retrac0/retelex/mf8/mf8-spec.md

# Six-channel TDM digital voice carrier over differential Manchester

Six 64 kbps channels with a sub-commutated signalling channel in an 8-bit frame.
This is over one twisted pair each way.  It is implemented with discrete 74HC logic.  

A channel slot is a DS0: 64 kbps and octet-aligned, so 
it takes a CVSD voice card, a synchronous data card, or a
G.711 PCM stream.

Every number here was measured by `mf8.py` unless it is marked as analysis.
§15 lists what has not been measured.

> **This is the MF8 used on trunks.** Eight- and ten-bit frames were measured
> (`mf8_16.py`, `mf8_10.py`, `mf8_10_16.py`, `mf8_baud.py`; `exchange/analysis/eight-channel-mf8.md`)
> and are **not taken**.

## 1. What changed from `mfspec.md`, and why

| | `mfspec.md` | this spec |
|---|---|---|
| F bit | `1010`, period 2 | **`11111110`, period 8** |
| Superframe phase pinned by | two S-lane pads, 4 apart | **F itself** |
| Wrong superframe phases admitted | **56 of 64 hook states** | **0** |
| Acquisition | 8 alternating frames + one guard | **32 consecutive good frames** |
| Tracking after lock | *unspecified* | **+2/−1, floor 0, trip 12 — F and guard counted separately** |
| S position | beside F | **half a frame from F (§3.4)** |
| Guard | pads at states 3 and 7, valued as the F word is there | **states 0 and 4 = `0,1` (§3.2)** |
| Squelch / mute | *absent* | **required, §13** |
| Data slot rules | *absent* | **§5** |

The 8-bit geometry, the 6 × 64 kbps payload, the sub-commutated signalling and
the pads-at-binary-boundaries idea are all `mfspec.md`'s and are kept. What is
replaced is the part that decides where the frame is.

---

## 2. Frame and superframe

**Frame — 8 bits, 15.625 µs, 64 kHz:**

```
 bit:   0     1      2      3      4     5      6      7
      [ F ][ C1 ][ C2 ][ C3 ][ S ][ C4 ][ C5 ][ C6 ]
      000   001    010    011   100   101    110    111    <- mux address
```

S sits at bit 4, half a frame from F, and not beside it. That is the one
geometric choice in the frame, and §3.4 is why: the framing check reads F and S,
and at a wrong bit alignment those two reads land on two other lanes 4 apart.
With S beside F, two of the seven wrong alignments read one data card and one
F-word bit, and a single data card can hold either of them open. With S
opposite F, the F word can only ever land on itself.

**Superframe — 8 frames, 125 µs, 8 kHz:**

| state | 0 | 1 | 2 | 3 | 4 | 5 | 6 | 7 |
|---|---|---|---|---|---|---|---|---|
| **F** | 1 | 1 | 1 | 1 | 1 | 1 | 1 | **0** |
| **S** | **0** | A1 | A2 | A3 | **1** | A4 | A5 | A6 |

`An` is channel *n*'s signalling bit; the two fixed S bits are the guard (§3.2).
Signalling is one bit per channel per superframe — **8 kbps per channel**.

The S superframe mirrors the frame: channel *n*'s signalling bit sits at the
superframe state that is channel *n*'s bit position in the frame, so the
signalling multiplexer and demultiplexer use the frame multiplexer's address
map unchanged.

The superframe counter is the only phase state in the system, and it does three
jobs: it addresses the signalling demultiplexer, it carries the framing word,
and it is the octet counter (§6).

---

## 3. The F word

### 3.1 F — the word `11111110`

F carries an 8-bit word across the superframe, so **one check pins both the bit
alignment and the superframe phase.** The word is `11111110`: one zero, at
state 7.

Why this word and not the alternatives this project has already killed. The
figure is the longest run of consecutive frames a payload lane can match the
word, over every superframe phase — acquisition needs 32 in a row, so anything
below 32 is rejected *deterministically*:

| word | CVSD speech | CVSD silence | constant 1 | constant 0 | random |
|---|---|---|---|---|---|
| `10101010` — `mfspec` | 1369 | **8192 (the whole clip)** | 1 | 1 | 12 |
| `11101110` — period 4 | 4 | 3 | 3 | 1 | 14 |
| **`11111110`** | **4** | **3** | **7** | **1** | **20** |
| `11111100` | 5 | 2 | 6 | 2 | 14 |
| `11101100` | 7 | 3 | 3 | 2 | 14 |

`1010` *is* CVSD silence, which is why `mfspec`'s Stage 1 was no filter at all.
A period-4 word cannot pin an 8-state superframe. Of the three period-8 words
that work, `11111110` is chosen because its generator is the cheapest: F is 0
only at state 7, so

```
F = NAND(q2, q1, q0)        one 3-input gate, from the superframe counter
```

and the receiver forms the identical term from its own counter.

### 3.2 The guard — S at states 0 and 4

F alone is not sufficient, because a data card can carry the framing word. The S
lane supplies a second, independent condition: **S = 0 at state 0 and S = 1 at
state 4.**

Each part of that is load-bearing:

- **Same parity** (0 and 4 are both even) **with different required values.** A
  period-2 lane — CVSD silence, and the empty-slot fill — gives the *same* value
  at two same-parity states, so it fails deterministically.
- **Different from the F word at those states.** `11111110` is 1 at both state 0
  and state 4, so a data lane carrying the framing word satisfies F and fails the
  guard. `mfspec`'s pads were `1,0` at states 3 and 7 — *exactly* what the word
  does there — so the guard added no information: **192 of 512 false locks** on
  the F word (384 with S beside F), against **0** here.
- **The mirror.** With the guard at 0 and 4 the six hook bits sit at states 1, 2,
  3, 5, 6, 7 — the positions C1–C6 occupy in the frame — so the '259 and the
  '151 share one address map (§2).

The decode is one gate. States 0 (`000`) and 4 (`100`) are the two with
`q1 = q0 = 0`, and at those two the expected value is `q2` itself:

```
guard enabled  =  NOR(q1, q0)
guard expected =  q2
```

Any two same-parity states with different values pass the two tests above.
`mf8.py guard` measures four layouts, all 64 hook states × 8 skews per cell, and
adds the one thing that separates the clean ones: how often speech at nominal
level satisfies the guard four superframes running, which is what a chance
acquisition on §5's residual case needs.

| guard | decode | F word in every lane | one data card, worst seat | voice, 4 running |
|---|---|---|---|---|
| **0,4 = `0,1` — this spec** | NOR, expect `q2` | **0 / 512** | **0 / 512** | 1 in 499 |
| 3,5 = `1,0` — before §3.4 | `q0·(q1⊕q2)`, expect `q1` | 0 / 512 | 0 / 512 | 1 in 1 200 |
| 3,7 = `0,1` | AND, expect `q2` | 0 / 512 | 0 / 512 | 1 in 459 |
| 3,7 = `1,0` — `mfspec`'s values | AND, expect `/q2` | **192 / 512** | 0 / 512 | 1 in 484 |

Speech satisfies two states four apart more often than two states two apart, so
0,4 takes the residual about 2.4× as often as 3,5 did — and the guard counter
releases it either way (§5). That is the price of the mirror and the one-gate
decode, and it is small: one event in ~500 attempts at one skew, in one allowed
layout, costing a mute of about a millisecond.

**History.** The guard was at 3,5 until §3.4 moved S. With S beside F, 3 and 7
were unusable: a half-superframe shift maps them onto each other, with every
channel off-hook the S lane has a single zero and passes for F at exactly that
shift, and the guard then read *C1* — one data card in seat 1 false-locked on 1
of 512 start-ups, a layout §5 permits. 3,5 has no such symmetry and was chosen
for it. With S half a frame from F that shift reads the F lane instead of C1 and
is dead for any guard (§3.4), which is what freed the choice.

### 3.3 Why the superframe phase can no longer be held wrong

At offset *d* the receiver expects `11111110` and sees it rotated by *d*. For
every *d* ≠ 0 that mismatches at **2 frames in every 8**, so the longest possible
run of good frames is 6 — against the 32 that acquisition requires:

| offset | frames matching of 8 | longest good run |
|---|---|---|
| 0 | 8 | (indefinite) |
| 1 … 7 | 6 | **6, 5, 4, 3, 4, 5, 6** |

**Hook states cannot enter into it**, which is the whole difference from
`mfspec.md`: there the phase was pinned only by two pads gated by hook bits, and
56 of 64 hook combinations admitted a wrong phase. Enumerated here over all 64
hook states: **0 admissible wrong superframe phases.**

### 3.4 Where S sits — half a frame from F

The check reads two bits, F at bit 0 and S at bit 4. At a wrong bit alignment,
skew *d*, the receiver reads bit *d* as F and bit *d*+4 as S, and *which lanes
those are* decides whether the wrong alignment can be held:

| skew | read as F | read as S | |
|---|---|---|---|
| 1, 2, 3 | C1, C2, C3 | C4, C5, C6 | two payload lanes, three seats apart |
| **4** | **S** | **F** (next frame) | **the F word on itself** |
| 5, 6, 7 | C4, C5, C6 | C1, C2, C3 (next frame) | two payload lanes, three seats apart |

At skew 4 the S lane passes for the word only with every channel off-hook
(`01111111` — one zero, at the guard's own state), and the F lane then reads
`1,1` at the guard states, where the guard wants `0,1`. That fails for every
hook state, deterministically. Every other wrong alignment reads two payload lanes, and a
voice or idle lane fails one half of the check or the other (§3.1, §3.2). So a
wrong alignment can be held only when **both** lanes are data cards, three seats
apart — which is §5's rule, and the whole of it.

**With S beside F**, at bit 1 — the previous layout — the table reads
differently. Skew 1 reads S as F and C1 as the guard; skew 7 reads C6 as F and
the *next frame's F* as the guard. Each of those is **one data card plus the
F word**, and the F word is fixed content, so a single data card holds either
open on its own. As found, with the guard then at 3,5:

- **Seat 6, byte `0x7F`.** `01111111` in C6 passes for the word, and the real F
  lane, two states on, reads exactly `1,0` at the guard states. Nothing else is
  involved — not the hook state, not the other seats. With b0 as the MSB that
  byte is **G.711 μ-law silence**, on the very DS0 §6 advertises.
- **Seat 1, any of 64 bytes** (b1 = 1, b3 = 0; `0x40` is one), with every
  channel off-hook. S is `11111011` and passes for the word; the guard then
  lands on C1 two states early and wants 1 at bit 1 and 0 at bit 3.
- **Seat 1 *voice*, every channel off-hook.** The same path with speech under
  the guard, which passes it four superframes running about once in a thousand
  attempts at that skew (§3.2's last column is that rate, per guard) — and once
  acquired, held for good (§4).

Every guard has its own pair of these; under the present 0,4 guard the same two
classes are `0xFB` in seat 6 and the 64 bytes with b1 = 0 and b5 = 1 in seat 1,
which is what `mf8.py sbit` now prints and confirms.

Measured, `mf8.py sbit`: every byte a data card could carry, in every seat,
under all 64 hook states, CVSD idle elsewhere, analytically — a wrong alignment
that passes the check for one superframe passes it forever on periodic lanes —
and then confirmed with the framer, 64 hook states × 8 skews:

| | S at bit 1, beside F | **S at bit 4, this spec** |
|---|---|---|
| one data card: bytes that hold a wrong alignment | seat 1: **64**; seat 6: **1**; seats 2–5: 0 | **0 in every seat** |
| two data cards, the F word in one and every byte in the other: unsafe pairs | every pair containing seat 1 or seat 6, and every adjacent pair — only (2,4) (2,5) (3,5) safe | **(1,4) (2,5) (3,6)** and no others |
| the worst byte in seat 6, framer (`0x7F` under 3,5; `0xFB` now) | **448 / 512** false locks, all held to the end | 0 / 512 |
| the worst byte in seat 1, framer (`0x40` under 3,5; `0x04` now) | **1 / 512** (every channel off-hook), held | 0 / 512 |

None of this was visible to the earlier battery, whose "worst content" was one
fixed pattern at one alignment — the F word, and `00010000` — and both holes
need a different byte. The sweep over every byte is what §5 now runs.

4 is the only spacing that does this. A spacing *s* puts S on F's position at
skew *s* and F on S's position at skew −*s*; those are the same alignment, with
nothing else in it, only when 2*s* ≡ 0 mod 8. It costs nothing: S is a mux
input and a sample strobe, and both move from bit-count 1 to bit-count 4.

### 3.5 A seventh S bit — not in this spec

The guard spends two of the eight S states. One fixed bit cannot replace them:
a single bit cannot reject a period-2 lane, so a data card carrying the F word
holds a wrong alignment beside *idle* at half the idle phases (measured: 4 bytes
in every seat). Two ways of freeing one state were measured at the frame layer
and are recorded here as possible expansions, **not specified**:

| | complement pair | alternating bit |
|---|---|---|
| S lane | `[x][A1][A2][A3][/x][A4][A5][A6]`, x free | `[q3][A1][A2][A3][A4][A5][A6][A7]`, q3 = a fourth superframe-counter stage |
| receiver check | at state 4, S ≠ the '259's Q0 (which holds x from state 0) | at the guard state, S = own q3, read from the line once at acquisition |
| new state | none | a 16-frame phase the receiver must acquire |
| parts | one inverter at TX, one XOR at RX | TX free ('393 stage); RX a loadable `q3` flip-flop, a first-strobe flag and a mux, ≈ 1½ packages |
| holes, every byte × every seat × 128 hook/spare states | 0; pairs (1,4) (2,5) (3,6) as now | 0; pairs as now, even against 16-frame patterns |
| §5's residual, chance acquisition | 1 in 28 attempts | 1 in 10 |
| release by the guard counter | 2.2 ms mean (one check per superframe) | 2.5 ms mean |
| line errors, 3e−02, 3 s | 0 trips; 0.10% down | 0 trips |

The complement pair is the better of the two on every line, and it is what a
seventh bit — a remote-alarm indication, say, since nothing here tells the far
end that this end has lost frame — should be built on. Its cost against the
fixed guard is the residual, 1 in 28 against 1 in ~500, and one check per
superframe instead of two. (A third variant, the complement pair with x
alternating and the receiver checking *both* states against Q0, kills every
8-periodic lane outright but frees nothing and tripped 7 times in 3 s at 3e−02
BER, so it is not recorded further.)

**Decided: x is the remote alarm.** An end holds x at 1 while its own receiver
is not locked (`MUTE`), and a receiver takes x at 1 for 32 ms as the alarm. Idle
is x = 0, which is today's fixed guard. Between exchanges the same bit also
carries SS0's messages (`exchange/proposed/ss0.md`). A message holds x at 1 for 17 ms
at most, so the one 32 ms rule serves both kinds of link. The pair itself is not
yet written into §2–§4 or §11.

---

## 4. Framer

One check, one acquisition counter, two up/down counters. The reference model is
`mf8.framer`.

```
good frame :=  F == word[sfc]
               AND ( sfc != 0  OR  S == 0 )
               AND ( sfc != 4  OR  S == 1 )

acquire    :  the word has exactly one zero, at state 7, so F == 0 IS the phase
              marker.  At a bit alignment with no candidate phase yet:
                  F == 0             -> load sfc = 7, start the count
                  8 frames, no zero  -> this cannot be the F lane, so slip one
                                        line bit and hunt at the next alignment
              With a candidate, the check is predictive; any mismatch slips one
              line bit and restarts the hunt.  Lock at 32 consecutive good frames.

track      :  the same check, +2 bad / −1 good, floor 0, trip at 12 — on two
              counters.  One is fed by every frame.  The other is fed only at
              the guard states, 0 and 4, by the S half of the check alone.
on trip    :  either counter: not locked, slip one line bit, acquire again.
```

**The superframe phase is read, not searched.** That makes acquisition a search
over 8 bit alignments rather than 8 × 8 combinations, and it is what lets slip
recovery be 8–15 frames (§4.2). The 32-frame count is §4's.

**Why +2/−1 and not +1/−1.** A `+1/−1` counter trips only when more than *half*
of frames fail. At a wrong alignment this check fails at almost exactly half —
the word is seven ones and one zero, so a random payload lane matches it 50% of
the time — and the counter random-walks instead of climbing. Measured over the
line at 10 impulses/s, a transient false lock held **28 050 frames** with
`+1/−1`. `+2/−1` trips above a *third*, which that 50% clears easily, and
§4 measured `+2/−1` as the correct pairing for a **predictive**
check, where one line error spoils one frame rather than four. §4.2 shows it
costs nothing in false reframes.

Both of these were found by running the chain end to end (§7). Neither was
visible at bit level: on clean data the old search locked at frame 31 and the old
counter never tripped.

**Why a second counter for the guard.** The guard is 2 checks in 8. On the frame
counter, a lock whose F check always passes and whose guard *never* does gains 4
and loses 6 per superframe: it peaks at 3 against a trip of 12 and holds
forever. With one counter, then, the guard protects acquisition and nothing
else, and any wrong alignment that passes the word deterministically but the
guard only by chance — a data card carrying the F word three seats from a voice
card, §5 — is permanent once acquired. Fed by the guard states alone, the second
counter trips above a third of *guard* checks failing. Voice under the guard
fails about half of them, and §5 measures the release in milliseconds; line
errors at 3e−02 fail 3% of them, and §4.2 measures 0 trips in 6.25 s. It is one
more 74HC193, clocked by the guard enable the decode already produces (§11).

### 4.1 False locks — measured

Every start-up skew, every payload class this project has used to break a framer,
plus the adversarial case constructed against *this* F word:

| payload | locks | **false** | wrong sf phase | acquisition, frames |
|---|---|---|---|---|
| speech | 8/8 | **0** | **0** | 37–54 |
| idle (CVSD silence) | 8/8 | **0** | **0** | 37–54 |
| all constant 0 | 8/8 | **0** | **0** | 37–46 |
| all constant 1 | 8/8 | **0** | **0** | 38–78 |
| random data | 8/8 | **0** | **0** | 37–54 |
| octet `10110010` | 8/8 | **0** | **0** | 37–54 |
| one data card + idle | 8/8 | **0** | **0** | 37–54 |
| one data card + speech | 8/8 | **0** | **0** | 37–54 |
| **the F word as data** | 8/8 | **0** | **0** | 38–86 |
| the F word beside silence | 8/8 | **0** | **0** | 37–62 |
| **the F word three seats from a guard-satisfying pattern** | 8/8 | **3** | **0** | 37–38 |
| `0xFB` in seat 6, rest idle — §3.4's first hole, under this guard | 8/8 | **0** | **0** | 38–54 |
| `0x04` in seat 1, rest idle — §3.4's second hole, under this guard | 8/8 | **0** | **0** | 37–46 |

Exhaustively over all 64 hook-state combinations × all 8 skews — 512 trials per
row — **0 false locks and 0 wrong superframe phases** on idle, both constants,
one data card, the F word in every lane, the F word beside silence, and both of
§3.4's holes.

**The F-word-and-pattern row is the exception, and it is not closed by the
framer.** Two data cards *three seats apart*, one carrying the framing word and
the other a pattern that satisfies the guard, hold a wrong alignment: 3 of 8
skews here, 192 of 512 exhaustively. At a wrong alignment the F check lands on
one lane and the guard on the lane three seats on (§3.4), so with both lanes
unconstrained there is nothing left to gate them. **No confirmation count
reaches it** — the match is exact, not probabilistic — so it is closed by a slot
rule instead. That is §5, and it is the one real cost this frame carries.

Acquisition is **37–86 frames, 0.58–1.3 ms** at a 64 kHz frame rate.

### 4.2 Line errors and slip recovery — measured

6.25 s of random payload, tracking with both `+2/−1` trip-12 counters:

| line BER | locked frames | **LOF events** | of which the guard counter | off-phase frames | time down |
|---|---|---|---|---|---|
| 0 | 399 961 | **0** | **0** | **0** | 0.01% |
| 1e−04 | 399 961 | **0** | **0** | **0** | 0.01% |
| 1e−03 | 399 937 | **0** | **0** | **0** | 0.02% |
| 1e−02 | 399 937 | **0** | **0** | **0** | 0.02% |
| **3e−02** | 399 801 | **0** | **0** | **0** | 0.05% |

Zero loss-of-frame events to 3e−02, which is §4's standard, and **the guard
counter never trips on line errors**: at 3e−02 it sees 3% of its checks fail
against the third it needs. For contrast, `mfspec.md` with no counter took
**10 011 unlocks and 60.7% downtime at 1e−02** on the same class of line (§4).

Recovery after an induced slip, every slip size:

| slip, bits | 1 | 2 | 3 | 4 | 5 | 6 | 7 |
|---|---|---|---|---|---|---|---|
| frames misaligned | 12 | 8 | 8 | 10 | 11 | **13** | **13** |

**Worst case 13 frames = 0.20 ms.** Reading the superframe phase
from the marker rather than searching for it is what does this: there is no
second phase to re-find, so recovery costs little more than re-finding the bit
alignment. (An earlier nested-search version of §4 measured 35–176 frames here.)

---

## 5. Slot rules

One rule, and it is measured rather than argued:

> **Two data cards may not sit three slots apart: not 1 and 4, not 2 and 5, not
> 3 and 6.**

A voice channel is CVSD and cannot hold a wrong alignment. A data card can carry
anything, including the framing word — and at a wrong alignment the F check lands
on one lane while the guard lands on the lane *three seats on* (§3.4), so two
data cards three apart can satisfy both halves with neither constrained. §3.4
shows that is the only way the check can be held, so it is the only rule.

`mf8.py seats` measures it three ways.

**Exhaustively, over content.** Every byte a data card could carry, in every
seat, under all 64 hook states, CVSD idle elsewhere, checked analytically: a
wrong alignment that passes the check for one superframe passes it forever on
periodic lanes, and no tracking rule can then see it.

| layout | wrong alignments held |
|---|---|
| one data card, **any** seat, **any** of the 256 bytes | **0** |
| two data cards, the F word in one and **every** byte in the other — (1,2) (1,3) (1,5) (1,6) (2,3) (2,4) (2,6) (3,4) (3,5) (4,5) (4,6) (5,6) | **0** |
| two data cards, **(1,4) (2,5) (3,6)** | **held**, for 65 of the 256 bytes in either seat, under every hook state |

**With the framer**, all 64 hook states × 8 skews, 512 start-ups per row, the F
word as the data card's content and voice elsewhere:

| layout | false locks | still wrong at the end |
|---|---|---|
| one data card, **any** seat | **0 / 512** in every seat | 0 |
| two, the F word and a guard-satisfying pattern (`0x08`: bit 0 = 0, bit 4 = 1), **adjacent**: (1,2) (3,4) (5,6) | **0 / 512** | 0 |
| six data cards, ordinary **random** content | **0 / 512** | 0 |
| **two, the same content, three apart: (1,4) (2,5) (3,6)** | **64, 128, 192 / 512** | **all of them** |

Note the third row: **ordinary data is safe in every seat.** The hole needs the
framing word specifically, not merely arbitrary content, which is why the rule is
about spacing and not about scrambling.

**The residual, and the guard counter.** The rule is about two data cards. A data
card carrying the F word three seats from a *voice* card is allowed, and the
guard then lands on speech, which satisfies it by chance: at nominal line level
both guard bits fall right in about 20% of superframes, and four superframes
running — what acquisition needs — about once in 499 attempts at that skew.
That is what §4's second counter is for. Forced at 24 such points, 0.5 s runs:

| tracking | acquired | released after | mean | never released |
|---|---|---|---|---|
| frame counter only | 24 / 24 | — | — | **24** |
| **frame counter + guard counter — this spec** | 24 / 24 | **34–170 frames** | **1.29 ms** | **0** |

Each release is followed by a hunt that finds the true alignment; the cost of the
event is a mute of a few milliseconds, not a call with the wrong channels in it.

This is the same kind of rule a 4-bit static framing word needs ("any seat, but
never two adjacent"); here the forbidden spacing is three because S is at bit 4.
A frame that carries a signalling bit in *every* frame can avoid needing it, by
jumpering that bit high so one half of the check is never arbitrary data — a bit
this frame does not have, because signalling is sub-commutated into the
superframe. **That is the price of §2's efficiency, stated plainly: three data
cards of six, not six — 1,2,3 or 4,5,6, or any three with no two three apart.**

---

## 6. Octet alignment — the slot is a DS0

The superframe counter is **already the octet counter.** It has 8 phases, a
channel takes one bit per frame, so superframe state *k* is bit *k* of that
channel's octet:

```
superframe state   0   1   2   3   4   5   6   7
signalling S       0  A1  A2  A3   1  A4  A5  A6    -> the '259 address
channel n octet   b0  b1  b2  b3  b4  b5  b6  b7    -> the byte boundary
```

At a 64 kHz frame rate the superframe rate is 64/8 = **8 kHz, the PCM sample
rate exactly**, so one superframe carries one sample. A PCM card is a shift
register clocked by the frame clock and transferred at state 7 — one 74HC164 and
a latch per channel.

This matters because a framer that establishes bit alignment and slot identity
establishes nothing coarser, so a plain synchronous pipe is not octet-aligned and
the endpoints must find their own byte phase. Here it is aligned, for no extra
logic, and the slot is a true DS0 rather than merely a 64 kbps pipe.

**It depends entirely on §3.3.** If the superframe phase could be held wrong — as
it could in `mfspec.md` — a wrong phase would rotate every PCM sample and produce
garbage audio on a link that is otherwise bit-perfect. The phase is worth pinning
properly for signalling alone; carrying octets on it makes that mandatory.

---

## 7. End to end, over the line

`mf8_line.py`. Six independent LibriSpeech talkers → CVSD 64 kbps → the mf8
frame → a real waveform in both line codes → 1.8 MHz cable → impairment →
receiver → framer → per-channel CVSD decode. 1.0 s clips.

segSNR is scored inside the **longest contiguous locked run**, against the same
codec bits over the **same window** with no link in the path, so the "Δ" column
is what the *carrier* adds. The frame offset is found rather than assumed,
because a slip re-phases the stream and can rotate the channel slots.

### 7.1 A clean line is transparent

| code | segSNR | down | LOF | Δ mean | Δ worst | max BER |
|---|---|---|---|---|---|---|
| differential Manchester | 22.52 dB | 0.06% | **0** | **+0.00** | **+0.00** | **0** |
| AMI | 22.52 dB | 0.06% | **0** | **+0.00** | **+0.00** | **0** |

Per channel, differential Manchester:

| channel | 1 | 2 | 3 | 4 | 5 | 6 |
|---|---|---|---|---|---|---|
| segSNR | 21.05 | 14.90 | 29.33 | 24.64 | 15.28 | 29.89 |
| vs codec | **+0.00** | **+0.00** | **+0.00** | **+0.00** | **+0.00** | **+0.00** |
| bit BER | 0 | 0 | 0 | 0 | 0 | 0 |

**The carrier adds exactly nothing**, in either code. The 15–30 dB spread across
channels is the talkers' own crest factors, not slot position — the Δ row is
+0.00 for all six. Isolation: off-diagonal 0.134 against a source-correlation
floor of **0.129 measured on the same 1.0 s window**, an excess of +0.005. (The
0.009 floor in §9.3 is for 30 s clips; a short window
correlates more by chance, and reading an off-diagonal against a mismatched floor
is the error that section records.) With BER identically zero the recovered bits
*are* the transmitted bits, so crosstalk is exactly zero by construction and the
matrix can only report its own floor.

### 7.2 Noise — and the two codes fail differently

| condition | differential Manchester | AMI |
|---|---|---|
| sd 0.3 | +0.00 dB, 0 LOF | +0.00 dB, 0 LOF |
| sd 0.4 | **+0.00 dB**, 0 LOF | −0.10 dB, 0 LOF |
| sd 0.5 | **+0.00 dB**, 0 LOF | **−3.63 dB**, 0 LOF |
| sd 0.6 | **−0.01 dB**, 0 LOF | **−12.74 dB, 1 LOF** |
| sd 0.7 | −0.50 dB, **4 LOF**, 600 ms clean | chopped, 23 LOF |
| impulse 1/s | +0.00 dB, 0 LOF | +0.00 dB, 0 LOF |
| impulse 10/s | −0.00 dB, 5 LOF | −0.49 dB, 0 LOF |
| impulse 100/s | chopped, 71 LOF | −7.77 dB, 10 LOF |
| atten 0.25 | **+0.00 dB**, 0 LOF | −0.10 dB, 0 LOF |
| atten 0.12 | chopped, 431 LOF | chopped, 51 LOF |

Differential Manchester is transparent to sd 0.6 where AMI is degraded from 0.4,
which is `line-codes.md` §3's raw-BER result now heard as audio.

**The interesting column is not which is better but how each fails.** AMI's
audio falls first — 3.6 dB down at sd 0.5 with the link up — and by sd 0.6 it
is 12.7 dB down and losing frame as well. Differential Manchester holds both to
sd 0.6 and then breaks: at sd 0.7 its audio inside a clean stretch is only
−0.50 dB, but the link drops four times in a second. **AMI degrades in fidelity first;
differential Manchester degrades in continuity only.** That is the same split
`line-codes.md` §4.3 found under impulse noise, and it holds on a Gaussian floor
too. For voice behind a mute (§11), continuity is the one that is audible as
damage, which is a point in AMI's favour that the raw margin figures hide.

**The marginal cells move between noise realizations.** The run before this
one, with S beside F, had AMI at sd 0.6 with 0 LOF and −16 dB; moving S changed
the line bits under the same seeded noise, and this run has 4 LOF. Re-running
the old layout with a second seed also gives 4, and the impulse 10/s cell gives
5 or 8 LOF by seed under either layout. The guard counter (§4) is not involved:
on the same received bits it trips 0 times in every cell here, and the frame
counter alone gives identical counts. What is stable is the order in which the
two codes fail; the LOF count in any one marginal cell is one draw.

**The codec law moved this table (§12.1).** It changes every payload bit, so the
line bits under the same seeded noise change too, and the LOF counts are a new
draw — 4 and 5 LOF where the previous law had 5 and 5, 1 where it had 4. What
did not move by chance is the Δ at a given error rate. Differential Manchester
at 10 impulses/s has the same 4.9e−04 bit error rate and the same 5 LOF under
both laws, and costs −0.00 dB where the previous law cost −1.83. AMI at sd 0.5
went from −5.35 to −3.63 dB at the same order of BER. That is the 1 ms
integrator forgetting an error three times sooner, `cvsd_law.py laws`' bit-error
columns heard over the line. Run on the previous law, this battery reproduces
its old log to the last digit.

### 7.3 What this found in the framer

Both defects in §4 were found here and are invisible at bit level:

| | symptom on clean data | symptom over the line |
|---|---|---|
| nested acquisition search reached only even superframe offsets | lock at frame 31 | lock at frame **41 082** after one impulse-induced slip |
| `+1/−1` counter against a check that fails at 50% | never tripped | transient false lock held **28 050 frames** |

Neither would have been caught by any amount of further bit-level testing. That
is the argument for this section existing.

---

## 8. Rates and the family

F + S + N channels must be a power of two, so **N = 2, 6, 14**.

| frame | N | per-channel | line | baud | capacity | reach | superframe |
|---|---|---|---|---|---|---|---|
| 4 b | 2 | 64k | 256k | 0.512 M | 128k | **1.00×** | 4 fr |
| **8 b** | **6** | **64k** | **512k** | **1.024 M** | **384k** | 0.71× | **8 fr** |
| 8 b | 6 | 32k | 256k | 0.512 M | 192k | **1.00×** | 8 fr |
| 16 b | 14 | 32k | 512k | 1.024 M | 448k | 0.71× | 16 fr |

**This spec is N = 6 at 64 kHz.** It is the only mode that is one-for-one with a
DS0 (§6). Reach is the √f law scaled to `frame-rate.md` §1's reference — ratios
sound, kilometres not measured. `frame-rate.md` analyses the choice; the short
version is that line rate sets reach and frame length decides how it is divided,
so 64 kbps channels are available at any reach, at two of them for 1.00× or six
for 0.71×.

Only N = 6 is specified here. The other frame lengths need their own F word and
guard positions, and the mis-jumper case between them is **not measured**.

---

## 9. Line code — differential Manchester

Unchanged from §9, and not re-measured; the frame layout cannot affect
the line code.

- Transition at **every** cell boundary. This is the clock.
- An additional transition at mid-cell **iff** the data bit is 0.

At 512 kbps: **1.024 MBaud**, 977 ns half-cell, 512 kHz maximum fundamental.
Two-level, DC-free with disparity bounded at ±1 cell, polarity-blind (verified
bit-identical under a tip/ring swap, `line-codes.md` §12), and a transition every
bit so clock recovery never starves.

**Oscillator: 4.096 MHz.** It divides every family rate exactly and reaches the
2.048 MHz half-bit clock the top rate needs. Note that `mfspec.md` §2 specified a
512 kHz master clock, which is *half* what the modulation requires — a half-bit
clock at 1.024 MHz cannot be divided down from 512 kHz.

`line-codes.md` records the one open question: AMI is measured better under
impulse noise and worse on Gaussian noise and attenuation, and which matters is a
plant measurement nobody has made.

### 9.1 Oscillator and clock chain

**4.096 MHz**, a standard E1-family value. It is the lowest crystal that reaches
the 2.048 MHz half-bit clock of the fastest family rate, with the one divide a
Pierce oscillator's duty cycle needs. Nothing on the card needs a faster clock.

```
4.096 MHz ─→ 74HC4040 prescaler ─→ RATE jumper ─→ LINE_HB, half-bit clock
                                                       │
                                                 ÷2 ─→ H, line bit clock
```

| rate jumper | line rate | LINE_HB (half-bit) | H (line bit) |
|---|---|---|---|
| Q1 | 1024 kbps | 2.048 MHz | 1.024 MHz |
| **Q2** | **512 kbps — this spec** | **1.024 MHz** | **512 kHz** |
| Q3 | 256 kbps | 512 kHz | 256 kHz |
| Q4 | 128 kbps | 256 kHz | 128 kHz |
| Q5 | 64 kbps | 128 kHz | 64 kHz |

The frame counter is clocked from H rather than taken as a tap on the prescaler.
The rate jumper moves the half-bit tap, so on one ripple chain the frame counter
would move with it and the mux address would need a matrix of jumpers. Re-clocked
from H, its bits sit on fixed pins at every jumper. **That one 74HC393 is the whole
price of the rate jumper.**

**Accuracy is nearly irrelevant.** The far-end receiver tolerates ±13% of a cell
and the oscillator contributes ~0.01%. Specify the crystal for unit-to-unit
repeatability, not accuracy.

**Ripple.** The skews that matter are within the frame counter, two or three
stages of a '393 — tens of nanoseconds against a settling budget of half a cell,
977 ns here. Scope it at bring-up.

### 9.2 Encoder circuit — one gate, one flip-flop

§9.2, unchanged. Let `H` be the half-cell phase (0 in the
first half of a line cell, 1 in the second) and `LINE_HB` the half-bit clock:

```
        line bit ──┐
                   ├── NAND ──> EN ──┬── J ┐
        /H ────────┘                 └── K ┤ 74HC74/109  ──> line
                                           │  clocked by LINE_HB
        LINE_HB ────────────────────────────────┘

EN = NAND(/H, line bit) = H OR NOT(line bit)
```

| H before edge | line bit | EN | behaviour |
|---|---|---|---|
| 1 | 0 | 1 | entering a new cell — boundary transition, always |
| 1 | 1 | 1 | entering a new cell — boundary transition, always |
| 0 | 0 | 1 | mid-cell — transition, encoding a 0 |
| 0 | 1 | **0** | mid-cell — **hold**, encoding a 1 |

A JK wired J = K = EN toggles when EN is high and holds when it is low, which is
exactly the code. H and the flip-flop are both clocked from LINE_HB; the JK samples
H's value from *before* the edge, so same-edge synchronous clocking is correct,
but it depends on the divider's clock-to-Q exceeding the JK's hold time. 74HC
satisfies that comfortably — **check it against the specific parts, because a
hold violation works on a warm bench and fails at temperature.**

### 9.3 Output stage and line interface

| item | specification |
|---|---|
| Driver | 75176 differential transceiver, driver half |
| Series matching | two ~50 Ω resistors into the 100–135 Ω pair, ~25 mA from a 5 V swing; trim against the actual cable |
| Slew limiting | **150 ns edges**, one series R with a shunt C, switched by the rate jumper. At 1.024 MBaud that is 15.4% of a 977 ns half-cell — still inside the eye, but tighten toward 75 ns if the eye matters more than radiated emissions. Do not skip it: a raw 75176 edge into outside plant is unnecessarily noisy |
| Transformer | 1:1, **centre-tapped on the line side, `L/R ≥ 2.5 cells`**, R being what the magnetizing inductance sees: about 50 Ω with both ends terminated, 100 Ω pessimistic. At the 64 kbps line rate that is **≥ 4 mH**; below 2.5 cells errors begin at the sd 0.4 design limit. Volt-time: about 11 V·µs per volt on the pair at 64 kbps, 15 from rest. **Murata 78615/9C** (1CT:1CT, 10 mH min, 56 V·µs, 6-pin DIP, active) meets it at every rate of the family, and at 64 kbps it is indistinguishable from no transformer, 44.5 µH leakage included. Measured by `subline.py xfmr`. The earlier ≥ 33 mH was 5% droop by arithmetic; the receiver times transitions and does not need it |
| Centre tap | brought out to an unpopulated footprint for a simplex feed. DC injected there is common-mode and the ampere-turns cancel. **Specify it now** — retrofitting means a new transformer |
| Protection | gas tube to ground on both conductors, series PTC or fuse, TVS. **The TVS must clamp above the eventual 48 V feed voltage**, not above signal level |
| Termination | the pair's characteristic impedance, 100–135 Ω, on the line side of the comparator. A receiver must never look like a bridged tap |
| Preamp / equaliser | footprint, unpopulated on short spans; populate when span loss leaves under about 0.5 V at the comparator |

**Deliver about a volt to the comparator.** Its hysteresis is fixed in millivolts
(~50 mV for a 75176-class receiver), so what matters is the *ratio* to received
amplitude — and §7.2's attenuation rows are that ratio running out. A single span
tolerates 20%; **specify ≤ 10%**, which is 0.5 V for 50 mV of hysteresis.

### 9.4 Decoder circuit — no PLL, no clock

§9.4, unchanged. The receiver times the gap between transitions
against two thresholds. There is no clock anywhere on the receive timing path.

```
on each transition from the comparator:
    if less than DEAD since the last ACCEPTED transition:   ignore it
    otherwise accept it:
        if more than 0.75 cell since the previous accepted: emit 1, clear MID
        else if MID is set:                                 emit 0, clear MID
        else:                                               set MID
```

A 1 bit has no mid-cell transition, so its gap is a full cell. A 0 bit produces
two half-cell gaps, and the MID flip-flop pairs them. **The state self-heals:**
any full-cell gap clears MID, so a disturbed state recovers within a couple of
bits and there is no lock to lose.

| function | part |
|---|---|
| Line interface | transformer, then two RC sections at the symbol rate |
| Comparator | hysteresis ≤ 10% of received amplitude (≈1 V at a 50 mV comparator) |
| Transition detector | 74HC86: comparator output XOR a short RC-delayed copy — one pulse per transition |
| Dead-time timer | ½ 74HC221, **non-retriggerable**, 0.2 cell |
| Classifier timer | ½ 74HC123, **retriggerable**, 0.75 cell |
| LONG sample, MID state | 74HC74 |
| Bit strobe | accepted transition gated by `LONG + MID`; recovered bit = LONG |

| parameter | specify | usable range |
|---|---|---|
| Classifier threshold | **0.75 cell** | ±13% at the sd 0.4 design limit |
| Dead time | **0.2 cell** | 0.05–0.30 cell to sd 0.5 |
| Comparator hysteresis | ≤10% of received | 20% on a single span |
| Carrier-detect timeout | 2 cells | never trips on signal |

A 1% resistor and a 2% C0G capacitor give ±3% against the ±13% needed. **Check
the timer IC's own pulse-width tolerance against the remaining ±10%** before
committing. At 1.024 MBaud the absolute window is ±98 ns, where layout stray
capacitance stops being negligible — scope it at bring-up.

**Sample, then retrigger.** At each accepted transition the classifier timer's
state must be captured before that same transition retriggers it. The timer's
trigger-to-output delay gives the flip-flop its hold margin; confirm it against
the specific parts, as §9.2 does for the encoder.

### 9.5 Input filter

A low-pass ahead of the comparator sets how much line noise reaches the slicer,
and **it must move with the rate** — a filter left at the fastest setting puts a
slow line rate at many times its symbol rate and throws its noise advantage away.

**Specify: two first-order RC sections, corner at the symbol rate** — 1.0 MHz
here. Two RC sections reach within one grid step of a second-order Butterworth
optimum and hold it from 0.75× to 1.5× the symbol rate, so component tolerance
does not matter. Buffer them, or make the second section's R at least ten times
the first so it barely loads it.

### 9.6 Carrier detect

A retriggerable timer (the other half of the '123), retriggered by every
comparator transition, timeout **2 cells**. Timed out means no carrier. A valid
line has a transition every cell by construction and never trips it; the
quiet-noise case that makes squelch mandatory (§12) reads as no carrier 92% of
the time.

**Feed no-carrier into the framer as a forced loss of frame**, not only into the
mute OR. Every timeout then drops lock and the mute is held until 32 good frames.
Without that, a detector flickering at 92% would chatter the mute.

### 9.7 Rate plug

Five components move with the line rate. Put them on a **plug-in header, one plug
per rate**, so a rate change swaps all five and none can be left behind:

| line rate | symbol rate | filter corner | classifier, 0.75 cell | dead time, 0.2 cell | carrier timeout |
|---|---|---|---|---|---|
| 1024 kbps | 2.048 MBaud | 2.0 MHz | 732 ns | 195 ns | 1.95 µs |
| **512 kbps — this spec** | **1.024 MBaud** | **1.0 MHz** | **1 465 ns** | **391 ns** | **3.9 µs** |
| 256 kbps | 512 kBaud | 512 kHz | 2 930 ns | 781 ns | 7.8 µs |
| 128 kbps | 256 kBaud | 256 kHz | 5 859 ns | 1 563 ns | 15.6 µs |
| 64 kbps | 128 kBaud | 128 kHz | 11 719 ns | 3 125 ns | 31.3 µs |

**The receiver's rate must match the FAR end's transmitter**, not this end's. The
two directions are independent and may run different rates, so the rate plug is
set per direction.

---

## 10. Transmitter

```
4.096 MHz ─→ 74HC4040 ─→ RATE jumper ─→ half-bit clock ─→ biphase encoder
                                              │
                                        ÷2 ─→ H, line bit clock
                                              │
                            3-bit frame counter (bit position in frame)
                                              │ wrap
                            3-bit superframe counter  q2 q1 q0
                                     │                     │
                          F = NAND(q2,q1,q0)        S mux address
```

| function | part | notes |
|---|---|---|
| Prescaler and rate tap | 74HC4040 | one per card |
| Frame + superframe counters | 74HC393 | 3 stages each, both halves |
| Frame mux | 74HC151 | in0 = F, in4 = S mux, in1–3 = C1–C3, in5–7 = C4–C6, addressed directly |
| Signalling mux | 74HC151 | addressed by the superframe counter; input 0 tied low, input 4 tied high, A1–A6 on inputs 1–3 and 5–7 — the frame mux's map |
| F generator | ⅓ 74HC10 | one 3-input NAND |
| Biphase encoder | ½ 74HC74 + ¼ 74HC00 | §8.1 |
| Driver | 75176 | §8.1 |
| **Total** | **≈ 6 packages** | |

The framing bits are **mux inputs, not an override**. §9.2
puts the framing field last so the mux address needs no arithmetic, and pays for
it with an S/T select gate, a framing-data AND and an output selector. Here the
address is still offset-free *and* the override path disappears: C1–C3 wire to
inputs 1–3 and C4–C6 to inputs 5–7, with S on input 4, which is layout rather
than logic. A gate-level model reproduces the frame bit-for-bit (§4).

**One race to watch.** F is a superframe-counter output read at bit-count 0,
which is when that counter has just ticked. Clock the superframe counter off the
opposite edge, or from the 7→0 transition of the frame counter.

---

## 11. Receiver

| function | part |
|---|---|
| Interval classifier | §8.2 — '86, '221, '123, '74 |
| Superframe counter | ½ 74HC393 |
| Expected F | ⅓ 74HC10 — `NAND(q2,q1,q0)` |
| Guard decode | ¼ 74HC02 — enable `NOR(q1,q0)`, expected `q2` straight off the counter |
| Compare and good-frame gate | 74HC86 / 74HC08 remainder |
| Acquisition count to 32, rephase count to 8 | ½ 74HC393 |
| Loss of frame, +2/−1 floor 0 trip 12, every frame | 74HC193 — up on bad, down on good, carry = trip |
| Loss of frame, +2/−1 floor 0 trip 12, guard states only | 74HC193 — clocked by the guard enable `NOR(q1,q0)`; either carry drops lock (§4) |
| Lock state | ½ 74HC74 |
| Signalling demux | 74HC259, addressed by the superframe counter, 6 of 8 used |
| Channel demux | frame counter, shared; S is sampled at bit-count 4 |
| **Total** | **≈ 10 packages** |

Everything except the interval classifier is shared with, or the same shape as,
§9.4's. The framer is about six of those ten packages — **a framer, not a
package-count problem.**

---

## 12. Channel cards

A slot takes one of three cards. All use the same backplane signals: the frame
clock, a C bit in and out, an A bit in and out, and the mute line — the slot
interface is `mf8-backplane.md` §3. The cards themselves — the CVSD subscriber
line card, the analog FXS/FXO card and the data card — are `channel-cards.md`; this
section is the engine they share and the rules they obey.

### 12.1 CVSD voice card

Semi-analog CVSD, E&M four-wire. **The law is MIL-STD-188-113's — the DNVT's —
run at 64 kbps.** The card's components set slew, not step size, so the same
card runs at any family rate with no jumper.

| parameter | this card | MIL-STD-188-113, at 16 and 32 kbps |
|---|---|---|
| bit rate | set by the mode — **64 kbps here** | 16, 32 kbps |
| run window | 3 bits, run-of-threes | 3 bits, run-of-threes |
| τ_syl | 5 ms | 5 ms ± 1 |
| τ_int | **1 ms** | 1 ms ± 0.25 |
| compression | **16:1** between the steps at 30% and 0% run-of-threes — **51:1, 34.2 dB, full scale** | 16:1, 12:1 to 21:1 |
| slew | **16 000** full-scale units/s | set per rate by the 0 dBm0 pattern |

| component | value | note |
|---|---|---|
| `C_int` | 10 nF film | |
| `R_int` | **100 kΩ** | τ_int = 1 ms |
| `Iabc` max | **160 µA** | `slew · C_int` — **the bit rate cancels** |
| `Iabc` min | **3.1 µA** | 51:1; the smallest step on `C_int` is 4.9 mV |
| `C_syl` | 100 nF film, **2%** | |
| `R_syl` | **49.9 kΩ** | τ_syl = 5 ms |

Encoder on one card, decoder on another (`tolerance.py`, 64 kbps, within 1 dB
of a matched pair, worst of two sources):

| network | tolerance | failure mode |
|---|---|---|
| integrator R·C | ±30% | **a first-order bass shelf**, −0.9 dB at 300 Hz at −30% — linear, and undone exactly by its inverse. segSNR counts it as noise and would say ±5%; the standard's own insertion-loss mask allows ±1 dB from 300 Hz at 32 kbps |
| **syllabic R·C** | **±10%** | distortion — the binding spec |
| `I_min` alone | ±10% | a gain that follows the signal level |
| step size, `I_max` and `I_min` together | ±30% | **pure gain error, no distortion at all** |

1% resistors with a 2% `C_syl` hold the syllabic network to ±6% card to card,
where a 5% capacitor would be ±12%. `I_min` is whatever the `Iabc` drive
makes it: `cvsd-codec.md` §3.1's drive holds 51:1 with its ratio resistors
at 51.1 kΩ and 2.55 MΩ (50.9:1; 50.1 kΩ in parallel, 5 ms on 100 nF), but its
control voltage at `I_min` falls from 157 to 98 mV, so its op-amp's offset counts
1.6 times as much — a low-offset part, or trim.

**Why this law.** 64 kbps, three talkers, segSNR (`cvsd_law.py laws`):

| law | −30 dB | −20 dB | nominal | +6 dB | BER 1e−3 | BER 1e−2 |
|---|---|---|---|---|---|---|
| previous: 30 dB full scale, τ_syl 6 ms, τ_int 3 ms | 16.6 | 21.3 | 21.3 | 16.8 | 15.0 | 5.3 |
| previous, τ_int 1 ms | 16.7 | 21.4 | 22.6 | 16.7 | 18.0 | 8.8 |
| **this card** | **21.2** | **24.3** | **23.1** | **16.9** | **18.4** | **9.1** |

The integrator buys the bit-error columns — the decoder forgets an error three
times sooner — and costs nothing clean; the ratio buys the quiet columns and
costs nothing loud. Over the line that integrator is §7.2's recovered cells. On
a plesiochronous slip, a dropped bit is now a −30 dB transient that settles in
1.2 ms, where it was −25 dB and 5 ms (`mf8-backplane.md` §7).

**The slew is 16 000, not the 12 000 this section gave before.** 12 000 was one
setting for every family rate. At the only rate this frame runs it moves the
card's best level down: 4.1 dB worse at nominal level (19.0 against 23.1),
2.2 dB better at −30 dB. Slew and input level are one knob — scaling one is
scaling the other — so in practice the card's level trims set it, against
`mf8.NOMINAL_RMS` (`channel-cards.md` §3.1).

**The ratio is quoted two ways, and the standard contradicts itself.** Its §5.5
quotes the ratio between the syllabic filter's outputs at 30% and 0%
run-of-threes. A drive, and `cvsd.py`, set it full scale, 0% to 100%, so
16:1 is 1 + 15 / 0.30 = 51:1. The standard's own decoder test — Table F-1,
`FB412` and `DB492` repeating at 16 kbps, 800 Hz — wants those two patterns'
outputs 24 ± 2 dB apart. But at one fixed step the 30% pattern swings
1.9 times as far as the 0% pattern (the standard's §3.9 example implies 2.1),
so a 16:1 step ratio decodes 29.5 dB apart, and a decoder that passes Table F-1
has a step ratio of about 8.5:1. No decoder meets both. **This card follows
§5.5**, the step ratio, which is what components set. Table F-1's reading,
28.3 dB full scale, would cost 6.5 dB at −30 dB (14.7 against 21.2). Which one
a real DNVT builds is a bench measurement (§15), and it matters only for the
bit-exact interworking below.

**Carried to 64 kbps.** The standard specifies 16 and 32 kbps. Its time
constants are real time — its syllabic filter "is independent of the sampling
rate" — and its ratio is a ratio of two currents, so neither knows the bit rate.
One parameter at a time at 16, 32 and 64 kbps (`cvsd_law.py rates`):

- **Ratio**: wider is better at every rate, out to 42 dB, with no optimum
  inside. The model has no floor under `I_min`; the real one is analog — offset
  and leakage against a 3 µA current — which is why the card stops at the
  standard's figure.
- **Window**: a count of bits, and it stays one. 12 bits at 64 kbps is the
  standard's window in time at 16 kbps, and costs 7.6 dB at nominal (15.5
  against 23.1); 6 bits at 32 kbps costs 3.6. 4 bits gains 0.1–0.6 dB on the
  level mean at each rate but costs 1.8 dB at nominal at 64 kbps.
- **τ_int**: shorter is better under bit errors at every rate, and neutral
  clean. 0.5 ms would add another 1.9 dB at BER 1e−2, outside the standard's
  tolerance.
- **τ_syl**: flat at 16 kbps; at 64 kbps 2.5 ms is 0.5 dB better on the level
  mean and 1.0 at nominal. The one parameter that leans with the rate, by half a
  dB, and outside the standard's 4–6 ms. The card keeps 5 ms.

Nothing in the law is tied to its rate. The one rate-bound setting is the
reference level, which the standard fixes per rate with its patterns and this
card fixes with its slew — the standard's two rates hold the slew equal to
0.6 dB, where `mf8.SLEW` raises it with rate.

**A DNVT on this channel.** Both ends on this law, the DNVT at its own rate,
m = 64 / its rate; segSNR against the source (`cvsd_law.py dnvt`):

| path | 32 kbps DNVT | 16 kbps DNVT |
|---|---|---|
| the DNVT alone — the reference | 16.7 | 10.8 |
| DNVT → trunk: each bit repeated m times, into this card | 5.4, **7.8 dB loud** | 1.4, **16.5 dB loud** |
| … into a decoder with a 3m-bit window | 15.3 | 9.7, 4.0 dB loud |
| … transcoded on the card | **16.2** | **10.8** |
| trunk → DNVT: every m-th bit | **0.0**, integrator on the rail | **0.0** |
| … each m bits summed and re-quantised to one | 16.6, 3.1 dB quiet | 9.4, 8.6 dB quiet |
| … transcoded on the card | **15.6** | **10.8** |
| DNVT to DNVT through two transcoding cards | 15.1 | 10.4 |

**Bit-domain conversion does not work.** Decimation keeps one bit of m where the
information is their sum: 69% of groups of four net to zero, and the kept bit
reports ±4 for all of them; silence, `1010`, decimates to all ones. Repetition
is exact for the integrator — the same current for the same time — but a 3-bit
window at 64 kbps fires on the DNVT's runs of two at 32 kbps and of one at 16,
so the step runs high. Re-quantising the sum holds only while the two laws
match, and delivers a level that depends on the rate.

**Two ways do work:**

1. **Transcode on the card**: decode, filter, re-encode at the DNVT's rate, as
   the FXS card does to analog. 0–1.1 dB against the DNVT alone; two DNVTs
   through two such cards, 0.4–1.6 dB. Neither end needs to know about the other.
2. **Repeat bits end to end**: a DNVT's line card puts each bit m times into the
   DS0 and takes any one of each m back — bit-exact at every phase. Between two
   DNVTs that is the DNVT's own quality with no codec on either card. Toward a
   voice card, that card's codec must be clocked at the DNVT's rate for the call
   and match the DNVT's ratio; the slews differ, which is only gain.

**A** is the E&M signalling bit: the M lead sensed through an opto-isolator to
the TX card, the E lead driven from the received A bit through the §13 RC.

### 12.2 Data card

Synchronous and bit-transparent: one data bit per frame on C, clocked by the
frame clock — the TX card's for transmit, the recovered frame clock for receive.
No elastic store and no slip. At a 64 kHz frame rate the pipe is **64 kbps**.

Unlike the frame it replaces, this pipe **is octet-aligned** (§6): the superframe
counter is the octet counter, so a data card can be a true DS0 and carry G.711
without the endpoints finding their own byte phase.

**A data card must not sit three slots from another data card** — not 1 and 4,
not 2 and 5, not 3 and 6 (§5). One in any seat is safe whatever it carries,
which was measured over every byte; adjacent data cards are safe; three fit as
1,2,3 or 4,5,6; ordinary random data is safe in all six seats. A data card need
not present any particular A bit.

### 12.3 Empty slot

An unfitted slot presents A = 0 and C = a `1010` toggle, fed through 4.7 kΩ so a
fitted card overrides it. The toggle matters for what the far end *hears* when a
slot is empty at one end only: a constant fill drives the far CVSD integrator
rail to rail, where `1010` is the codec's own idle pattern and decodes as silence.

---

## 13. Failure behaviour

| event | response |
|---|---|
| Not locked | **Mute all channel outputs**; force received A bits idle (74HC259 clear); data cards present RXD = 1 |
| Loss of signal, no transitions | **Squelch — required** |
| Slip | detected and corrected within 2.75 ms (§4.2) |
| Wrong superframe phase | cannot be held (§3.3) |
| Two data cards three slots apart | **forbidden** (§5) |
| A data card carrying the framing word three slots from a voice card | acquired by chance about once in 500 attempts at that skew; the guard counter releases it in milliseconds (§5) |
| Card type mismatch slot for slot | loud, locked, not squelched — label every slot |

**Squelch is mandatory, not optional.** §13 measured a CVSD card with
the framer bypassed on a dead pair with a little induced noise: **+24.1 dB rms,
+47.7 dB peak** relative to normal speech. Sparse transitions make the monostable
emit long runs of 1s and the syllabic compander reads it as a loud signal.
`mfspec.md` specified no squelch, no mute-on-unlock and no carrier-detect
timeout.

---

## 14. Signalling

One bit per channel per direction, sampled once per superframe at **8 kHz**.
A = 1 means active. E&M is a two-lead interface with one lead driven and one
sensed, so one bit each way carries seizure, answer, disconnect, dial pulses and
wink or delay start.

Received A bit → RC, τ = 2 ms → 74HC14 Schmitt: one resistor, one capacitor and
one gate per channel, serving as both error filter and debounce. §14
measured 0 spurious assertions to 6e−2 BER at a 32 kHz signalling rate; here the
rate is 8 kHz, so a burst of *k* bad samples lasts 125*k* µs instead of 31*k* µs.
The measured worst run was 4 samples, which is 0.5 ms against the ~1.7 ms needed
to assert — **still clear, with about 3.4× margin instead of 13×.** Analysis, not
re-measured.

---

## 15. What is and is not measured

**Measured here** (`mf8.py`): the F word choice; false locks over thirteen
payload classes at every skew, and exhaustively over all 64 hook states for the
nine that can hold an alignment open; the superframe-phase enumeration; the
guard position over four layouts, with each one's residual rate; the S position
and the slot rule over **every byte in every seat under every hook state**, for
both S positions; the guard counter's release time; acquisition time; loss of
frame to 3e−02 BER; slip recovery at every slip size. §3.5's two expansions were
measured the same way, at the frame layer only, from scratch scripts that are
not in the repository.

**Inherited from this document and not re-measured**: the whole physical layer — line
code, driver, transformer, filter, comparator, classifier tolerances, reach,
noise margin, squelch levels, signalling RC.

**Measured on the codec model** (`cvsd_law.py`, `tolerance.py`, §12.1): the law
against the standard's own decoder patterns and against the previous law; the
slew; whether the law is bit-rate specific, one parameter at a time at 16, 32
and 64 kbps; a DNVT on a 64 kbps channel, eight ways; component tolerances at
64 kbps, `I_min` alone included. All of it is `cvsd.py` — a model of the analog
engine, scored by segSNR on three talkers — not a circuit and not a listening
test.

**Measured over the line** (`mf8_line.py`, §7): six independent talkers through
the whole chain in both line codes, clean and under Gaussian noise, impulse noise
and attenuation; per-channel segSNR against a matched control; isolation against
a floor computed on the same window.

**Not measured at all:**

- **Mis-jumper between family members** (N = 2, 6, 14). A period-4 word defeats a
  ×2 mis-jumper by a divisibility argument; the equivalent argument for
  `11111110` has not been made or tested.
- **The other frame lengths.** Only N = 6 has an F word and guard positions.
- **The residual slot-rule risk beyond pairs.** Three data cards at seats
  1, 2, 3 is safe by the rule but was not enumerated as a triple. The every-byte
  sweep in §5 is over one data card's content with one other fixed; it is not
  over two arbitrary bytes at once.
- **The S move, over the line — re-run.** `mf8_line.py`, `impulse_sweep.py` and
  `mf8_render.py` have been re-run on this layout and their logs are from it.
  The clean-line and low-noise cells are unchanged to the last digit; the
  marginal cells moved as §7.2 describes, because moving S changes the line
  bits under the same seeded noise; the impulse thresholds moved within their
  spread, AMI's low-rate one the most (`line-codes.md` §4.5).
- **Squelch, mute timing and carrier detect.** §13 specifies them from
  the squelch measurement; none has been exercised on this frame. §7's "chopped" rows are
  exactly the condition a mute has to handle, and what a listener would hear
  through one has not been measured.
- **Long runs.** §7 is 1.0 s per cell, one seed. Enough to establish that the
  carrier is transparent and to place the failure modes; not enough for outage
  rates, and §7.2 shows a marginal cell flipping from 0 to 4 LOF between
  realizations. §4.2's 6.25 s BER runs are the longest anything here has run.
- **Repeatered spans.** Nothing here has been through more than one span.
- **A real DNVT.** Which of the standard's two readings a DNVT actually builds
  (§12.1) is a bench measurement: its decoder, the standard's two 16 kbps
  patterns, a meter at 800 Hz. So is whether its absolute step matches the
  slew here.
- **The law change, over the line — re-run.** `mf8.py`, `mf8_line.py`,
  `linecodes.py` and `mf8_render.py` have been re-run on §12.1's law and their
  logs are from it; `impulse_sweep.py` carries random payload and cannot see the
  codec. On the previous law `mf8_line.py` reproduces its old log to the last
  digit, so everything that moved in §7 moved with the law. `linecodes.log` had
  not been re-run since S moved; its structural tables moved with S, and only
  its per-rate audio table moved with the law.

**And the open question is not in this document.** `line-codes.md` §6 records it:
differential Manchester and AMI rank opposite ways under impulse noise, §7.2
reproduces that split on this frame, and which matters depends on the impulse
rate on the target loops — a plant measurement. The curve that converts it into
a break rate is measured (`line-codes.md` §4.5): 1 break/s at 1.3 impulses/s for
differential Manchester and about 8 for AMI, with AMI collapsing between 800 and 900.

---

## 16. Reproducing

```
python3 sim/mf8.py            frame layer, ~15 min          (mf8.log is the run)
python3 sim/mf8.py word       why 11111110 and not the alternatives
python3 sim/mf8.py locks      false locks, every payload class and hook state
python3 sim/mf8.py sfphase    superframe phase, exhaustive
python3 sim/mf8.py guard      why the guard is at 0 and 4: four layouts, and each one's residual
python3 sim/mf8.py sbit       why S sits half a frame from F: every byte, every seat, both layouts
python3 sim/mf8.py seats      the slot rule, every byte in every seat, and the guard counter's release
python3 sim/mf8.py errors     line errors, acquisition, slip recovery

python3 sim/mf8_line.py       over the line, ~20 min        (mf8_line.log is the run)
python3 sim/impulse_sweep.py  impulse falloff, ~22 min      (impulse_sweep.log, .csv)
python3 sim/mf8_line.py clean clean line, both codes, per channel, isolation
python3 sim/mf8_line.py noise Gaussian sweep
python3 sim/mf8_line.py plant impulse and attenuation

python3 sim/cvsd_law.py       the codec law, ~20 min        (cvsd_law.log is the run)
python3 sim/cvsd_law.py spec  the standard's patterns, and its two readings
python3 sim/cvsd_law.py laws  against the previous law; the slew
python3 sim/cvsd_law.py rates one parameter at a time at 16, 32 and 64 kbps
python3 sim/cvsd_law.py dnvt  a DNVT on a 64 kbps channel
python3 sim/tolerance.py      codec tolerances, ~20 min     (tolerance.log is the run)
```

Caveats that affect how the numbers should be read:

- `mf8.py` is bit level throughout: no waveform, no noise beyond injected BER.
  `mf8_line.py` is the waveform, and §7.3 is why it exists — two defects in §4
  were invisible until the chain ran end to end.
- The impulse model (`phy.plant_noise`) is a damped ringing sinusoid with a
  randomly signed amplitude, so each event swings **both polarities** many times
  — a 40 kHz ring against a 512 kbps line reverses every 6.4 bit periods.
  Measured over 0.5 s at 200 events/s: min −3.165, max +2.859, mean −1.3e−04,
  and the fraction of samples below −0.1 (0.0193) matches the fraction above
  +0.1 (0.0191).
- The exhaustive hook-state sweeps use 3000-frame clips, which is ample for a
  32-frame acquisition but short for rare events.
- Speech is one talker rolled per channel, as elsewhere in this repository.
- this document is the review this design came out of, and records what the
  original F word did and why each change here is here.
