retrac0/retelex/mf2/unit.md

# The MF2 unit — six boards, and the signals on each

An MF2 unit is two channel cards, a digital board, an analog board and the two
PSU boards, on the 100 × 100 mm spacer stack of `mf8-backplane.md` §8. Two units
back to back over two pairs are **two leased circuits** (`mf2/leased.md`). This
document defines every signal each board presents, and the three connectors they
meet on.

> **Status: proposed.** Nothing here has been on a bench and no board has been
> laid out. What is measured and cited: the framer and the slot rule on N = 2
> (`sim/mf2.log`), the section length and the code comparison on the buried pair
> (`sim/mf2_span.log`). What is carried unchanged from MF8 and was never measured
> there either: the whole physical layer (`mf8-spec.md` §15). Package counts are
> counts of an undrawn schematic.

Parent: [`spec.md`](spec.md). The line code is differential Manchester and the
PHY is `mf8-spec.md` §9 at the **Q3 rate plug** (§5.2).

> `mf2/repeater.md` and `mf2/leased.md` are referenced below and **are not
> written yet**; the repeater's measured span limits are in
> `sim/mf2_repeater.log` meanwhile.

---

## 1. The six boards

```
  CH1 ══ C ══ CH2 ══ C ══ MF2-D ══ P ══ MF2-A ══ Quiet PSU ══ pass ══ Noisy PSU ── 15–18 V in
                             │              │         │                   │
                      crystal, framer,   encoder,  +5, ±12,            intake,
                      muxes, counters,   75176,    −48 out             −48 stage,
                      C and the panel    classifier,                   RING inverter
                                         magnetics
```

| board | what it is | ≈ packages |
|---|---|---|
| **channel card** ×2 | the common card set, unchanged (`common-cards.md`) | 4–11 each |
| **MF2-D** | clocks, frame and superframe counters, muxes, framer, stack header **C** | **≈ 12–15** |
| **MF2-A** | biphase encoder, 75176, magnetics, protection, comparator, Q3 classifier | **≈ 6–8** + 2 transformers |
| **Quiet PSU** | `+5 V`, `±12 V`, the `−48 V` finish, the star point | `mf8-psu.md` §4.2 |
| **Noisy PSU** | 15–18 V intake, the `−48 V` stage, the ring inverter | `mf8-psu.md` §4.1 |

Ten boards on an MF8 shelf, six here. The split point is `mf8-trunk.md`'s and is
not reopened: plant energy and interval timing on A, every stack driver and the
framer on D.

**Three connectors**, and no others carry signal:

| | | |
|---|---|---|
| **stack header C** | channel cards ⇄ MF2-D | the channel socket of `common-cards.md` §1.1, two appearances (§2) |
| **pass header P** | MF2-D ⇄ MF2-A | 2 × 7, keyed (§4) |
| **rear connector** | MF2-A ⇄ the line | four conductors, a pair each way (§5.4) |

The PSU pass is `mf8-psu.md` §4.3 and carries no channel signal.

---

## 2. The channel socket — unchanged, and that is the point

**A channel card cannot tell an MF2 unit from an MF8 shelf.** The socket is
`common-cards.md` §1.1 pin for pin, and every clock on it is the same rate and
the same phase, because MF2 keeps the 64 kHz frame rate and the 8-frame
superframe that MF8 has. Only the *line* differs, and no channel card sees the
line.

| pin | signal | dir | in an MF2 unit | same as MF8? |
|---|---|---|---|---|
| a1 | `TX_CLK` | in | 64 kHz, `/FB[1]` from MF2-D | **yes** |
| a2 | `LOOP_HB` | in | 128 kHz, `/FB[0]` from MF2-D (§3.2) | **yes** |
| a3 | `TX_OCT` | in | 8 kHz, superframe state 7 | **yes** |
| a4 | `FILL` | in | 32 kHz, `/SFC[0]` | **yes** |
| a5 | `C_TX[n]` | **out** | → MF2-D's frame mux, input 1 or 3 | yes; the mux is 4:1, not 8:1 |
| a6 | `A_TX[n]` | **out** | → MF2-D's signalling mux, input 1 or 5 | **yes** |
| a7 | `RX_CLK` | in | recovered 64 kHz | **yes** — recovered, as in a shelf |
| a8 | `RX_OCT` | in | recovered state 7 | **yes** |
| a9 | `C_RX[n]` | in | ← the receive demux | **yes** |
| a10 | `A_RX[n]` | in | ← the receive `'259`, raw; the RC and Schmitt are on the card | **yes** |
| a11 | `MUTE` | in | asserted when the framer is not locked | **yes** |
| a12 | card word | out, o.d. | **pulled to `+5 V` through 680 Ω** and brought to a test header | MF8 leaves it open (§2.1) |
| a13 | `/ANS` | out, o.d. | the same | the same |
| a14 | `RAI` — spare | out, o.d. | the same | the same |
| a15 | key | | | yes |
| a16 | `GND` | | | yes |
| c1–c16 | rails | | `mf8-backplane.md` §8's row *c*, unchanged | **yes** |

### 2.1 The one deliberate difference

An MF8 shelf leaves a12–a14 **unconnected**, so a card that shifts a word drives
into an open circuit and a card that ties a pin low pulls a floating net. An MF2
unit pulls all three to `+5 V` through **680 Ω** — the port pull-up value of
`common-cards.md` §1.2 — and brings them to a three-pin test header on MF2-D.

Nothing about a card changes: it still only ever pulls low or leaves open
(`common-cards.md` §1.2). What changes is that the levels are defined, so a
card's word can be read on a scope at a unit without an exchange behind it. That
is a bring-up convenience, not a contract change, and `common-cards.md` §1.1's
MF8-shelf column stands.

### 2.2 Two appearances, on a ribbon

The card side of an MF2 unit is a **star**, as a block's is: six per-slot signals
a card (`C_TX`, `A_TX`, `C_RX`, `A_RX`, card word, `/ANS`), the clocks and rails
common, nothing addressed and nothing contending. Stack header **C** collects
that star on MF2-D.

**mk1 breaks it out as a two-slot ribbon**, in the idiom of the exchange's
port-card-to-subscriber-card ribbon (`block-stack.md` §5), rather than solving
the stack-native geometry that `mf8-backplane.md` §8 and `mf8-trunk.md` §5 both
defer for six layers. MF2 has two layers and no need to settle a six-layer
mechanical standard on its own.

**Seat keying is not cosmetic.** `spec.md` §5 forbids two data cards, and
`sim/mf2.log` measures why: two data cards hold a wrong alignment in **520**
(byte, hook-state) combinations, and the framer false-locks 4 of 16 start-ups on
the adversarial pair with none of them releasing. Key the two seats so that two
data cards cannot both be fitted, and **do not reuse MF8's "seats 1–3" wording** —
the rule is carrier-specific (`spec.md` §5).

---

## 3. MF2-D — the digital board
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
