retrac0/retelex/newimpl/flood-study/work/load/timing/an_wave2x4fix.txt

LOG work/load/timing/run_wave2x4fix.log
KNOBS idg_ms=300 idg_jit_ms=0 idg0_ms=256 idg0_jit_ms=16 dest_mode=4 pairs=A20Z21,B20Z21,G20Z21 burst_ms=5000 pair_gap_ms=0 bad_e=4 bad_b=3 pnet=500 idle_ms=300000 dur_ms=5000 seed=7 scale=1
sim end t=3345.2 ms
CALLS 3 {'NOGO': 1, 'SILENT': 2}
  by kind {('BAD', 'NOGO'): 1, ('BAD', 'SILENT'): 2}
  why {'N_GUARD': 1, '-': 2}
COUNTS {'floods': 3, 'transit delay cause fwait': 2, 'cell digits': 14, 'transit delay cause clsq': 1, 'transit delay cause none': 13, 're-seized (2+ HOLDs)': 1, 'unhold on a live flood': 1, 'e brk inside the T_ARM hold watch': 1, 'guard_abandon': 1}
OTHER {}
MARGIN arm->first brk at port (all)          n=21   mean=  82.28 p50=  86.01 p90= 118.99 p99= 121.99 max= 121.99 min=   7.00
MARGIN arm->first brk at port, hop 1         n=5    mean= 118.19 p50= 118.99 p90= 121.99 p99= 121.99 max= 121.99 min= 114.00
MARGIN arm->first brk at port, hop 2         n=3    mean= 100.67 p50= 100.99 p90= 108.21 p99= 109.83 max= 110.01 min=  91.01
MARGIN arm->first brk at port, hop 3         n=3    mean=  88.00 p50=  88.01 p90=  95.99 p99=  97.79 max=  97.99 min=  77.99
MARGIN arm->first brk at port, hop 4         n=3    mean=  75.34 p50=  74.99 p90=  83.80 p99=  85.79 max=  86.01 min=  65.01
MARGIN arm->first brk at port, hop 5         n=3    mean=  62.66 p50=  62.01 p90=  71.60 p99=  73.75 max=  73.99 min=  52.00
MARGIN arm->first brk at port, hop 6         n=3    mean=  50.00 p50=  48.99 p90=  59.40 p99=  61.74 max=  62.00 min=  39.00
MARGIN arm->first brk at port, hop 7         n=1    mean=   7.00 p50=   7.00 p90=   7.00 p99=   7.00 max=   7.00 min=   7.00
MARGIN hold->first brk at port (all)         n=21   mean=  83.17 p50=  86.89 p90= 119.87 p99= 122.87 max= 122.87 min=   7.88
MARGIN hold->first brk at port, hop 1        n=5    mean= 119.08 p50= 119.87 p90= 122.87 p99= 122.87 max= 122.87 min= 114.88
MARGIN hold->first brk at port, hop 2        n=3    mean= 101.55 p50= 101.87 p90= 109.09 p99= 110.71 max= 110.89 min=  91.89
MARGIN hold->first brk at port, hop 3        n=3    mean=  88.88 p50=  88.89 p90=  96.88 p99=  98.67 max=  98.87 min=  78.87
MARGIN hold->first brk at port, hop 4        n=3    mean=  76.22 p50=  75.87 p90=  84.69 p99=  86.67 max=  86.89 min=  65.89
MARGIN hold->first brk at port, hop 5        n=3    mean=  63.55 p50=  62.89 p90=  72.48 p99=  74.63 max=  74.87 min=  52.88
MARGIN hold->first brk at port, hop 6        n=3    mean=  50.88 p50=  49.88 p90=  60.28 p99=  62.62 max=  62.88 min=  39.89
MARGIN hold->first brk at port, hop 7        n=1    mean=   7.88 p50=   7.88 p90=   7.88 p99=   7.88 max=   7.88 min=   7.88
age at arrival, hop 1                        n=5    mean=   1.81 p50=   2.05 p90=   2.18 p99=   2.22 max=   2.23 min=   1.29
age at arrival, hop 2                        n=3    mean=  17.61 p50=  16.14 p90=  21.79 p99=  23.06 max=  23.20 min=  13.50
age at arrival, hop 3                        n=3    mean=  34.24 p50=  29.23 p90=  43.53 p99=  46.75 max=  47.11 min=  26.40
age at arrival, hop 4                        n=3    mean=  47.28 p50=  43.14 p90=  56.79 p99=  59.86 max=  60.20 min=  38.50
age at arrival, hop 5                        n=3    mean=  60.58 p50=  56.23 p90=  70.53 p99=  73.75 max=  74.11 min=  51.39
age at arrival, hop 6                        n=3    mean=  73.84 p50=  70.13 p90=  83.79 p99=  86.86 max=  87.21 min=  64.18
age at arrival, hop 7                        n=1    mean= 108.12 p50= 108.12 p90= 108.12 p99= 108.12 max= 108.12 min= 108.12
arrival->first brk at port, hop 1            n=5    mean= 120.79 p50= 123.99 p90= 123.99 p99= 123.99 max= 123.99 min= 116.00
arrival->first brk at port, hop 2            n=3    mean= 106.00 p50= 103.01 p90= 110.21 p99= 111.83 max= 112.01 min= 102.99
arrival->first brk at port, hop 3            n=3    mean=  90.00 p50=  90.01 p90=  97.99 p99=  99.79 max=  99.99 min=  79.99
arrival->first brk at port, hop 4            n=3    mean=  77.34 p50=  76.99 p90=  85.80 p99=  87.79 max=  88.01 min=  67.01
arrival->first brk at port, hop 5            n=3    mean=  64.66 p50=  64.01 p90=  73.60 p99=  75.75 max=  75.99 min=  54.00
arrival->first brk at port, hop 6            n=3    mean=  52.00 p50=  50.99 p90=  61.40 p99=  63.74 max=  64.00 min=  41.00
arrival->first brk at port, hop 7            n=1    mean=  21.00 p50=  21.00 p90=  21.00 p99=  21.00 max=  21.00 min=  21.00
fsweep->fwd (sweep+confirm+write)            n=16   mean=  10.53 p50=  10.72 p90=  10.74 p99=  10.74 max=  10.74 min=  10.00
hold->fsweep                                 n=21   mean=   0.78 p50=   0.00 p90=   0.00 p99=   8.54 max=   8.74 min=   0.00
hop 1->2 (rise to rise)                      n=3    mean=  15.71 p50=  13.91 p90=  19.66 p99=  20.96 max=  21.10 min=  12.10
hop 2->3 (rise to rise)                      n=3    mean=  16.63 p50=  13.09 p90=  21.75 p99=  23.69 max=  23.91 min=  12.89
hop 3->4 (rise to rise)                      n=3    mean=  13.04 p50=  13.09 p90=  13.74 p99=  13.89 max=  13.91 min=  12.11
hop 4->5 (rise to rise)                      n=3    mean=  13.30 p50=  13.10 p90=  13.74 p99=  13.89 max=  13.90 min=  12.89
hop 5->6 (rise to rise)                      n=3    mean=  13.26 p50=  13.10 p90=  13.74 p99=  13.89 max=  13.90 min=  12.79
hop 6->7 (rise to rise)                      n=1    mean=  20.91 p50=  20.91 p90=  20.91 p99=  20.91 max=  20.91 min=  20.91
key->osweep                                  n=3    mean=   0.00 p50=   0.00 p90=   0.00 p99=   0.00 max=   0.00 min=   0.00
key->seize                                   n=3    mean=  11.00 p50=  11.00 p90=  11.80 p99=  11.98 max=  12.00 min=  10.00
origin seize->hop1 rise                      n=5    mean=   1.81 p50=   2.05 p90=   2.18 p99=   2.22 max=   2.23 min=   1.29
relayed break - origin break, hop 1          n=30   mean=  -0.01 p50=  -0.01 p90=  -0.01 p99=  -0.01 max=  -0.00 min=  -0.01
relayed break - origin break, hop 2          n=20   mean=   0.00 p50=   0.00 p90=   0.01 p99=   0.01 max=   0.01 min=  -0.00
relayed break - origin break, hop 3          n=20   mean=  -0.01 p50=  -0.01 p90=  -0.01 p99=  -0.01 max=  -0.01 min=  -0.01
relayed break - origin break, hop 4          n=20   mean=   0.00 p50=   0.00 p90=   0.01 p99=   0.01 max=   0.01 min=  -0.00
relayed break - origin break, hop 5          n=20   mean=  -0.01 p50=  -0.01 p90=  -0.01 p99=  -0.01 max=  -0.01 min=  -0.01
relayed break - origin break, hop 6          n=20   mean=  -0.00 p50=  -0.00 p90=   0.01 p99=   0.01 max=   0.01 min=  -0.01
relayed break - origin break, hop 7          n=10   mean=  -0.01 p50=  -0.01 p90=  -0.01 p99=  -0.01 max=  -0.01 min=  -0.01
relayed break length (all hops)              n=140  mean=  60.00 p50=  59.99 p90=  60.01 p99=  60.01 max=  60.01 min=  59.99
rise->arm                                    n=21   mean=   3.19 p50=   2.00 p90=   5.00 p99=  13.60 max=  14.00 min=   2.00
rise->cread                                  n=21   mean=   1.20 p50=   0.00 p90=   3.00 p99=  11.60 max=  12.00 min=   0.00
rise->fwd legs written                       n=16   mean=  13.31 p50=  11.85 p90=  19.35 p99=  21.55 max=  21.85 min=  11.50
rise->hold                                   n=21   mean=   2.31 p50=   1.12 p90=   4.12 p99=  12.72 max=  13.12 min=   1.12
seize->arm, hop 1                            n=5    mean=   4.41 p50=   4.10 p90=   5.92 p99=   6.94 max=   7.05 min=   3.29
seize->arm, hop 2                            n=3    mean=  22.95 p50=  18.14 p90=  31.79 p99=  34.86 max=  35.20 min=  15.50
seize->arm, hop 3                            n=3    mean=  36.25 p50=  31.23 p90=  45.53 p99=  48.75 max=  49.11 min=  28.40
seize->arm, hop 4                            n=3    mean=  49.28 p50=  45.14 p90=  58.79 p99=  61.86 max=  62.20 min=  40.50
seize->arm, hop 5                            n=3    mean=  62.58 p50=  58.23 p90=  72.53 p99=  75.75 max=  76.11 min=  53.39
seize->arm, hop 6                            n=3    mean=  75.84 p50=  72.13 p90=  85.79 p99=  88.87 max=  89.21 min=  66.18
seize->arm, hop 7                            n=1    mean= 122.12 p50= 122.12 p90= 122.12 p99= 122.12 max= 122.12 min= 122.12
seize->caller e brk (origin probe)           n=3    mean= 122.60 p50= 125.26 p90= 125.28 p99= 125.28 max= 125.28 min= 117.25
transit hop (rise to next rise), all         n=16   mean=  14.79 p50=  13.10 p90=  21.01 p99=  23.49 max=  23.91 min=  12.10
ANOM (2, first 30)
ANOM RESEIZE call 1 dial 14321 at H port 12: 2 holds, unhold=554.121
ANOM INWATCH call 1 dial 14321 at H(hop 7) port 12: hold 546.240, e brk arrived 554.121 (7.9 ms after the hold)
INVARIANT TOTAL pass=98 fail=0
SUMMARY outcome total=3 OK=0 BUSY=0 NOGO=1 NODT=0 ABANDON=0 NOANS=0 WRONG=0 JOINED=0 DTAGAIN=0 SILENT=2 XTALK=0 NOSPEECH=0 COLLIDE=0 CUT=0
SUMMARY outcome kind=L total=0
SUMMARY outcome kind=N total=0
SUMMARY outcome kind=BAD total=3 NOGO=1 SILENT=2
SUMMARY safety wrong=0 joined=0 xtalk=0 nospeech=0 dtagain=0 silent=2 phantom=0 wrongring=0 idlehear=0 ring_anon=0 drainring=0 alert_nobell=0 stuck=0
END t=8021
ONELINE run_wave2x4fix.log | sim_end=3345ms calls=3 {'NOGO': 1, 'SILENT': 2} | floods=3 guard_ab=1 no_seize=0 | miscount=0/14 falseclaim=0 regmis=0 latearm=0 reseize=1 C06=0 unwatched=0 nofwd=0 inwatch=1 | seize->arm h1:4.4/6.9/7.1(n5) h2:22.9/34.9/35.2(n3) h3:36.2/48.8/49.1(n3) h4:49.3/61.9/62.2(n3) h5:62.6/75.7/76.1(n3) h6:75.8/88.9/89.2(n3) h7:122.1/122.1/122.1(n1) | margin(all) 82.3/122.0/122.0(n21) | WRONG=0
