retrac0/retelex/(list of files, drawings)

Other design files:
pcb/portcard_RevC/freerouting.dsn
pcb/portcard_RevC/portcard_RevC.dsn
pcb/portcard_RevC/temp-freerouting.dsn
