retrac0/retelex/pcb/portcard_RevC/portcard_RevC.kicad_pcb

## KiCad design pcb/portcard_RevC/portcard_RevC.kicad_pcb (2026-09-27)

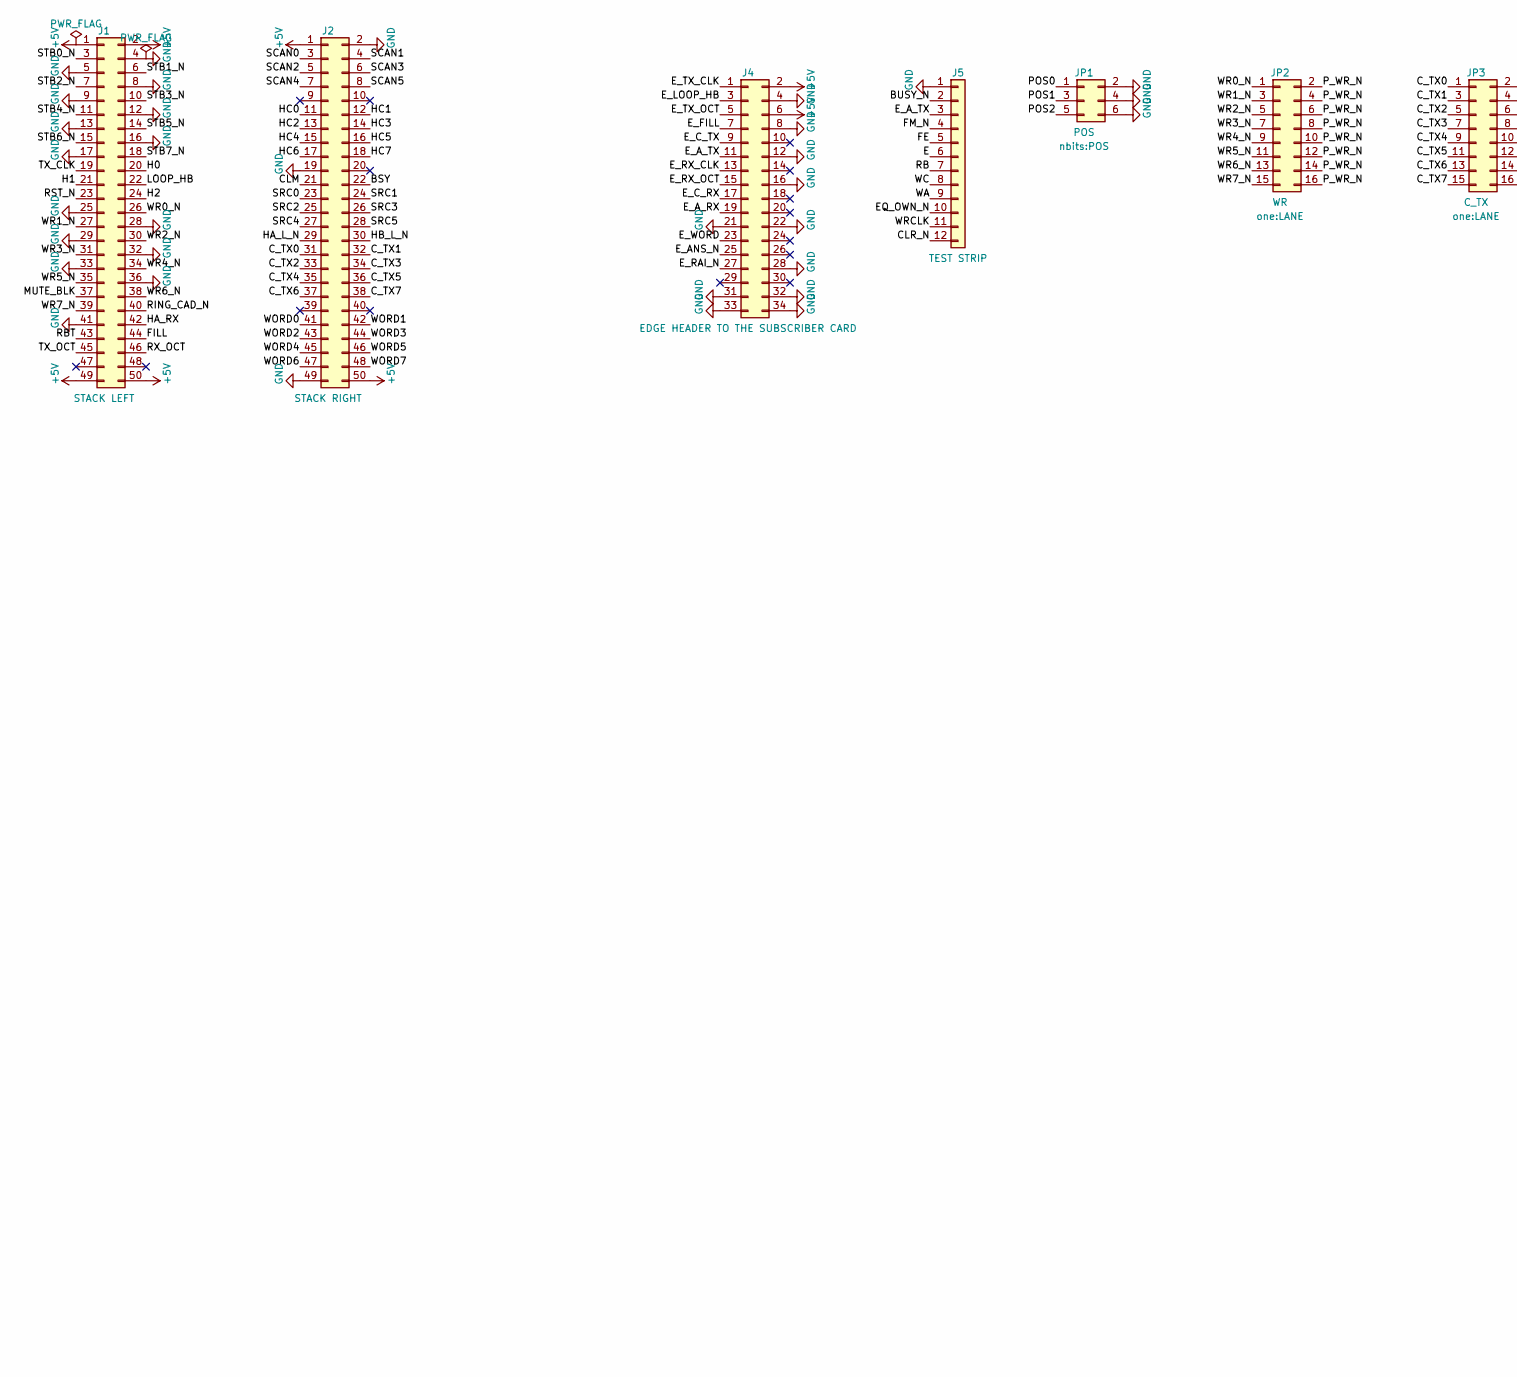
[picture p1: schematic portcard_RevC.kicad_sch, Port card -- one port circuit, eight to a block stack, part in row 1, column 1]

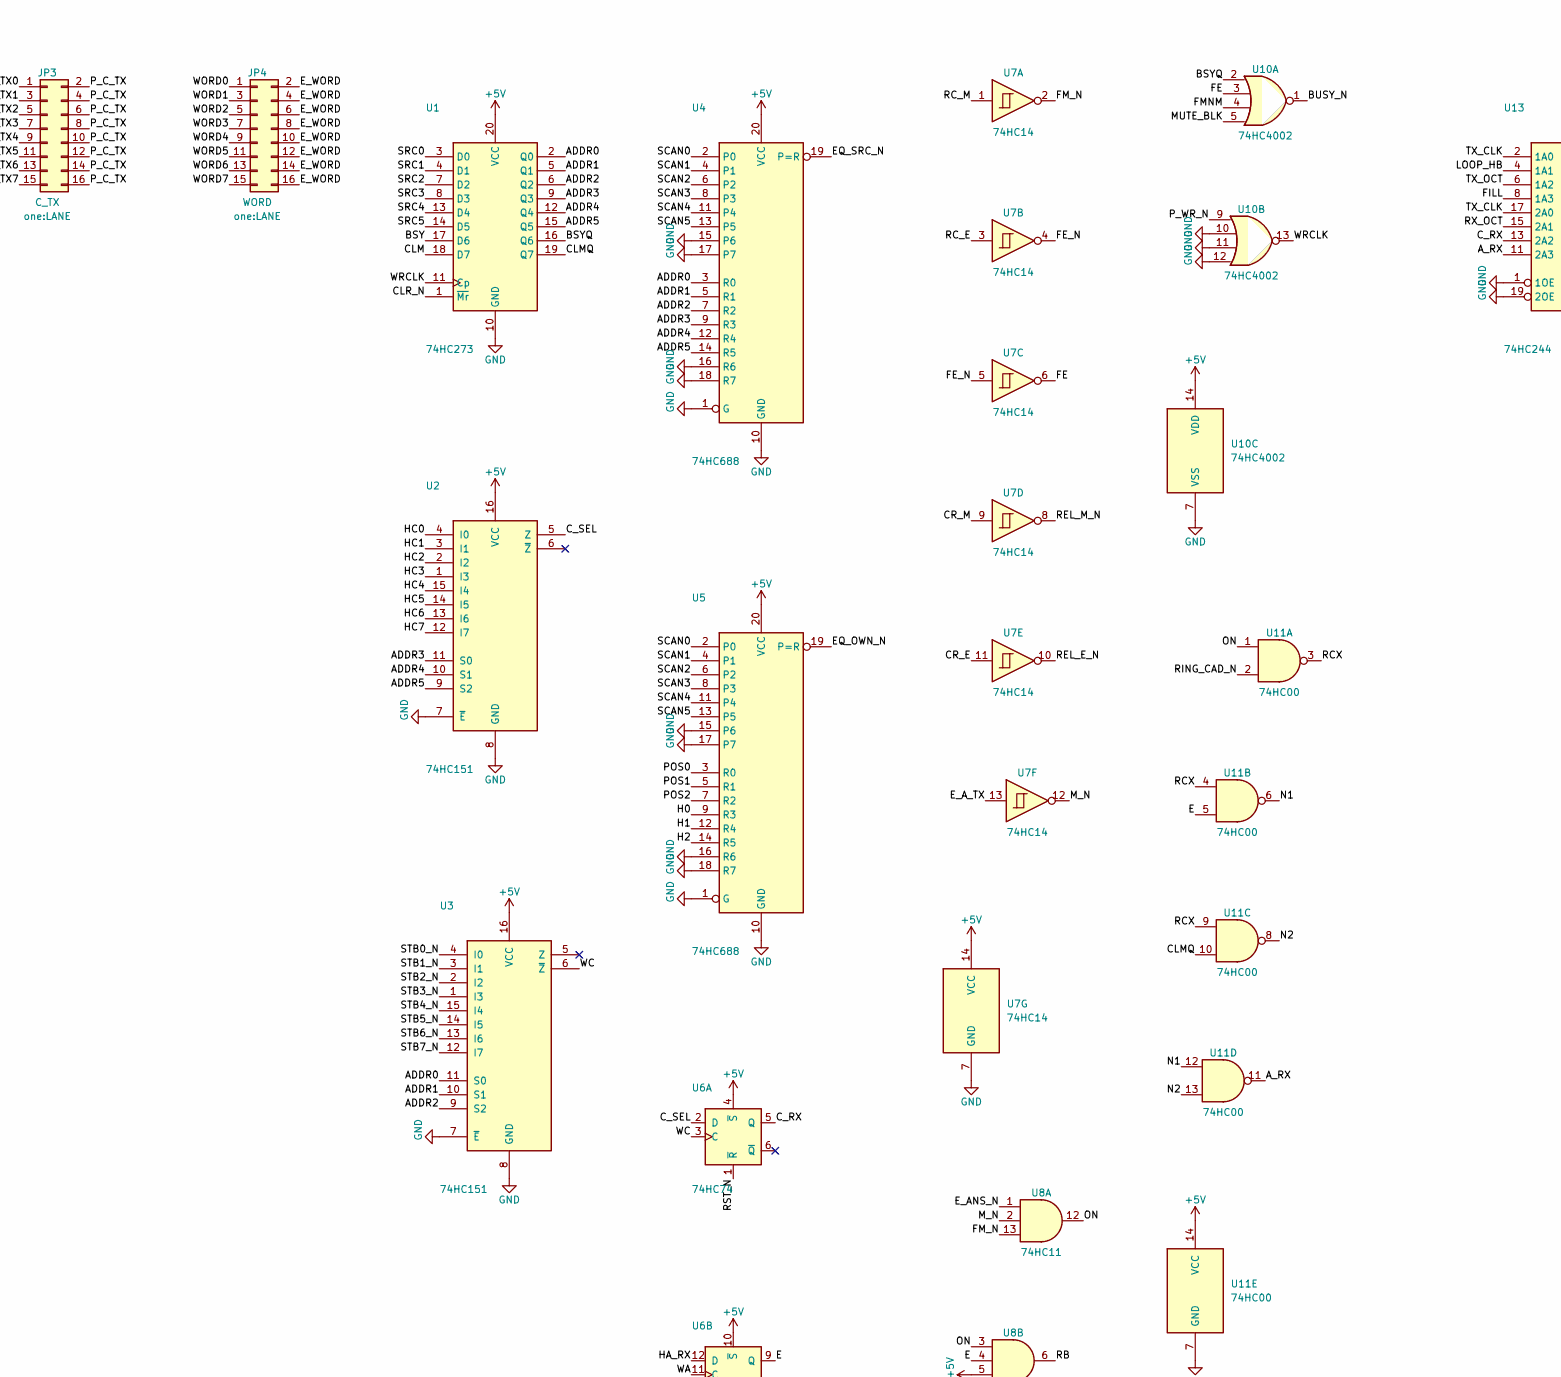
[picture p2: schematic portcard_RevC.kicad_sch, Port card -- one port circuit, eight to a block stack, part in row 1, column 2]

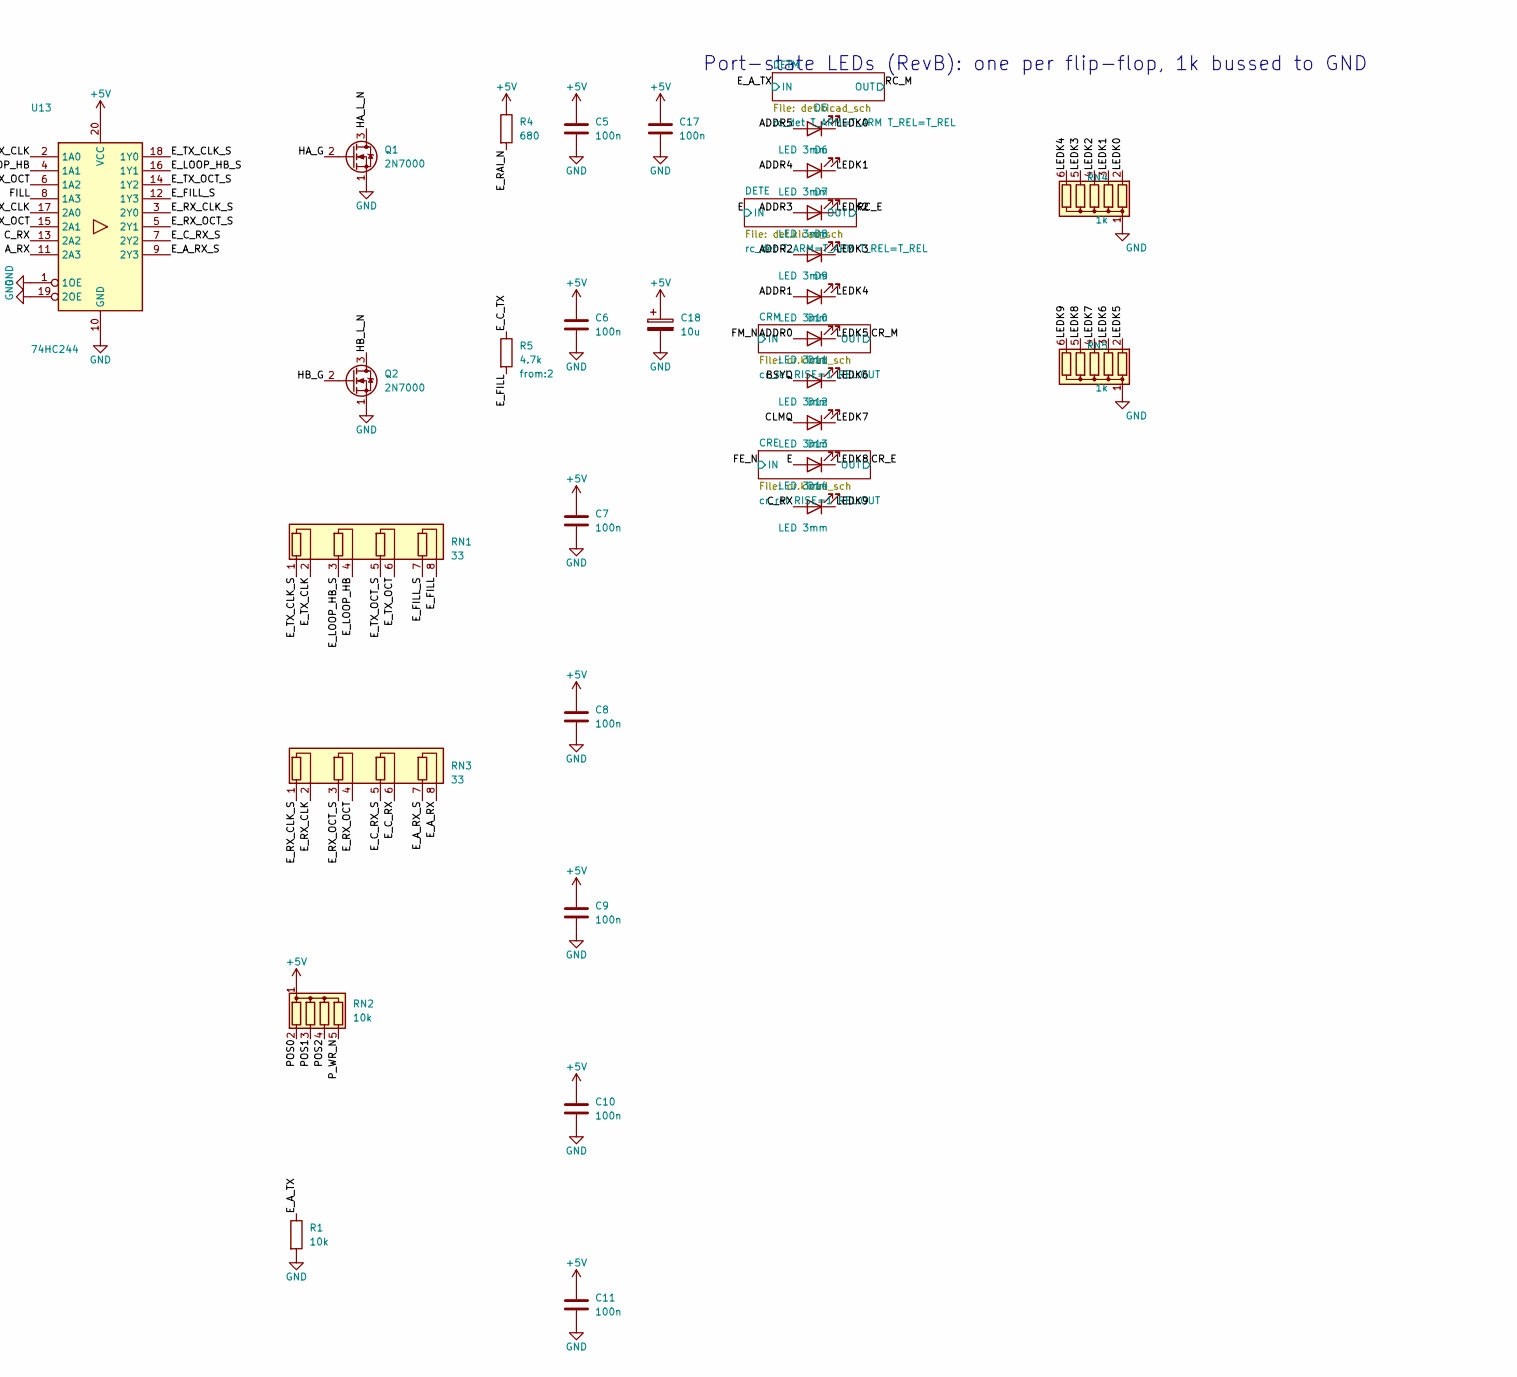
[picture p3: schematic portcard_RevC.kicad_sch, Port card -- one port circuit, eight to a block stack, part in row 1, column 3]

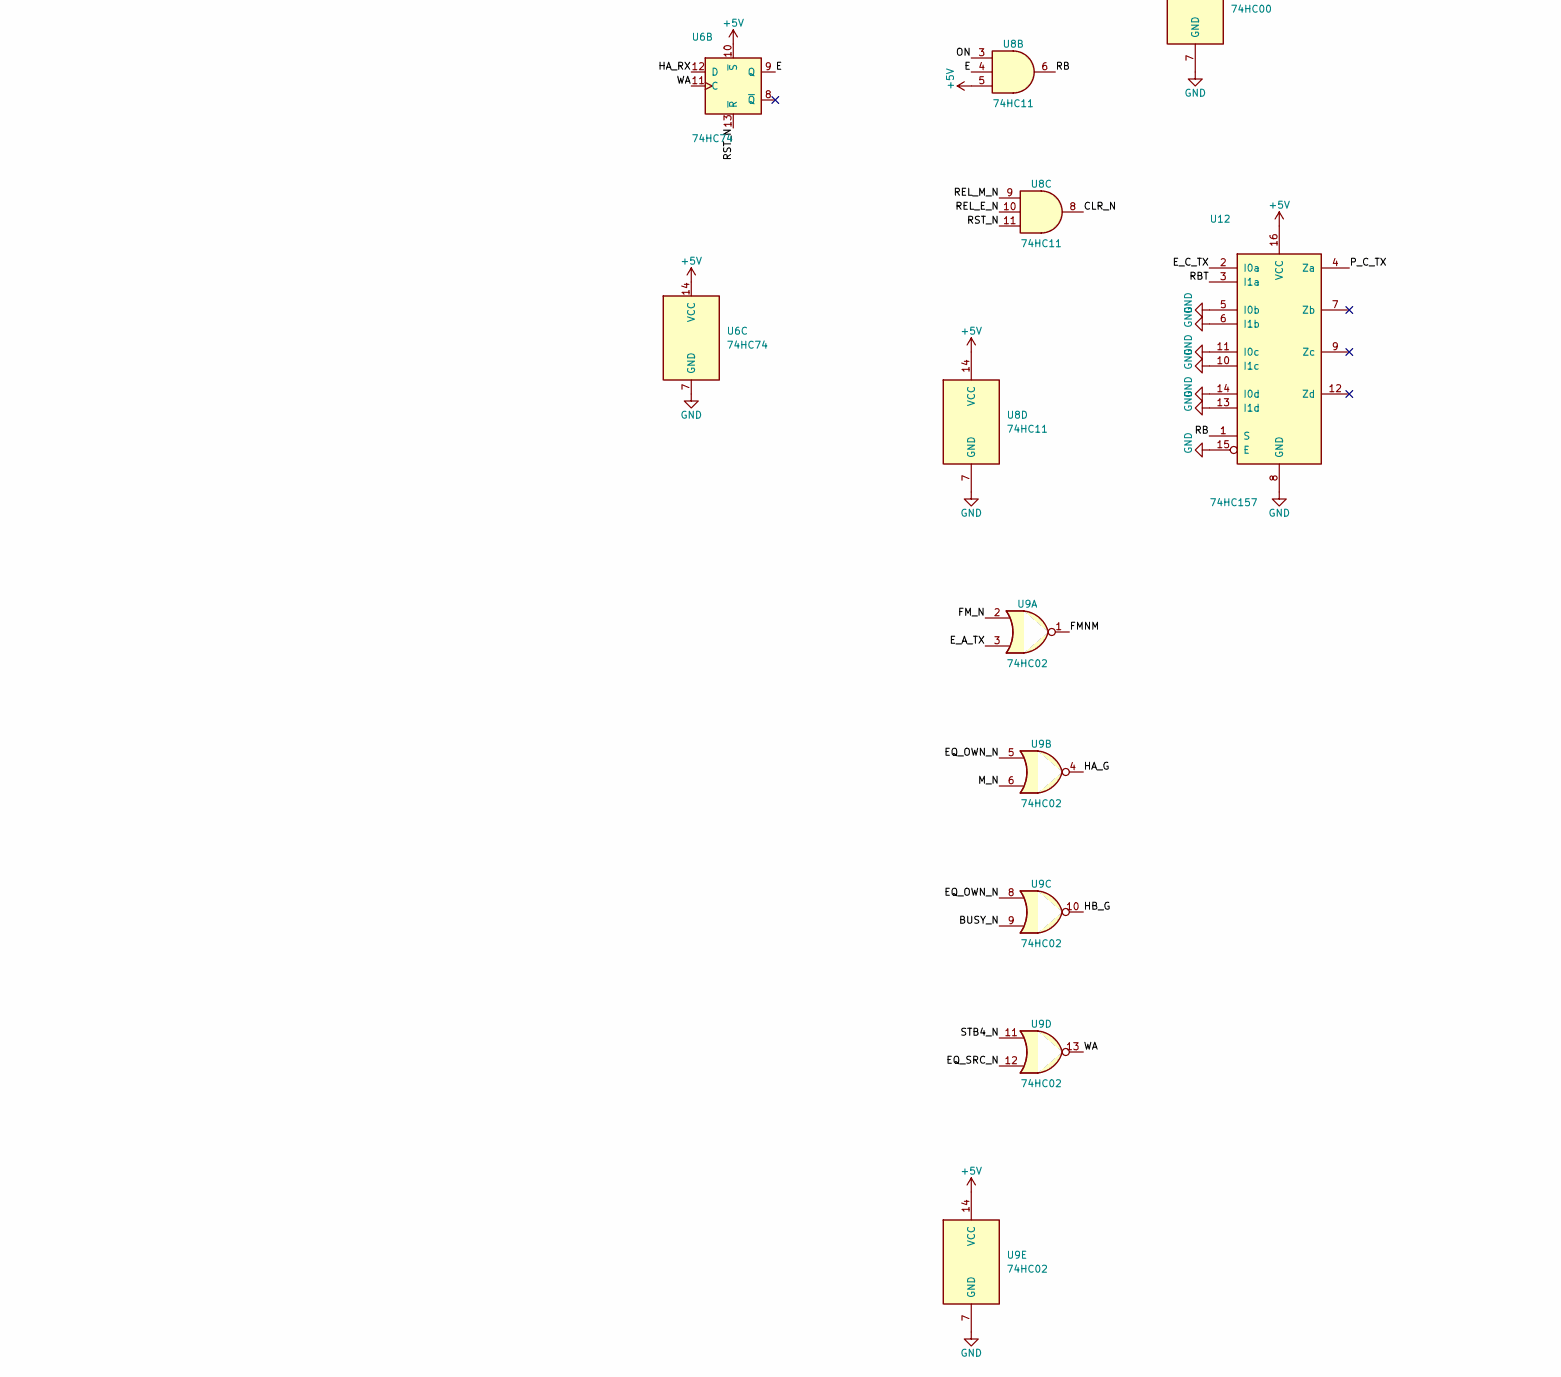
[picture p4: schematic portcard_RevC.kicad_sch, Port card -- one port circuit, eight to a block stack, part in row 2, column 2]

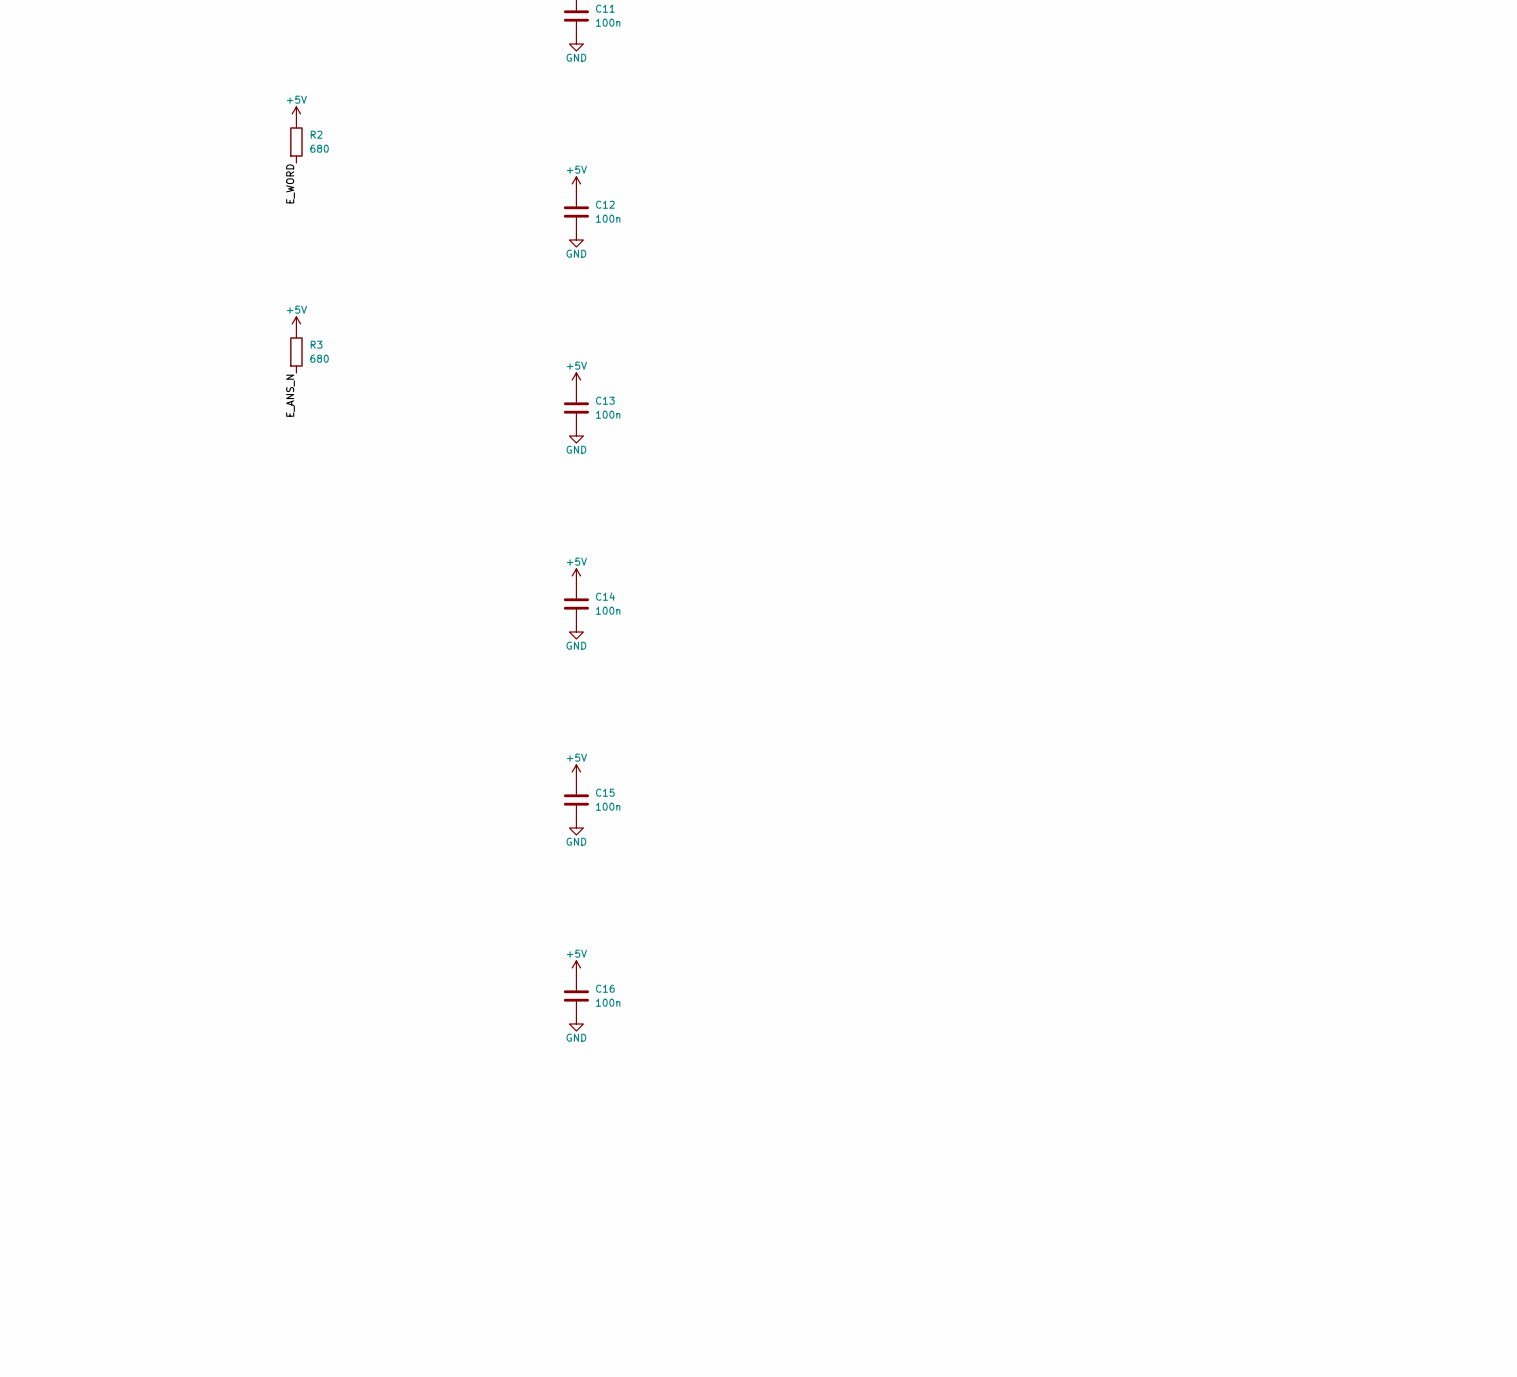
[picture p5: schematic portcard_RevC.kicad_sch, Port card -- one port circuit, eight to a block stack, part in row 2, column 3]

Parts:
C5, C6, C7, C8, C9, C10, C11, C12, C13, C14, C15, C16, C17: 100n; C_Disc_D3.0mm_W1.6mm_P2.50mm
C18: 10u; CP_Radial_D4.0mm_P1.50mm
D5, D6, D7, D8, D9, D10, D11, D12, D13, D14: LED 3mm; LED_D3.0mm_Row
J1: STACK LEFT; Stack_2x25_P2.54mm_LongTail
J2: STACK RIGHT; Stack_2x25_P2.54mm_LongTail
J4: EDGE HEADER TO THE SUBSCRIBER CARD; IDC-Header_2x17_P2.54mm_Horizontal
J5: TEST STRIP; PinHeader_1x12_P2.54mm_Horizontal
JP1: POS; PinHeader_2x03_P2.54mm_Vertical
JP2: WR; PinHeader_2x08_P2.54mm_Vertical
JP3: C_TX; PinHeader_2x08_P2.54mm_Vertical
JP4: WORD; PinHeader_2x08_P2.54mm_Vertical
Q1, Q2: 2N7000; TO-92_Inline
R1: 10k; R_Axial_DIN0207_L6.3mm_D2.5mm_P2.54mm_Vertical
R2, R3, R4: 680; R_Axial_DIN0207_L6.3mm_D2.5mm_P2.54mm_Vertical
R5: 4.7k; R_Axial_DIN0207_L6.3mm_D2.5mm_P2.54mm_Vertical
RN1, RN3: 33; R_Array_SIP8
RN2: 10k; R_Array_SIP5
RN4, RN5: 1k; R_Array_SIP6
U1: 74HC273; DIP-20_W7.62mm
U2, U3: 74HC151; DIP-16_W7.62mm
U4, U5: 74HC688; DIP-20_W7.62mm
U6: 74HC74; DIP-14_W7.62mm
U7: 74HC14; DIP-14_W7.62mm
U8: 74HC11; DIP-14_W7.62mm
U9: 74HC02; DIP-14_W7.62mm
U10: 74HC4002; DIP-14_W7.62mm
U11: 74HC00; DIP-14_W7.62mm
U12: 74HC157; DIP-16_W7.62mm
U13: 74HC244; DIP-20_W7.62mm

Connections:
+5V: C5.1, C6.1, C7.1, C8.1, C9.1, C10.1, C11.1, C12.1, C13.1, C14.1, C15.1, C16.1, C17.1, C18.1, J1.1, J1.2, J1.49, J1.50, J2.1, J2.50, J4.2, J4.6, R2.1, R3.1, R4.1, RN2.1 (common), U1.20 (VCC), U2.16 (VCC), U3.16 (VCC), U4.20 (VCC), U5.20 (VCC), U6.4 (~S), U6.10 (~S), U6.14 (VCC), U7.14 (VCC), U8.5, U8.14 (VCC), U9.14 (VCC), U10.14 (VDD), U11.14 (VCC), U12.16 (VCC), U13.20 (VCC)
/ADDR0: D10.2 (A), U1.2 (Q0), U3.11 (S0), U4.3 (R0)
/ADDR1: D9.2 (A), U1.5 (Q1), U3.10 (S1), U4.5 (R1)
/ADDR2: D8.2 (A), U1.6 (Q2), U3.9 (S2), U4.7 (R2)
/ADDR3: D7.2 (A), U1.9 (Q3), U2.11 (S0), U4.9 (R3)
/ADDR4: D6.2 (A), U1.12 (Q4), U2.10 (S1), U4.12 (R4)
/ADDR5: D5.2 (A), U1.15 (Q5), U2.9 (S2), U4.14 (R5)
/A_RX: U11.11, U13.11 (2A3)
/BSY: J2.22, U1.17 (D6)
/BSYQ: D11.2 (A), U1.16 (Q6), U10.2
/BUSY_N: J5.2, U9.9, U10.1
/CLM: J2.21, U1.18 (D7)
/CLMQ: D12.2 (A), U1.19 (Q7), U11.10
/CLR_N: J5.12, U1.1 (~Mr), U8.8
/CR_E: U7.11; also elsewhere on the board
/CR_M: U7.9; also elsewhere on the board
/C_RX: D14.2 (A), U6.5 (Q), U13.13 (2A2)
/C_SEL: U2.5 (Z), U6.2 (D)
/C_TX0: J2.31, JP3.1
/C_TX1: J2.32, JP3.3
/C_TX2: J2.33, JP3.5
/C_TX3: J2.34, JP3.7
/C_TX4: J2.35, JP3.9
/C_TX5: J2.36, JP3.11
/C_TX6: J2.37, JP3.13
/C_TX7: J2.38, JP3.15
/E: D13.2 (A), J5.6, U6.9 (Q), U8.4, U11.5; also elsewhere on the board
/EQ_OWN_N: J5.10, U5.19 (P=R), U9.5, U9.8
/EQ_SRC_N: U4.19 (P=R), U9.12
/E_ANS_N: J4.25, R3.2, U8.1
/E_A_RX: J4.19, RN3.8 (R4.2)
/E_A_RX_S: RN3.7 (R4.1), U13.9 (2Y3)
/E_A_TX: J4.11, J5.3, R1.1, U7.13, U9.3; also elsewhere on the board
/E_C_RX: J4.17, RN3.6 (R3.2)
/E_C_RX_S: RN3.5 (R3.1), U13.7 (2Y2)
/E_C_TX: J4.9, R5.1, U12.2 (I0a)
/E_FILL: J4.7, R5.2, RN1.8 (R4.2)
/E_FILL_S: RN1.7 (R4.1), U13.12 (1Y3)
/E_LOOP_HB: J4.3, RN1.4 (R2.2)
/E_LOOP_HB_S: RN1.3 (R2.1), U13.16 (1Y1)
/E_RAI_N: J4.27, R4.2
/E_RX_CLK: J4.13, RN3.2 (R1.2)
/E_RX_CLK_S: RN3.1 (R1.1), U13.3 (2Y0)
/E_RX_OCT: J4.15, RN3.4 (R2.2)
/E_RX_OCT_S: RN3.3 (R2.1), U13.5 (2Y1)
/E_TX_CLK: J4.1, RN1.2 (R1.2)
/E_TX_CLK_S: RN1.1 (R1.1), U13.18 (1Y0)
/E_TX_OCT: J4.5, RN1.6 (R3.2)
/E_TX_OCT_S: RN1.5 (R3.1), U13.14 (1Y2)
/E_WORD: J4.23, JP4.2, JP4.4, JP4.6, JP4.8, JP4.10, JP4.12, JP4.14, JP4.16, R2.2
/FE: J5.5, U7.6, U10.3
/FE_N: U7.4, U7.5; also elsewhere on the board
/FILL: J1.44, U13.8 (1A3)
/FMNM: U9.1, U10.4
/FM_N: J5.4, U7.2, U8.13, U9.2; also elsewhere on the board
/H0: J1.20, U5.9 (R3)
/H1: J1.21, U5.12 (R4)
/H2: J1.24, U5.14 (R5)
/HA_G: Q1.2 (G), U9.4
/HA_L_N: J2.29, Q1.3 (D)
/HA_RX: J1.42, U6.12 (D)
/HB_G: Q2.2 (G), U9.10
/HB_L_N: J2.30, Q2.3 (D)
/HC0: J2.11, U2.4 (I0)
/HC1: J2.12, U2.3 (I1)
/HC2: J2.13, U2.2 (I2)
/HC3: J2.14, U2.1 (I3)
/HC4: J2.15, U2.15 (I4)
/HC5: J2.16, U2.14 (I5)
/HC6: J2.17, U2.13 (I6)
/HC7: J2.18, U2.12 (I7)
/LEDK0: D5.1 (K), RN4.2 (R1)
/LEDK1: D6.1 (K), RN4.3 (R2)
/LEDK2: D7.1 (K), RN4.4 (R3)
/LEDK3: D8.1 (K), RN4.5 (R4)
/LEDK4: D9.1 (K), RN4.6 (R5)
/LEDK5: D10.1 (K), RN5.2 (R1)
/LEDK6: D11.1 (K), RN5.3 (R2)
/LEDK7: D12.1 (K), RN5.4 (R3)
/LEDK8: D13.1 (K), RN5.5 (R4)
/LEDK9: D14.1 (K), RN5.6 (R5)
/LOOP_HB: J1.22, U13.4 (1A1)
/MUTE_BLK: J1.37, U10.5
/M_N: U7.12, U8.2, U9.6
/N1: U11.6, U11.12
/N2: U11.8, U11.13
/ON: U8.3, U8.12, U11.1
/POS0: JP1.1, RN2.2 (R1), U5.3 (R0)
/POS1: JP1.3, RN2.3 (R2), U5.5 (R1)
/POS2: JP1.5, RN2.4 (R3), U5.7 (R2)
/P_C_TX: JP3.2, JP3.4, JP3.6, JP3.8, JP3.10, JP3.12, JP3.14, JP3.16, U12.4 (Za)
/P_WR_N: JP2.2, JP2.4, JP2.6, JP2.8, JP2.10, JP2.12, JP2.14, JP2.16, RN2.5 (R4), U10.9
/RB: J5.7, U8.6, U12.1 (S)
/RBT: J1.43, U12.3 (I1a)
/RCX: U11.3, U11.4, U11.9
/RC_E: U7.3; also elsewhere on the board
/RC_M: U7.1; also elsewhere on the board
/REL_E_N: U7.10, U8.10
/REL_M_N: U7.8, U8.9
/RING_CAD_N: J1.40, U11.2
/RST_N: J1.23, U6.1 (~R), U6.13 (~R), U8.11
/RX_OCT: J1.46, U13.15 (2A1)
/SCAN0: J2.3, U4.2 (P0), U5.2 (P0)
/SCAN1: J2.4, U4.4 (P1), U5.4 (P1)
/SCAN2: J2.5, U4.6 (P2), U5.6 (P2)
/SCAN3: J2.6, U4.8 (P3), U5.8 (P3)
/SCAN4: J2.7, U4.11 (P4), U5.11 (P4)
/SCAN5: J2.8, U4.13 (P5), U5.13 (P5)
/SRC0: J2.23, U1.3 (D0)
/SRC1: J2.24, U1.4 (D1)
/SRC2: J2.25, U1.7 (D2)
/SRC3: J2.26, U1.8 (D3)
/SRC4: J2.27, U1.13 (D4)
/SRC5: J2.28, U1.14 (D5)
/STB0_N: J1.3, U3.4 (I0)
/STB1_N: J1.6, U3.3 (I1)
/STB2_N: J1.7, U3.2 (I2)
/STB3_N: J1.10, U3.1 (I3)
/STB4_N: J1.11, U3.15 (I4), U9.11
/STB5_N: J1.14, U3.14 (I5)
/STB6_N: J1.15, U3.13 (I6)
/STB7_N: J1.18, U3.12 (I7)
/TX_CLK: J1.19, U13.2 (1A0), U13.17 (2A0)
/TX_OCT: J1.45, U13.6 (1A2)
/WA: J5.9, U6.11 (C), U9.13
/WC: J5.8, U3.6 (~Z), U6.3 (C)
/WORD0: J2.41, JP4.1
/WORD1: J2.42, JP4.3
/WORD2: J2.43, JP4.5
/WORD3: J2.44, JP4.7
/WORD4: J2.45, JP4.9
/WORD5: J2.46, JP4.11
/WORD6: J2.47, JP4.13
/WORD7: J2.48, JP4.15
/WR0_N: J1.26, JP2.1
/WR1_N: J1.27, JP2.3
/WR2_N: J1.30, JP2.5
/WR3_N: J1.31, JP2.7
/WR4_N: J1.34, JP2.9
/WR5_N: J1.35, JP2.11
/WR6_N: J1.38, JP2.13
/WR7_N: J1.39, JP2.15
/WRCLK: J5.11, U1.11 (Cp), U10.13
GND: C5.2, C6.2, C7.2, C8.2, C9.2, C10.2, C11.2, C12.2, C13.2, C14.2, C15.2, C16.2, C17.2, C18.2, J1.4, J1.5, J1.8, J1.9, J1.12, J1.13, J1.16, J1.17, J1.25, J1.28, J1.29, J1.32, J1.33, J1.36, J1.41, J2.2, J2.19, J2.49, J4.4, J4.8, J4.12, J4.16, J4.21, J4.22, J4.28, J4.31, J4.32, J4.33, J4.34, J5.1, JP1.2, JP1.4, JP1.6, Q1.1 (S), Q2.1 (S), R1.2, RN4.1 (common), RN5.1 (common), U1.10 (GND), U2.7 (~E), U2.8 (GND), U3.7 (~E), U3.8 (GND), U4.1 (G), U4.10 (GND), U4.15 (P6), U4.16 (R6), U4.17 (P7), U4.18 (R7), U5.1 (G), U5.10 (GND), U5.15 (P6), U5.16 (R6), U5.17 (P7), U5.18 (R7), U6.7 (GND), U7.7 (GND), U8.7 (GND), U9.7 (GND), U10.7 (VSS), U10.10, U10.11, U10.12, U11.7 (GND), U12.5 (I0b), U12.6 (I1b), U12.8 (GND), U12.10 (I1c), U12.11 (I0c), U12.13 (I1d), U12.14 (I0d), U12.15 (E), U13.1 (1OE), U13.10 (GND), U13.19 (2OE); also elsewhere on the board

Notes on the sheet:
Port-state LEDs (RevB): one per flip-flop, 1k bussed to GND

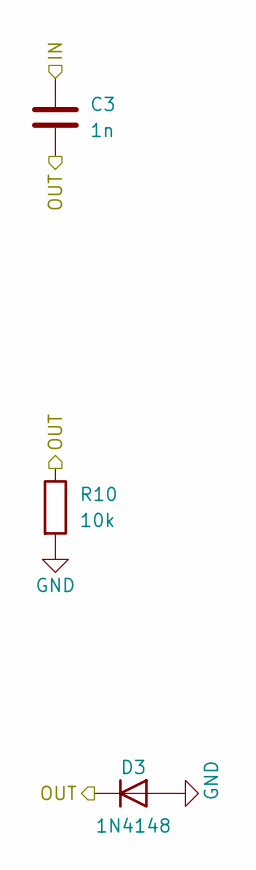
[picture p6: schematic cr.kicad_sch, cr_rel: a detector's fall, differentiated into the '273's /…]

Parts:
C3: 1n; C_Disc_D5.0mm_W2.5mm_P2.50mm
D3: 1N4148; D_DO-35_SOD27_P2.54mm_Vertical_AnodeUp
R10: 10k; R_Axial_DIN0207_L6.3mm_D2.5mm_P2.54mm_Vertical

Connections:
/CR_M: C3.2, D3.1 (K), R10.1; also elsewhere on the board
/FM_N: C3.1; also elsewhere on the board
GND: D3.2 (A), R10.2; also elsewhere on the board

Parts of its further copies:
C4: 1n; C_Disc_D5.0mm_W2.5mm_P2.50mm
D4: 1N4148; D_DO-35_SOD27_P2.54mm_Vertical_AnodeUp
R11: 10k; R_Axial_DIN0207_L6.3mm_D2.5mm_P2.54mm_Vertical

Connections of its further copies:
/CR_E: C4.2, D4.1 (K), R11.1; also elsewhere on the board
/FE_N: C4.1; also elsewhere on the board
GND: D4.2 (A), R11.2; also elsewhere on the board

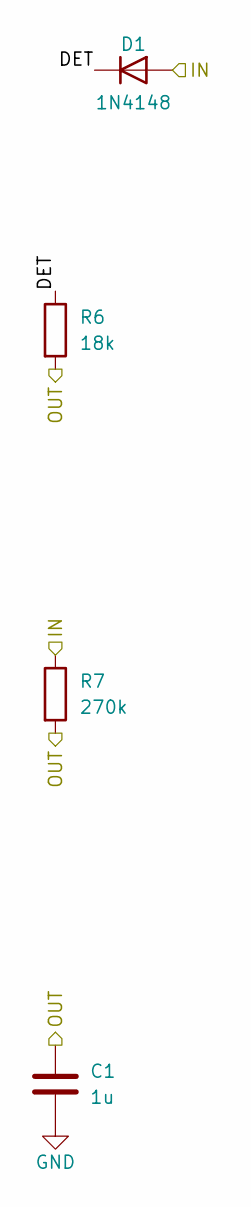
[picture p7: schematic det.kicad_sch, rc_det: the supervision detector -- fast up through D and R…]

Parts:
C1: 1u; C_Rect_L7.2mm_W3.5mm_P5.00mm_FKS2_FKP2_MKS2_MKP2
D1: 1N4148; D_DO-35_SOD27_P2.54mm_Vertical_AnodeUp
R6: 18k; R_Axial_DIN0207_L6.3mm_D2.5mm_P2.54mm_Vertical
R7: 270k; R_Axial_DIN0207_L6.3mm_D2.5mm_P2.54mm_Vertical

Connections:
/DETM/DET: D1.1 (K), R6.1
/E_A_TX: D1.2 (A), R7.1; also elsewhere on the board
/RC_M: C1.1, R6.2, R7.2; also elsewhere on the board
GND: C1.2; also elsewhere on the board

Parts of its further copies:
C2: 1u; C_Rect_L7.2mm_W3.5mm_P5.00mm_FKS2_FKP2_MKS2_MKP2
D2: 1N4148; D_DO-35_SOD27_P2.54mm_Vertical_AnodeUp
R8: 18k; R_Axial_DIN0207_L6.3mm_D2.5mm_P2.54mm_Vertical
R9: 270k; R_Axial_DIN0207_L6.3mm_D2.5mm_P2.54mm_Vertical

Connections of its further copies:
/DETE/DET: D2.1 (K), R8.1
/E: D2.2 (A), R9.1; also elsewhere on the board
/RC_E: C2.1, R8.2, R9.2; also elsewhere on the board
GND: C2.2; also elsewhere on the board

Board: 2 copper layers, 75 parts (0 on the bottom side), 146 nets, no tracks yet.

Other parts of the board:
H1, H2, H3, H4: M3; MountingHole_3.2mm_M3
