retrac0/retelex/pcb/blkhdr_bus_RevA/blkhdr_bus_RevA.kicad_pcb

## KiCad design pcb/blkhdr_bus_RevA/blkhdr_bus_RevA.kicad_pcb (2026-09-27)

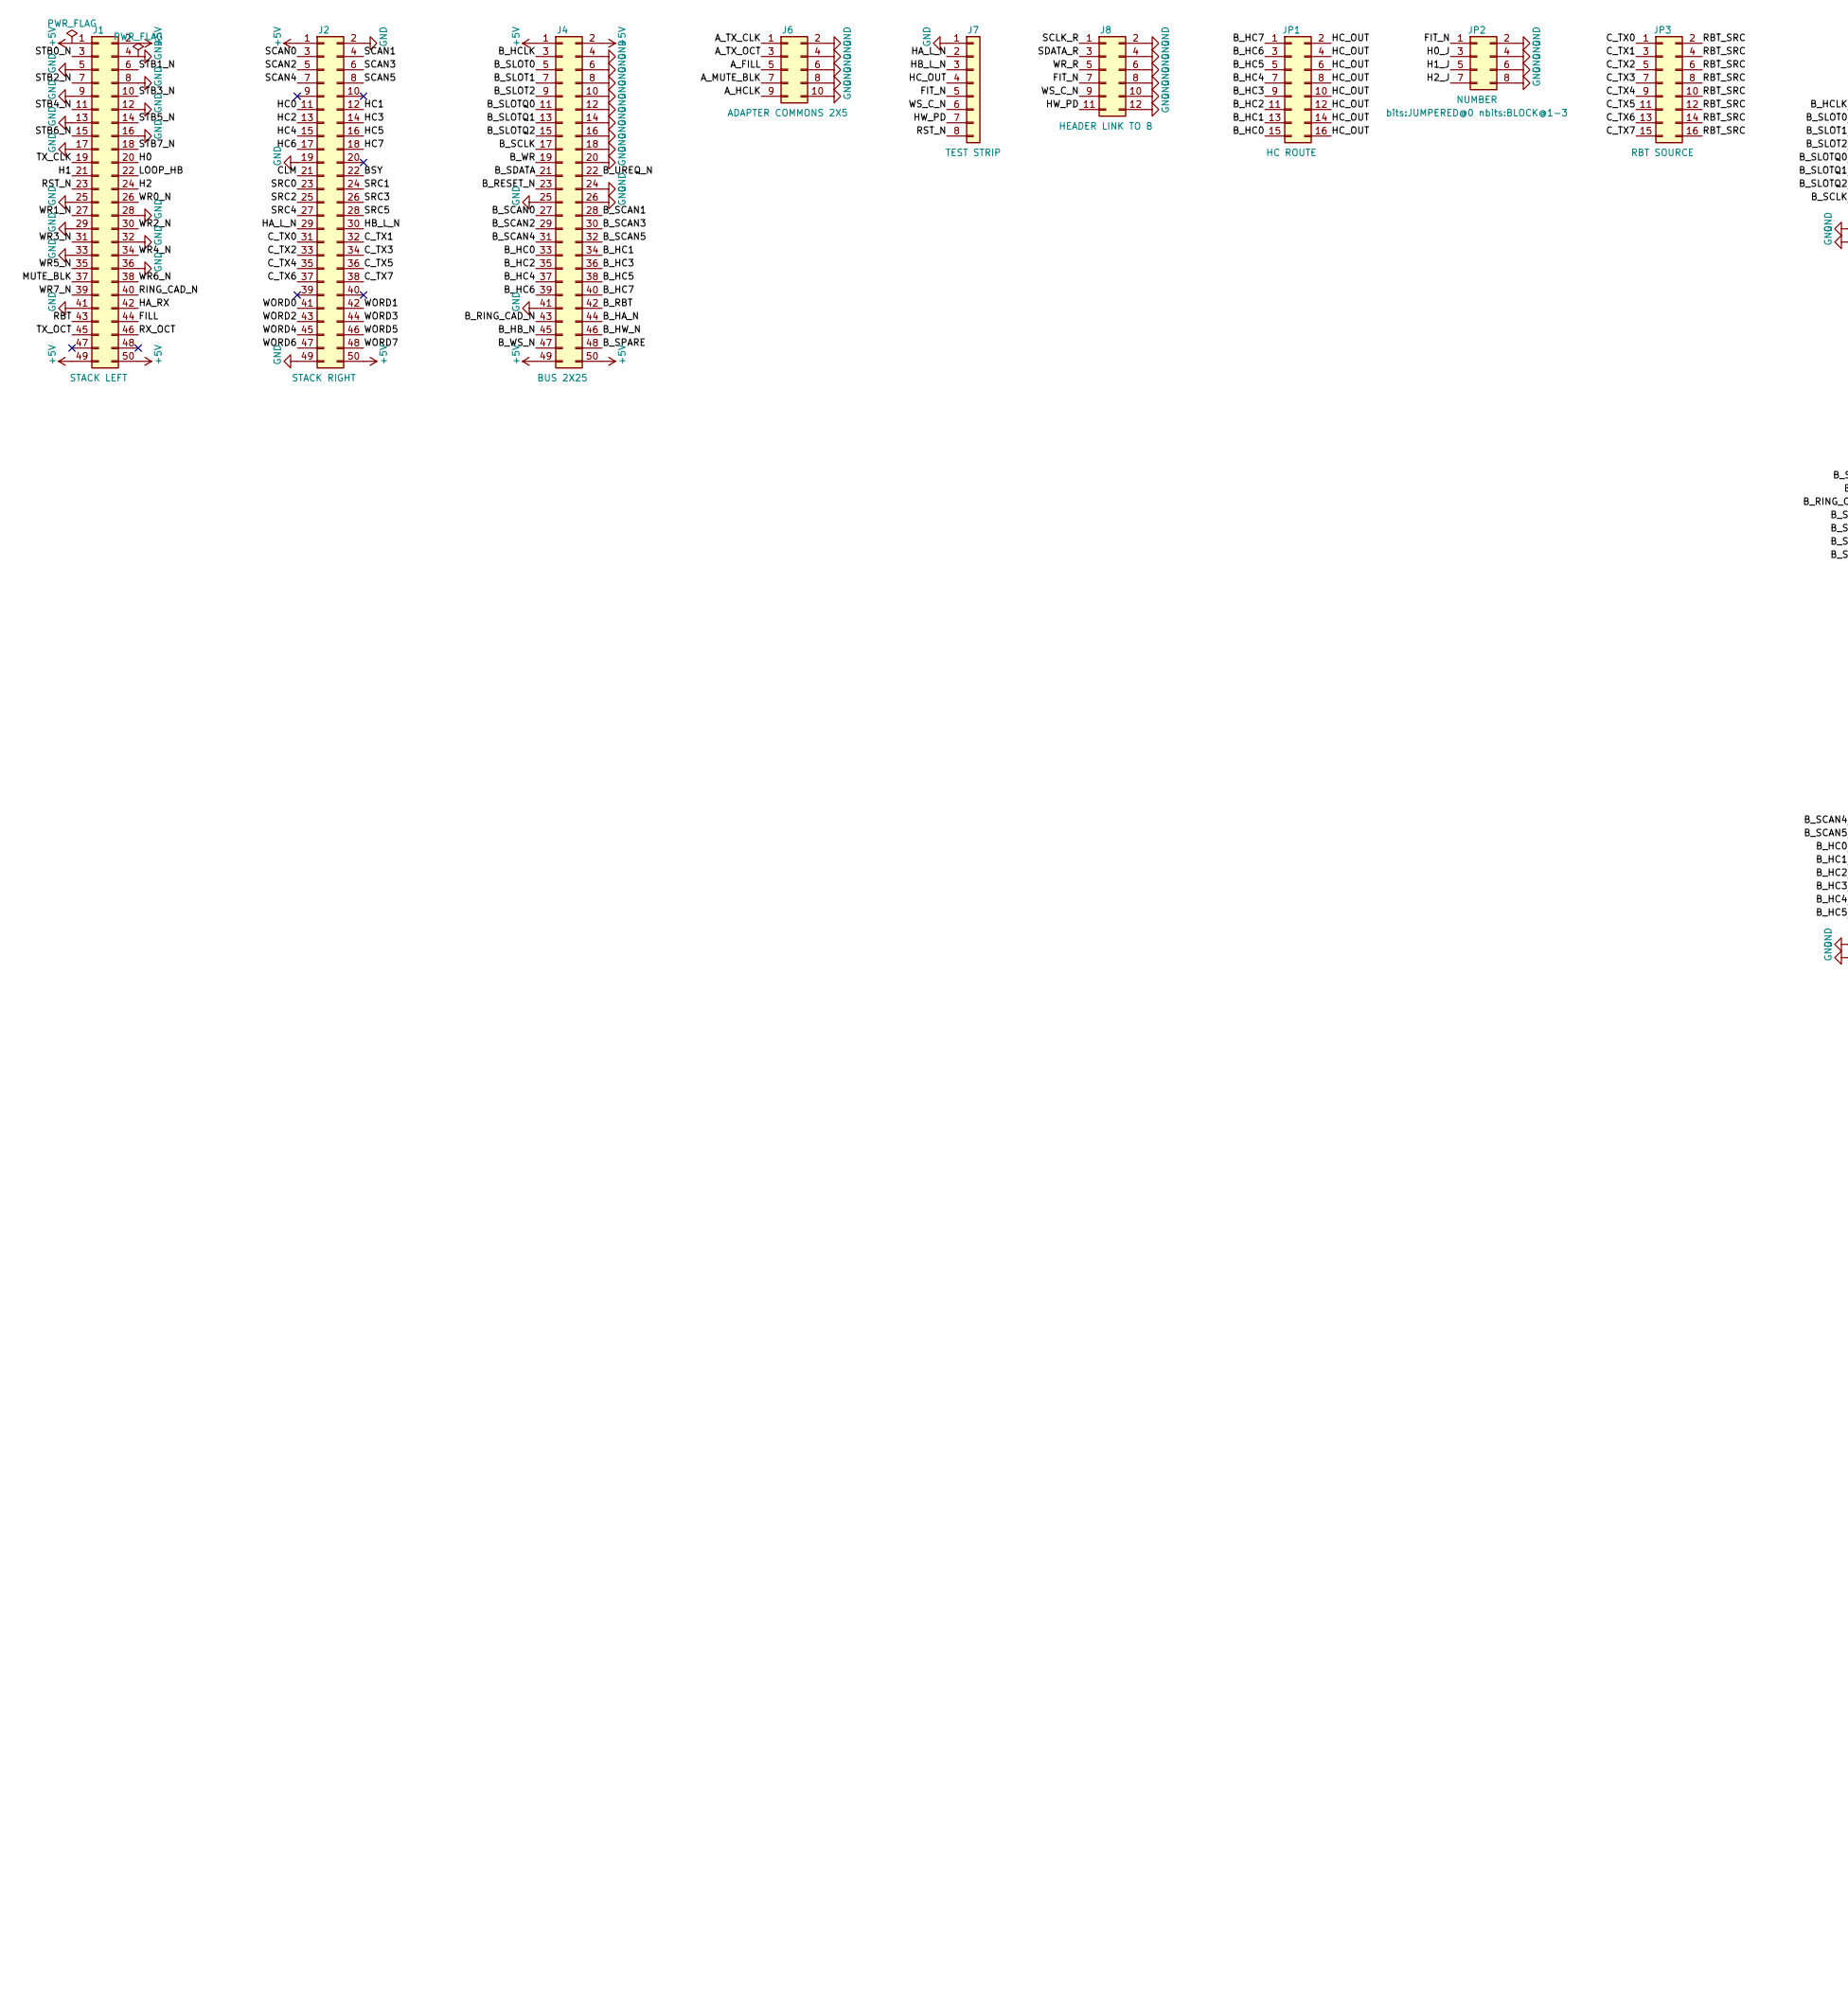
[picture p8: schematic blkhdr_bus_RevA.kicad_sch, Block header A, the bus board -- the bottom card of a block…, part in row 1, column 1]

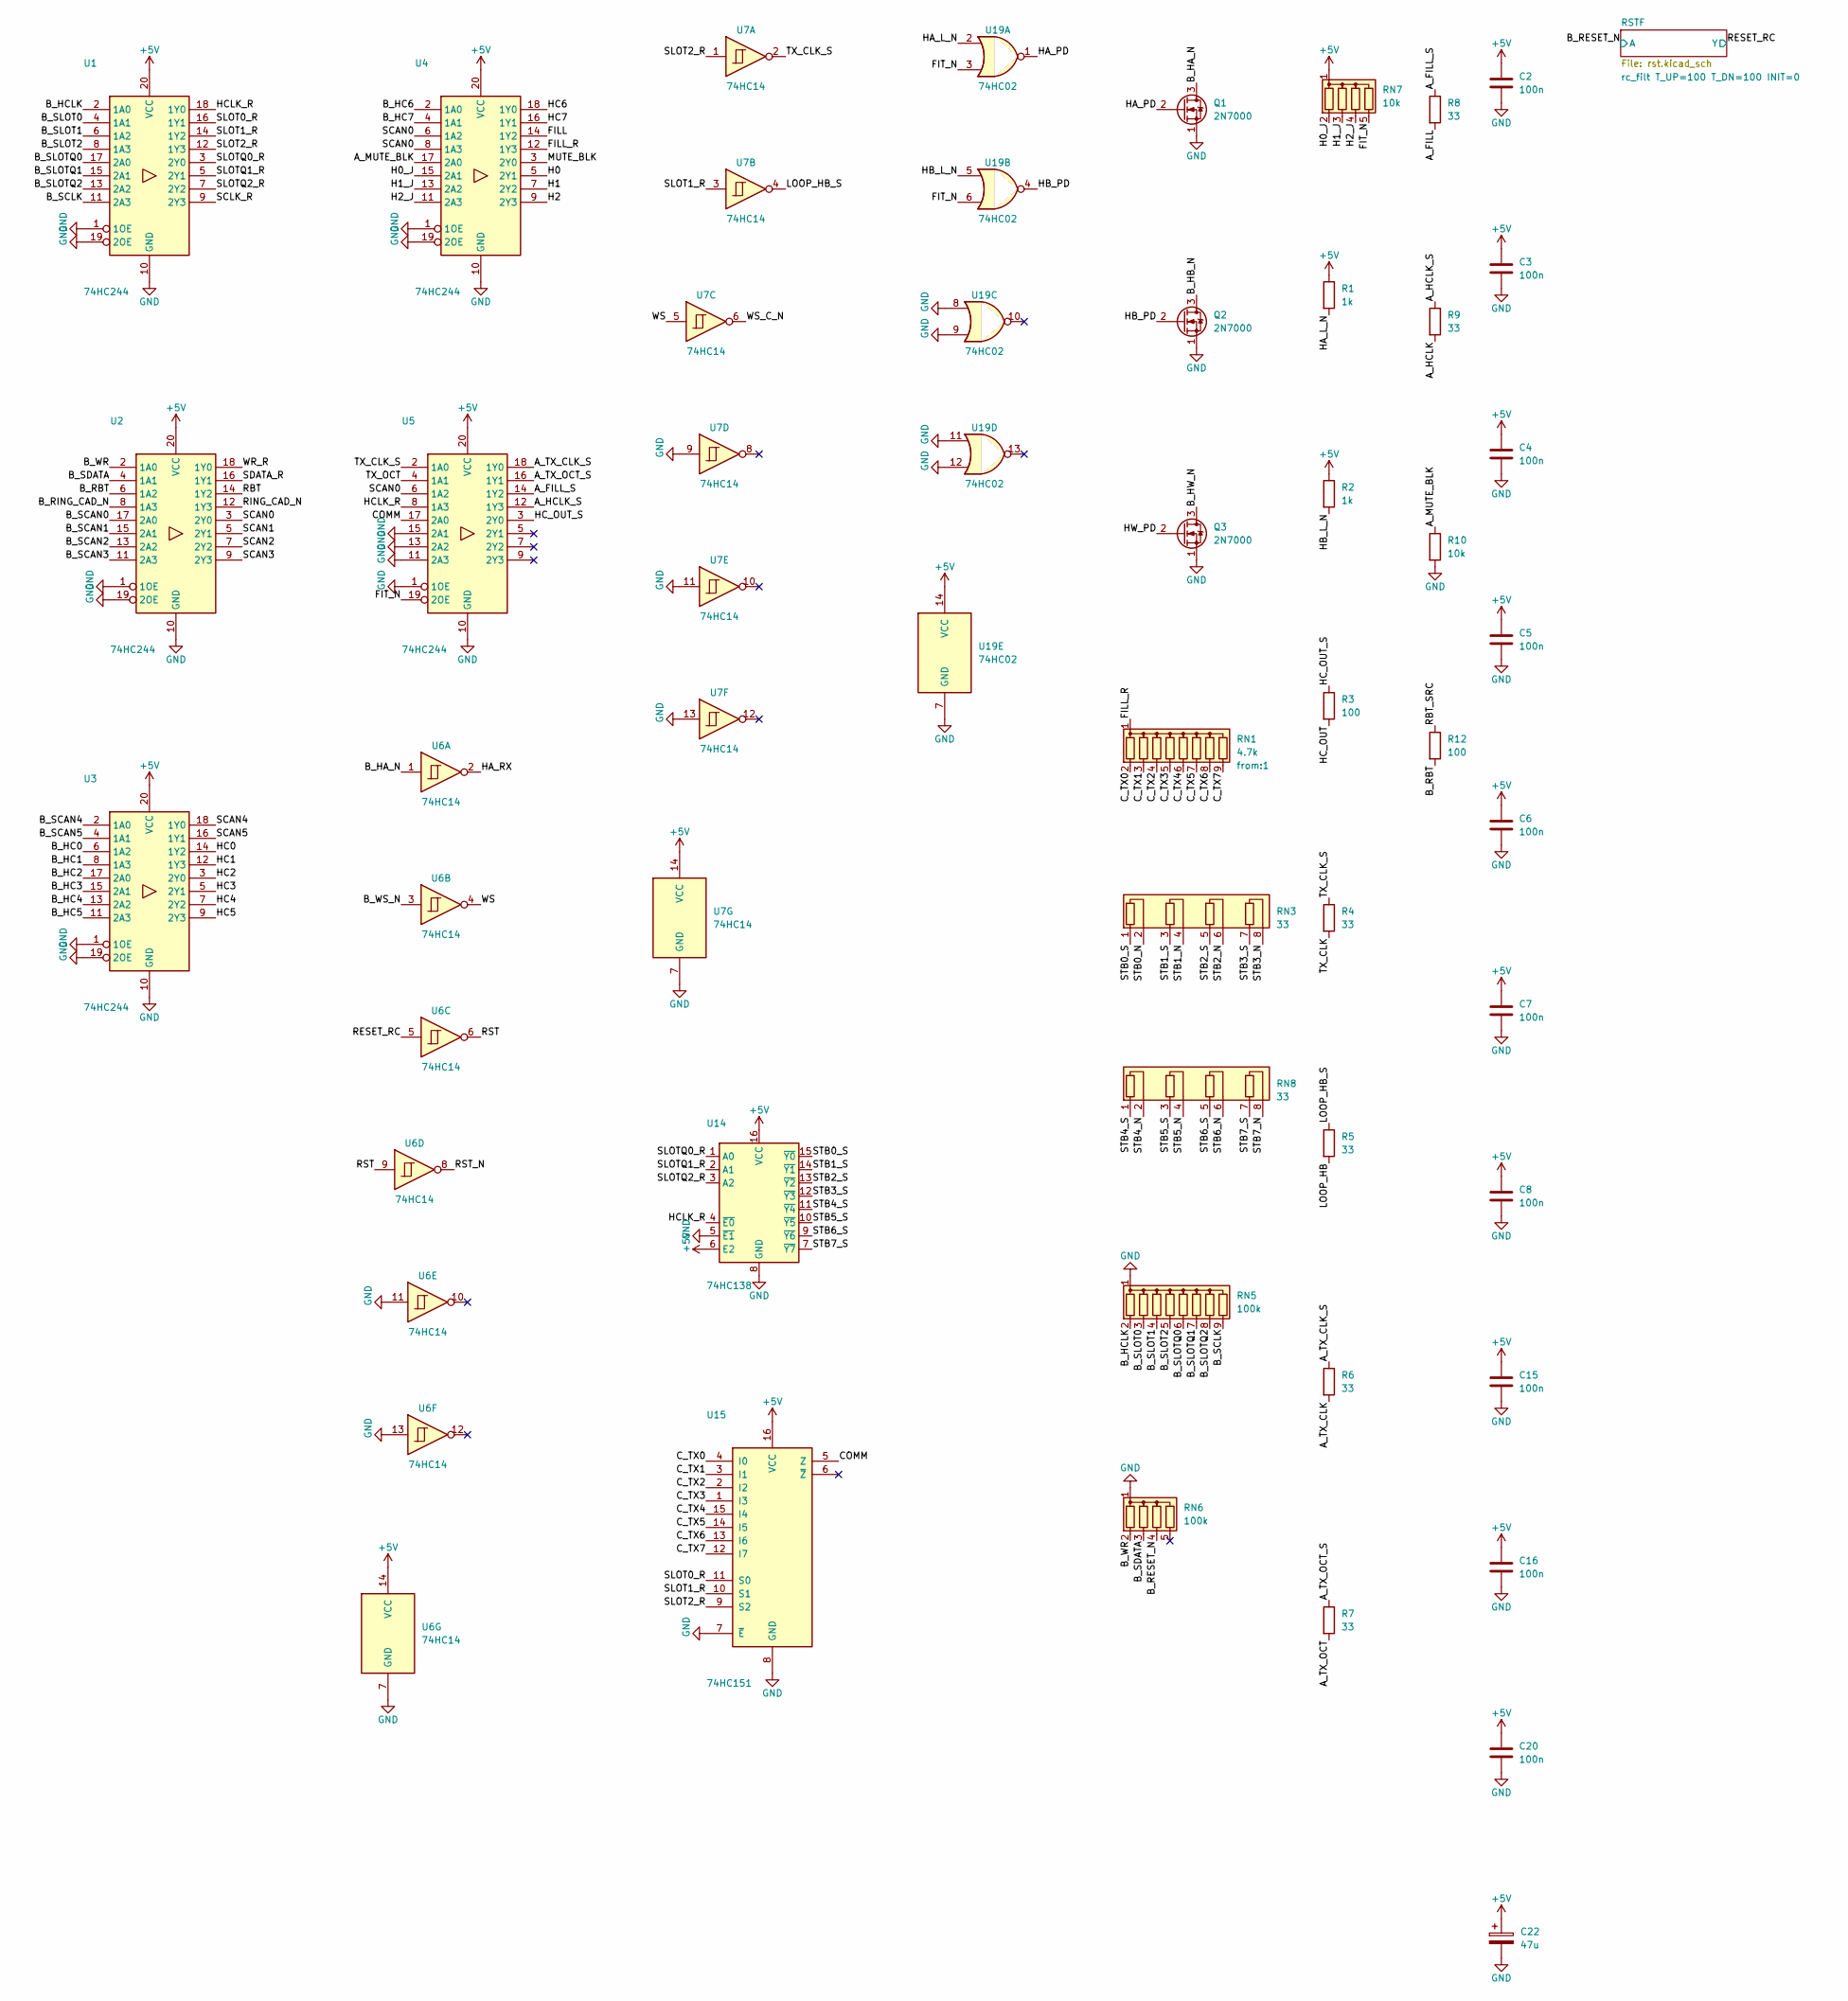
[picture p9: schematic blkhdr_bus_RevA.kicad_sch, Block header A, the bus board -- the bottom card of a block…, part in row 1, column 2]

Parts:
C2, C3, C4, C5, C6, C7, C8, C15, C16, C20: 100n; C_Disc_D3.0mm_W1.6mm_P2.50mm
C22: 47u; CP_Radial_D4.0mm_P1.50mm
J1: STACK LEFT; PinSocket_2x25_P2.54mm_Vertical
J2: STACK RIGHT; PinSocket_2x25_P2.54mm_Vertical
J4: BUS 2X25; IDC-Header_2x25_P2.54mm_Horizontal
J6: ADAPTER COMMONS 2X5; IDC-Header_2x05_P2.54mm_Horizontal
J7: TEST STRIP; PinHeader_1x08_P2.54mm_Horizontal
J8: HEADER LINK TO B; PinSocket_2x06_P2.54mm_Vertical
JP1: HC ROUTE; PinHeader_2x08_P2.54mm_Vertical
JP2: NUMBER; PinHeader_2x04_P2.54mm_Vertical
JP3: RBT SOURCE; PinHeader_2x08_P2.54mm_Vertical
Q1, Q2, Q3: 2N7000; TO-92_Inline
R1, R2: 1k; R_Axial_DIN0207_L6.3mm_D2.5mm_P2.54mm_Vertical
R3, R12: 100; R_Axial_DIN0207_L6.3mm_D2.5mm_P2.54mm_Vertical
R4, R5, R6, R7, R8, R9: 33; R_Axial_DIN0207_L6.3mm_D2.5mm_P2.54mm_Vertical
R10: 10k; R_Axial_DIN0207_L6.3mm_D2.5mm_P2.54mm_Vertical
RN1: 4.7k; R_Array_SIP9
RN3, RN8: 33; R_Array_SIP8
RN5: 100k; R_Array_SIP9
RN6: 100k; R_Array_SIP5
RN7: 10k; R_Array_SIP5
U1, U2, U3, U4, U5: 74HC244; DIP-20_W7.62mm
U6, U7: 74HC14; DIP-14_W7.62mm
U14: 74HC138; DIP-16_W7.62mm
U15: 74HC151; DIP-16_W7.62mm
U19: 74HC02; DIP-14_W7.62mm

Connections:
+5V: C2.1, C3.1, C4.1, C5.1, C6.1, C7.1, C8.1, C15.1, C16.1, C20.1, C22.1, J1.1, J1.2, J1.49, J1.50, J2.1, J2.50, J4.1, J4.2, J4.49, J4.50, R1.1, R2.1, RN7.1 (common), U1.20 (VCC), U2.20 (VCC), U3.20 (VCC), U4.20 (VCC), U5.20 (VCC), U6.14 (VCC), U7.14 (VCC), U14.6 (E2), U14.16 (VCC), U15.16 (VCC), U19.14 (VCC)
/A_FILL: J6.5, R8.2
/A_FILL_S: R8.1, U5.14 (1Y2)
/A_HCLK: J6.9, R9.2
/A_HCLK_S: R9.1, U5.12 (1Y3)
/A_MUTE_BLK: J6.7, R10.1, U4.17 (2A0)
/A_TX_CLK: J6.1, R6.2
/A_TX_CLK_S: R6.1, U5.18 (1Y0)
/A_TX_OCT: J6.3, R7.2
/A_TX_OCT_S: R7.1, U5.16 (1Y1)
/BSY: J2.22
/B_HA_N: J4.44, Q1.3 (D), U6.1
/B_HB_N: J4.45, Q2.3 (D)
/B_HC0: J4.33, JP1.15, U3.6 (1A2)
/B_HC1: J4.34, JP1.13, U3.8 (1A3)
/B_HC2: J4.35, JP1.11, U3.17 (2A0)
/B_HC3: J4.36, JP1.9, U3.15 (2A1)
/B_HC4: J4.37, JP1.7, U3.13 (2A2)
/B_HC5: J4.38, JP1.5, U3.11 (2A3)
/B_HC6: J4.39, JP1.3, U4.2 (1A0)
/B_HC7: J4.40, JP1.1, U4.4 (1A1)
/B_HCLK: J4.3, RN5.2 (R1), U1.2 (1A0)
/B_HW_N: J4.46, Q3.3 (D)
/B_RBT: J4.42, R12.2, U2.6 (1A2)
/B_RESET_N: J4.23, RN6.4 (R3); also elsewhere on the board
/B_RING_CAD_N: J4.43, U2.8 (1A3)
/B_SCAN0: J4.27, U2.17 (2A0)
/B_SCAN1: J4.28, U2.15 (2A1)
/B_SCAN2: J4.29, U2.13 (2A2)
/B_SCAN3: J4.30, U2.11 (2A3)
/B_SCAN4: J4.31, U3.2 (1A0)
/B_SCAN5: J4.32, U3.4 (1A1)
/B_SCLK: J4.17, RN5.9 (R8), U1.11 (2A3)
/B_SDATA: J4.21, RN6.3 (R2), U2.4 (1A1)
/B_SLOT0: J4.5, RN5.3 (R2), U1.4 (1A1)
/B_SLOT1: J4.7, RN5.4 (R3), U1.6 (1A2)
/B_SLOT2: J4.9, RN5.5 (R4), U1.8 (1A3)
/B_SLOTQ0: J4.11, RN5.6 (R5), U1.17 (2A0)
/B_SLOTQ1: J4.13, RN5.7 (R6), U1.15 (2A1)
/B_SLOTQ2: J4.15, RN5.8 (R7), U1.13 (2A2)
/B_SPARE: J4.48
/B_UREQ_N: J4.22
/B_WR: J4.19, RN6.2 (R1), U2.2 (1A0)
/B_WS_N: J4.47, U6.3
/CLM: J2.21
/COMM: U5.17 (2A0), U15.5 (Z)
/C_TX0: J2.31, JP3.1, RN1.2 (R1), U15.4 (I0)
/C_TX1: J2.32, JP3.3, RN1.3 (R2), U15.3 (I1)
/C_TX2: J2.33, JP3.5, RN1.4 (R3), U15.2 (I2)
/C_TX3: J2.34, JP3.7, RN1.5 (R4), U15.1 (I3)
/C_TX4: J2.35, JP3.9, RN1.6 (R5), U15.15 (I4)
/C_TX5: J2.36, JP3.11, RN1.7 (R6), U15.14 (I5)
/C_TX6: J2.37, JP3.13, RN1.8 (R7), U15.13 (I6)
/C_TX7: J2.38, JP3.15, RN1.9 (R8), U15.12 (I7)
/FILL: J1.44, U4.14 (1Y2)
/FILL_R: RN1.1 (common), U4.12 (1Y3)
/FIT_N: J7.5, J8.7, JP2.1, RN7.5 (R4), U5.19 (2OE), U19.3, U19.6
/H0: J1.20, U4.5 (2Y1)
/H0_J: JP2.3, RN7.2 (R1), U4.15 (2A1)
/H1: J1.21, U4.7 (2Y2)
/H1_J: JP2.5, RN7.3 (R2), U4.13 (2A2)
/H2: J1.24, U4.9 (2Y3)
/H2_J: JP2.7, RN7.4 (R3), U4.11 (2A3)
/HA_L_N: J2.29, J7.2, R1.2, U19.2
/HA_PD: Q1.2 (G), U19.1
/HA_RX: J1.42, U6.2
/HB_L_N: J2.30, J7.3, R2.2, U19.5
/HB_PD: Q2.2 (G), U19.4
/HC0: J2.11, U3.14 (1Y2)
/HC1: J2.12, U3.12 (1Y3)
/HC2: J2.13, U3.3 (2Y0)
/HC3: J2.14, U3.5 (2Y1)
/HC4: J2.15, U3.7 (2Y2)
/HC5: J2.16, U3.9 (2Y3)
/HC6: J2.17, U4.18 (1Y0)
/HC7: J2.18, U4.16 (1Y1)
/HCLK_R: U1.18 (1Y0), U5.8 (1A3), U14.4 (~E0)
/HC_OUT: J7.4, JP1.2, JP1.4, JP1.6, JP1.8, JP1.10, JP1.12, JP1.14, JP1.16, R3.2
/HC_OUT_S: R3.1, U5.3 (2Y0)
/HW_PD: J7.7, J8.11, Q3.2 (G)
/LOOP_HB: J1.22, R5.2
/LOOP_HB_S: R5.1, U7.4
/MUTE_BLK: J1.37, U4.3 (2Y0)
/RBT: J1.43, U2.14 (1Y2)
/RBT_SRC: JP3.2, JP3.4, JP3.6, JP3.8, JP3.10, JP3.12, JP3.14, JP3.16, R12.1
/RESET_RC: U6.5; also elsewhere on the board
/RING_CAD_N: J1.40, U2.12 (1Y3)
/RST: U6.6, U6.9
/RST_N: J1.23, J7.8, U6.8
/RX_OCT: J1.46
/SCAN0: J2.3, U2.3 (2Y0), U4.6 (1A2), U4.8 (1A3), U5.6 (1A2)
/SCAN1: J2.4, U2.5 (2Y1)
/SCAN2: J2.5, U2.7 (2Y2)
/SCAN3: J2.6, U2.9 (2Y3)
/SCAN4: J2.7, U3.18 (1Y0)
/SCAN5: J2.8, U3.16 (1Y1)
/SCLK_R: J8.1, U1.9 (2Y3)
/SDATA_R: J8.3, U2.16 (1Y1)
/SLOT0_R: U1.16 (1Y1), U15.11 (S0)
/SLOT1_R: U1.14 (1Y2), U7.3, U15.10 (S1)
/SLOT2_R: U1.12 (1Y3), U7.1, U15.9 (S2)
/SLOTQ0_R: U1.3 (2Y0), U14.1 (A0)
/SLOTQ1_R: U1.5 (2Y1), U14.2 (A1)
/SLOTQ2_R: U1.7 (2Y2), U14.3 (A2)
/SRC0: J2.23
/SRC1: J2.24
/SRC2: J2.25
/SRC3: J2.26
/SRC4: J2.27
/SRC5: J2.28
/STB0_N: J1.3, RN3.2 (R1.2)
/STB0_S: RN3.1 (R1.1), U14.15 (~Y0)
/STB1_N: J1.6, RN3.4 (R2.2)
/STB1_S: RN3.3 (R2.1), U14.14 (~Y1)
/STB2_N: J1.7, RN3.6 (R3.2)
/STB2_S: RN3.5 (R3.1), U14.13 (~Y2)
/STB3_N: J1.10, RN3.8 (R4.2)
/STB3_S: RN3.7 (R4.1), U14.12 (~Y3)
/STB4_N: J1.11, RN8.2 (R1.2)
/STB4_S: RN8.1 (R1.1), U14.11 (~Y4)
/STB5_N: J1.14, RN8.4 (R2.2)
/STB5_S: RN8.3 (R2.1), U14.10 (~Y5)
/STB6_N: J1.15, RN8.6 (R3.2)
/STB6_S: RN8.5 (R3.1), U14.9 (~Y6)
/STB7_N: J1.18, RN8.8 (R4.2)
/STB7_S: RN8.7 (R4.1), U14.7 (~Y7)
/TX_CLK: J1.19, R4.2
/TX_CLK_S: R4.1, U5.2 (1A0), U7.2
/TX_OCT: J1.45, U5.4 (1A1)
/WORD0: J2.41
/WORD1: J2.42
/WORD2: J2.43
/WORD3: J2.44
/WORD4: J2.45
/WORD5: J2.46
/WORD6: J2.47
/WORD7: J2.48
/WR0_N: J1.26
/WR1_N: J1.27
/WR2_N: J1.30
/WR3_N: J1.31
/WR4_N: J1.34
/WR5_N: J1.35
/WR6_N: J1.38
/WR7_N: J1.39
/WR_R: J8.5, U2.18 (1Y0)
/WS: U6.4, U7.5
/WS_C_N: J7.6, J8.9, U7.6
GND: C2.2, C3.2, C4.2, C5.2, C6.2, C7.2, C8.2, C15.2, C16.2, C20.2, C22.2, J1.4, J1.5, J1.8, J1.9, J1.12, J1.13, J1.16, J1.17, J1.25, J1.28, J1.29, J1.32, J1.33, J1.36, J1.41, J2.2, J2.19, J2.49, J4.4, J4.6, J4.8, J4.10, J4.12, J4.14, J4.16, J4.18, J4.20, J4.24, J4.25, J4.26, J4.41, J6.2, J6.4, J6.6, J6.8, J6.10, J7.1, J8.2, J8.4, J8.6, J8.8, J8.10, J8.12, JP2.2, JP2.4, JP2.6, JP2.8, Q1.1 (S), Q2.1 (S), Q3.1 (S), R10.2, RN5.1 (common), RN6.1 (common), U1.1 (1OE), U1.10 (GND), U1.19 (2OE), U2.1 (1OE), U2.10 (GND), U2.19 (2OE), U3.1 (1OE), U3.10 (GND), U3.19 (2OE), U4.1 (1OE), U4.10 (GND), U4.19 (2OE), U5.1 (1OE), U5.10 (GND), U5.11 (2A3), U5.13 (2A2), U5.15 (2A1), U6.7 (GND), U6.11, U6.13, U7.7 (GND), U7.9, U7.11, U7.13, U14.5 (~E1), U14.8 (GND), U15.7 (~E), U15.8 (GND), U19.7 (GND), U19.8, U19.9, U19.11, U19.12; also elsewhere on the board

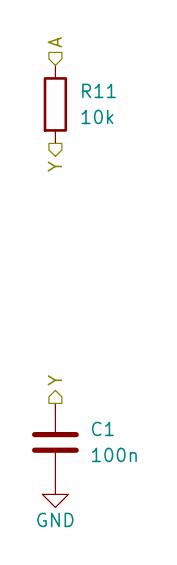
[picture p10: schematic rst.kicad_sch, rc_filt: the /RESET filter, 10k into 100n, about 1 ms (bus.…]

Parts:
C1: 100n; C_Disc_D5.0mm_W2.5mm_P2.50mm
R11: 10k; R_Axial_DIN0207_L6.3mm_D2.5mm_P2.54mm_Vertical

Connections:
/B_RESET_N: R11.1; also elsewhere on the board
/RESET_RC: C1.1, R11.2; also elsewhere on the board
GND: C1.2; also elsewhere on the board

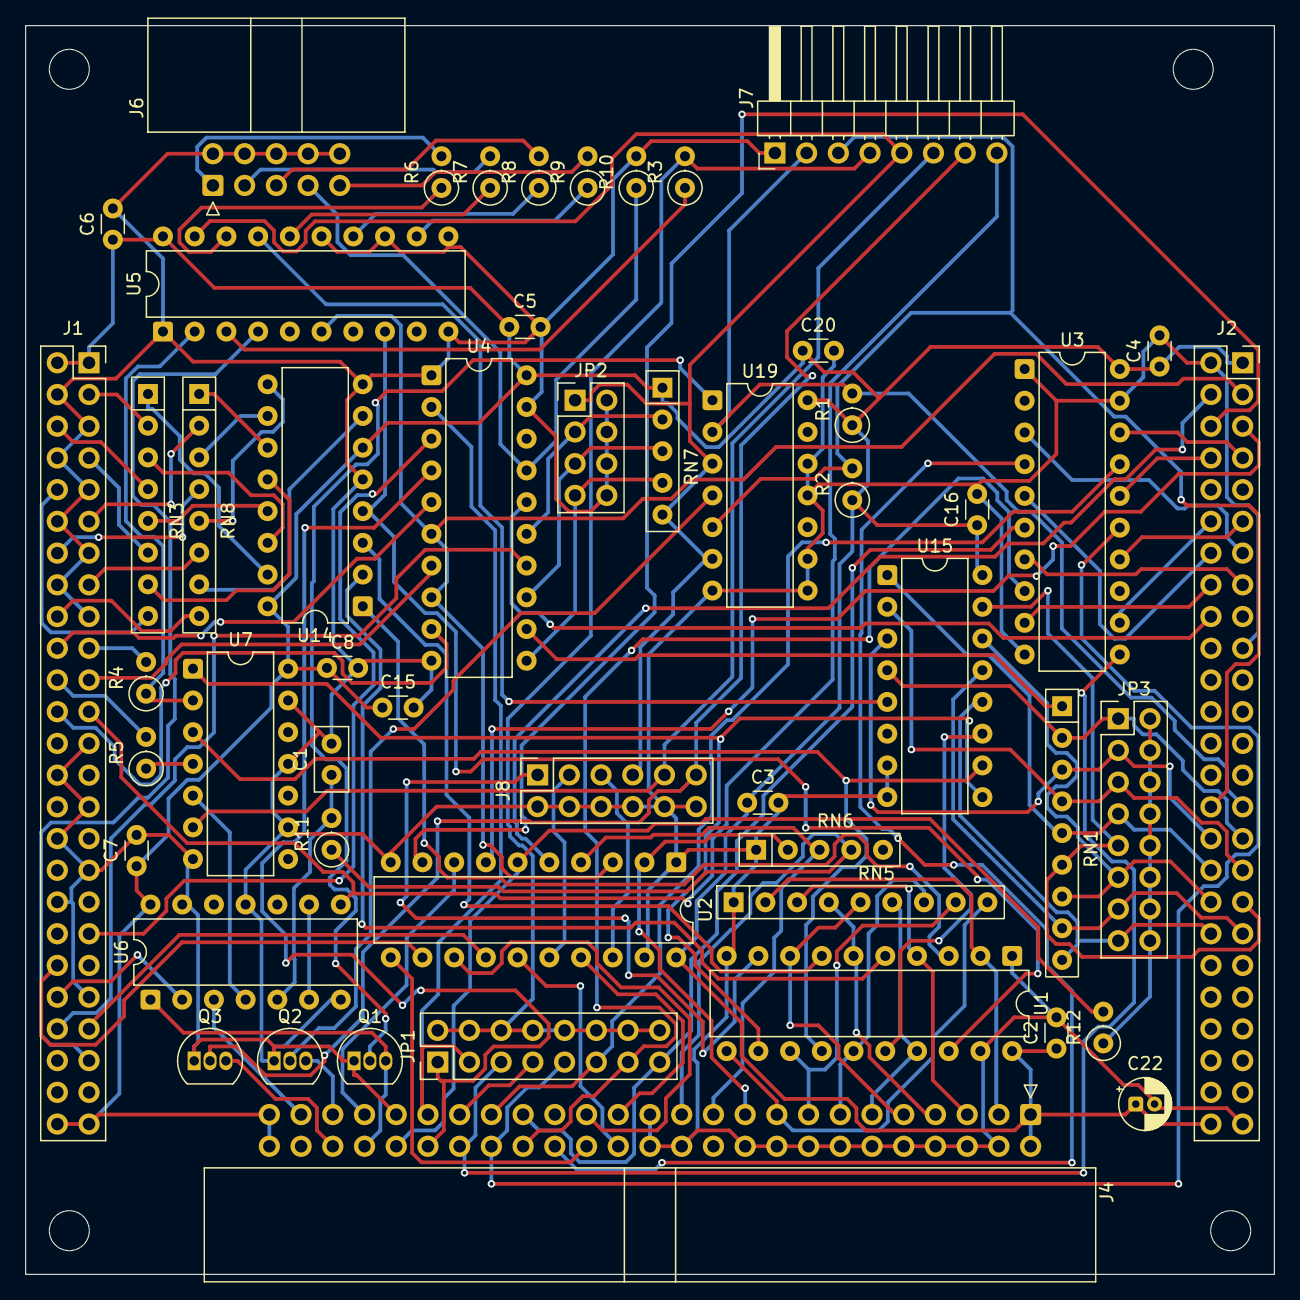
[picture p11: board blkhdr_bus_RevA.kicad_pcb from above]

Board: 2 copper layers, 100.0 x 100.0 mm, 56 parts (0 on the bottom side), 122 nets.

Other parts of the board:
H1, H2, H3, H4: M3; MountingHole_3.2mm_M3
