retrac0/retelex/pcb/blkhdr_logic_RevA/blkhdr_logic_RevA.kicad_pcb

## KiCad design pcb/blkhdr_logic_RevA/blkhdr_logic_RevA.kicad_pcb (2026-09-27)

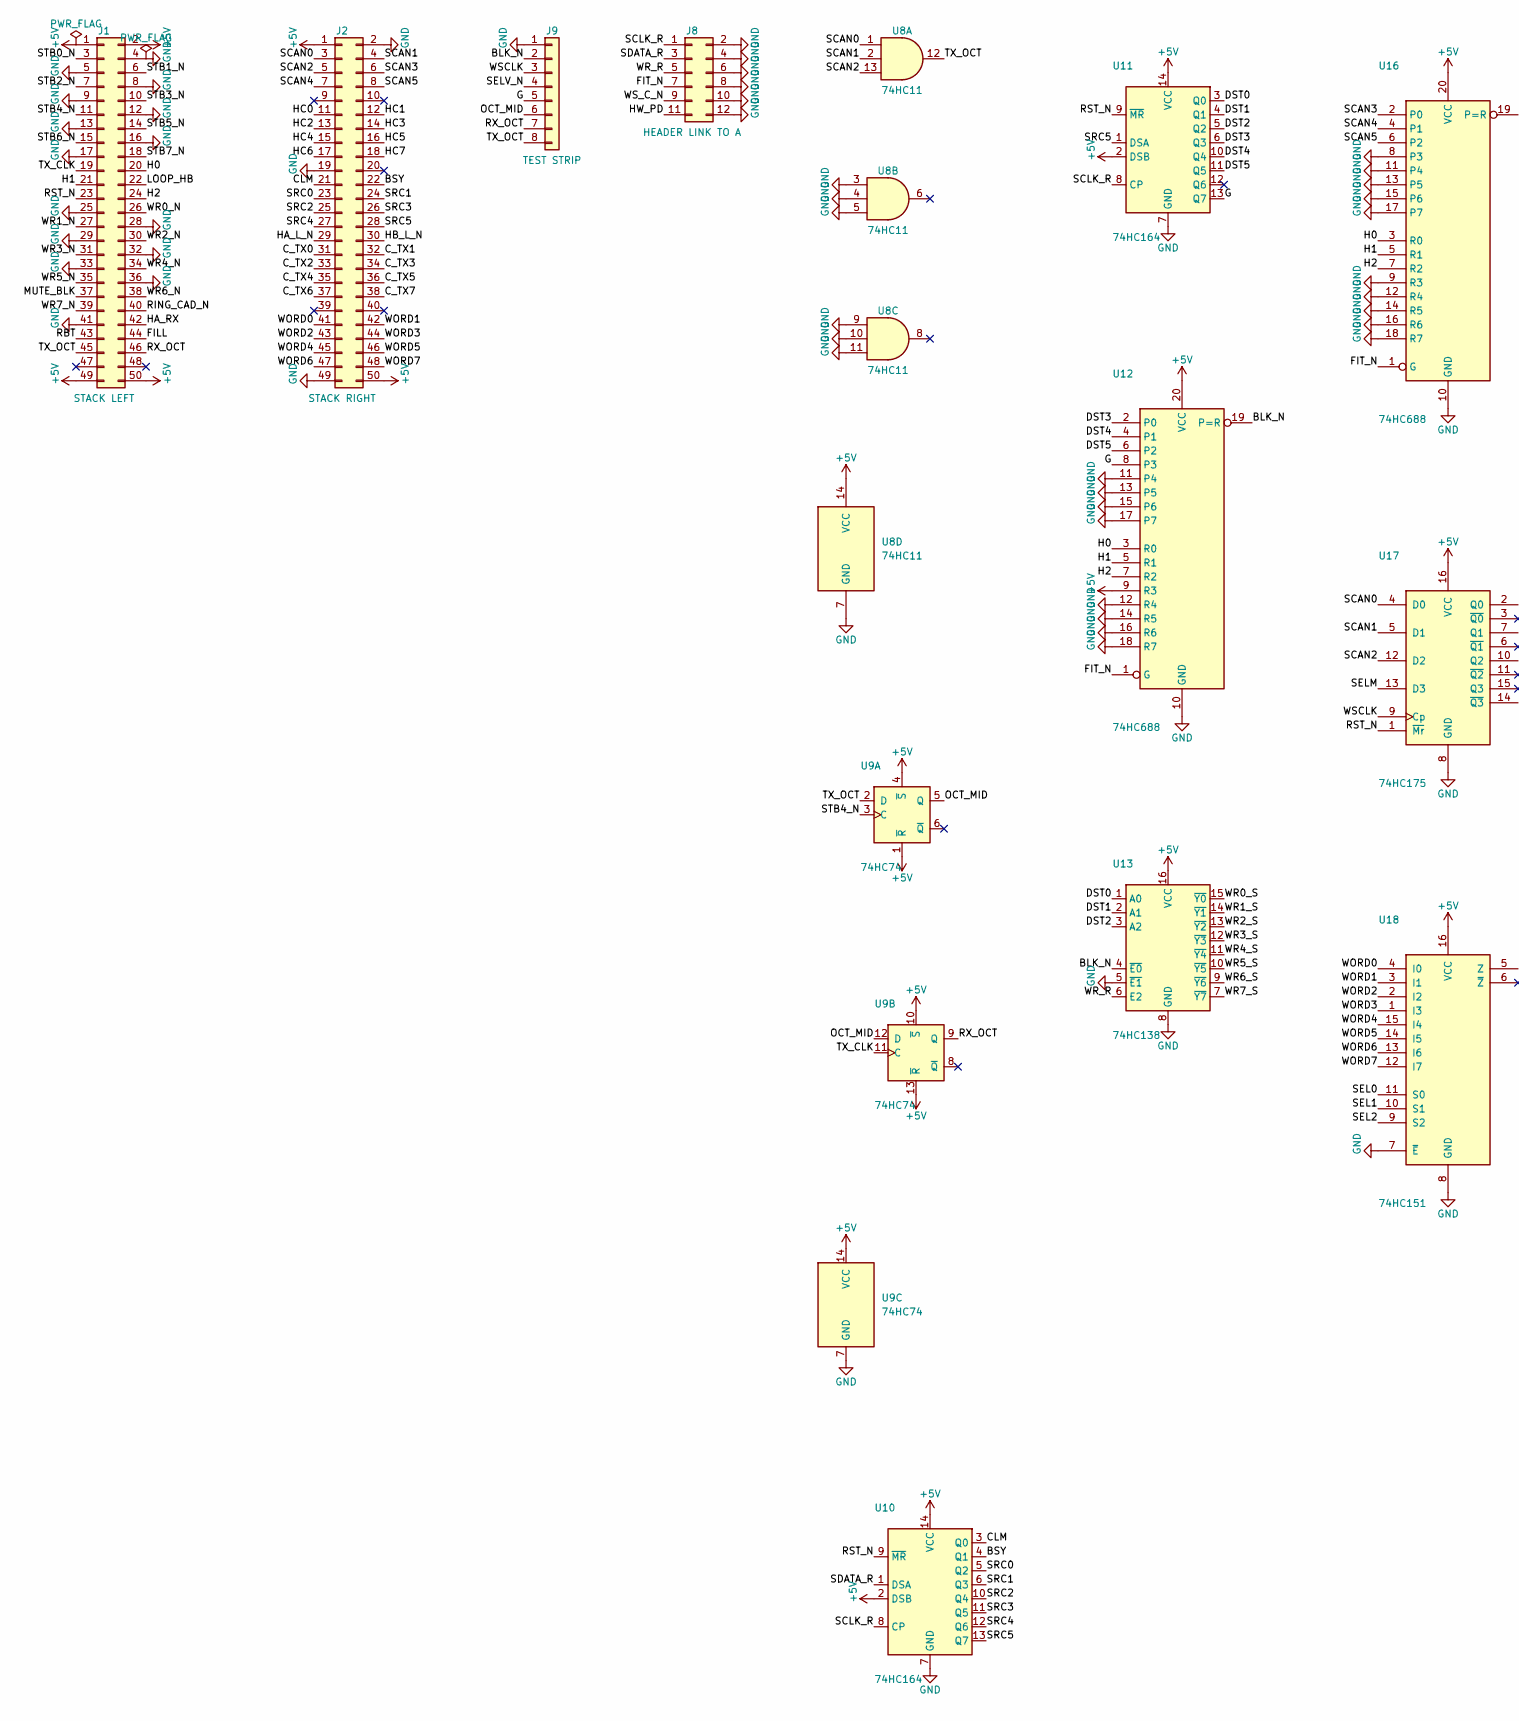
[picture p12: schematic blkhdr_logic_RevA.kicad_sch, Block header B, the logic board -- on A, under the port car…, part in row 1, column 1]

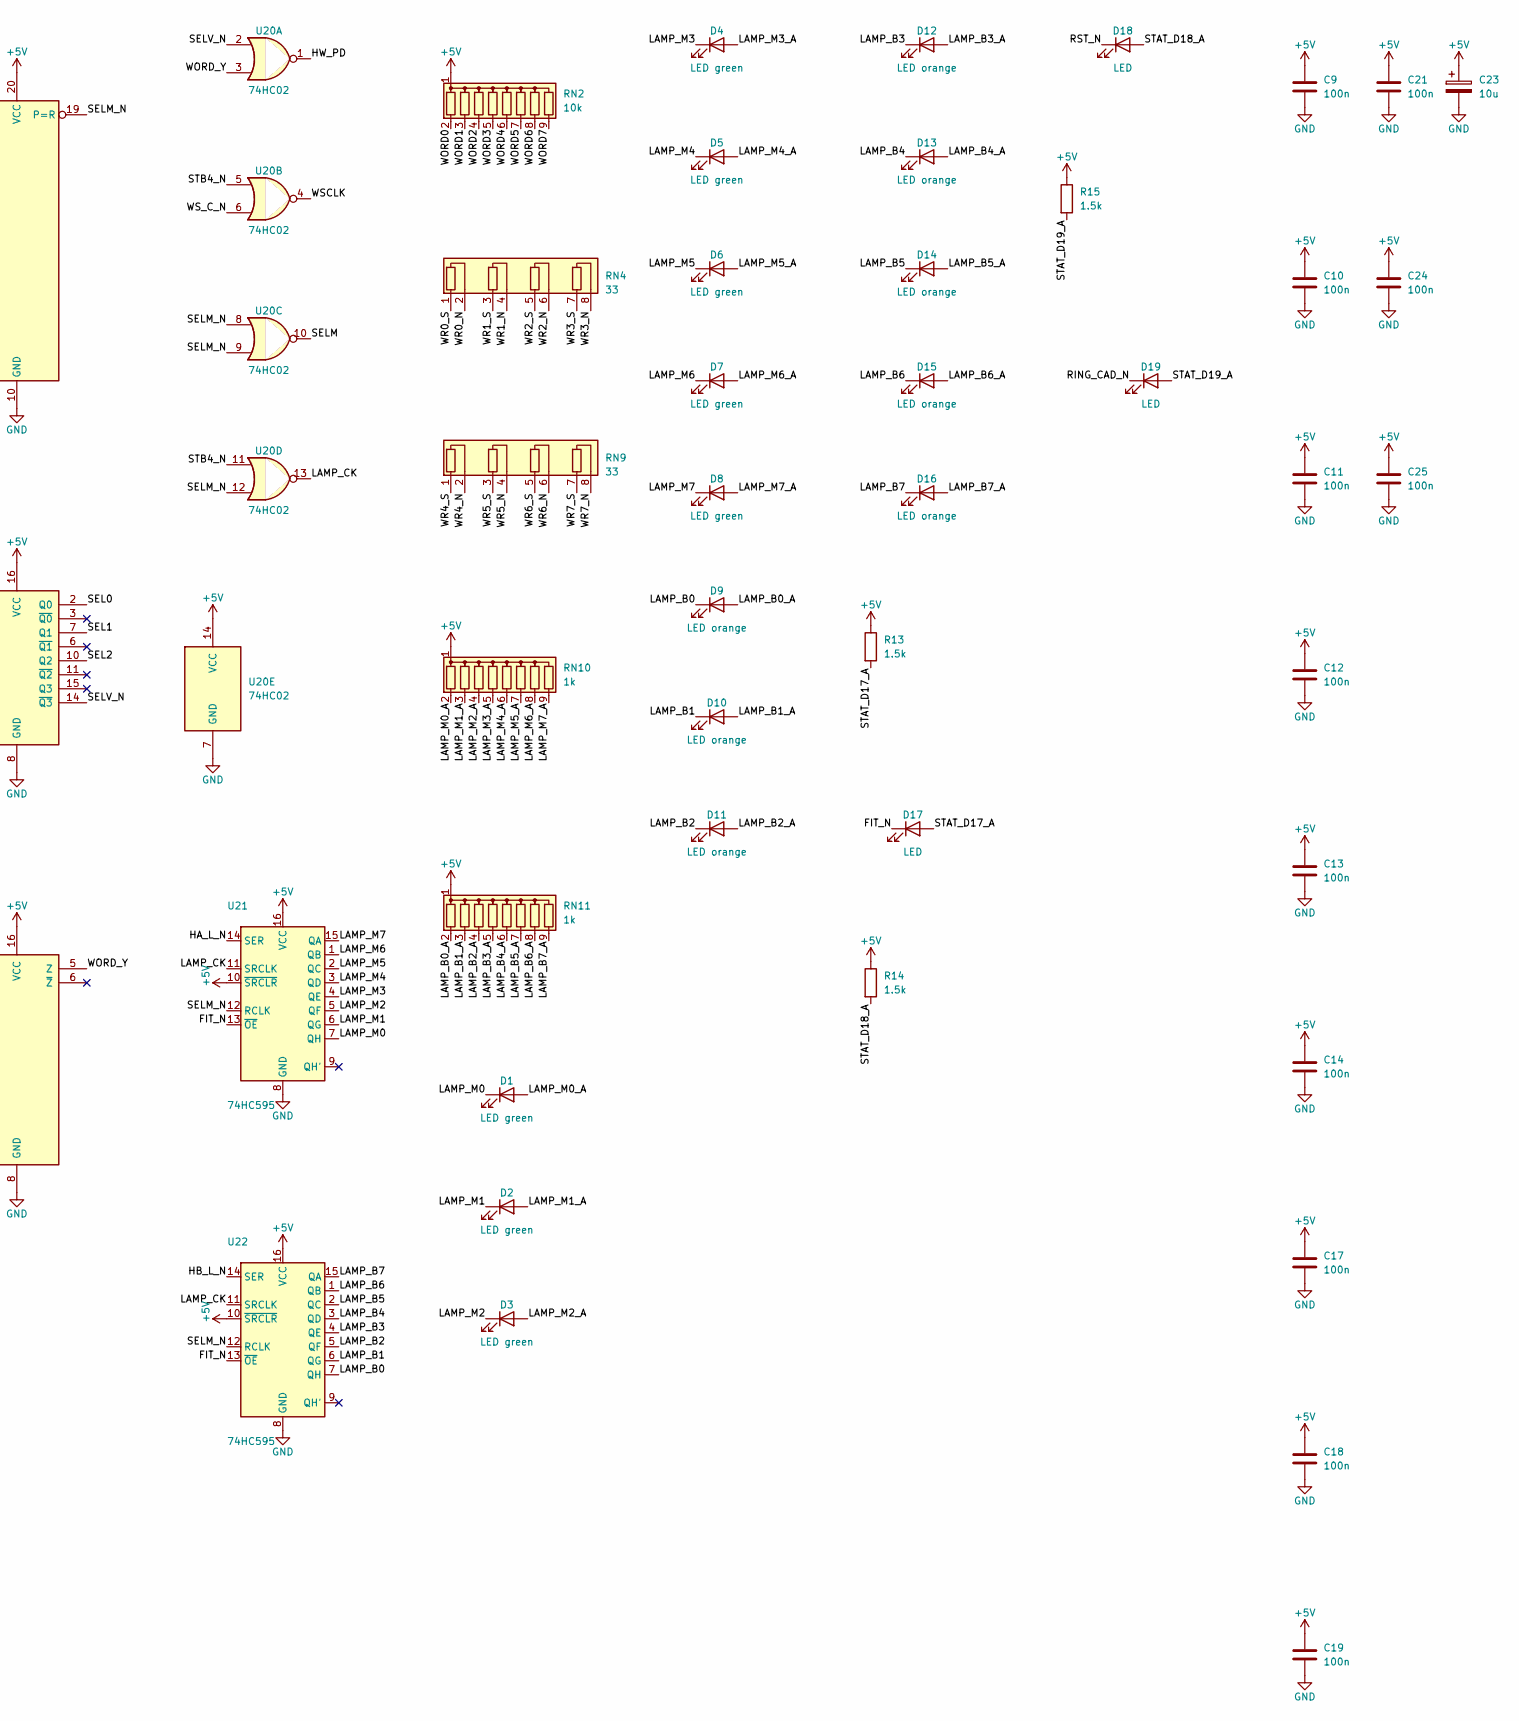
[picture p13: schematic blkhdr_logic_RevA.kicad_sch, Block header B, the logic board -- on A, under the port car…, part in row 1, column 2]

Parts:
C9, C10, C11, C12, C13, C14, C17, C18, C19, C21, C24, C25: 100n; C_Disc_D3.0mm_W1.6mm_P2.50mm
C23: 10u; CP_Radial_D4.0mm_P1.50mm
D1, D2, D3, D4, D5, D6, D7, D8: LED green; LED_D3.0mm_Horizontal_Row
D9, D10, D11, D12, D13, D14, D15, D16: LED orange; LED_D3.0mm_Horizontal_Row
D17, D18, D19: LED; LED_D3.0mm
J1: STACK LEFT; Stack_2x25_P2.54mm_LongTail
J2: STACK RIGHT; Stack_2x25_P2.54mm_LongTail
J8: HEADER LINK TO A; PinHeader_2x06_P2.54mm_Vertical
J9: TEST STRIP; PinHeader_1x08_P2.54mm_Horizontal
R13, R14, R15: 1.5k; R_Axial_DIN0207_L6.3mm_D2.5mm_P2.54mm_Vertical
RN2: 10k; R_Array_SIP9
RN4, RN9: 33; R_Array_SIP8
RN10, RN11: 1k; R_Array_SIP9
U8: 74HC11; DIP-14_W7.62mm
U9: 74HC74; DIP-14_W7.62mm
U10, U11: 74HC164; DIP-14_W7.62mm
U12, U16: 74HC688; DIP-20_W7.62mm
U13: 74HC138; DIP-16_W7.62mm
U17: 74HC175; DIP-16_W7.62mm
U18: 74HC151; DIP-16_W7.62mm
U20: 74HC02; DIP-14_W7.62mm
U21, U22: 74HC595; DIP-16_W7.62mm

Connections:
+5V: C9.1, C10.1, C11.1, C12.1, C13.1, C14.1, C17.1, C18.1, C19.1, C21.1, C23.1, C24.1, C25.1, J1.1, J1.2, J1.49, J1.50, J2.1, J2.50, R13.1, R14.1, R15.1, RN2.1 (common), RN10.1 (common), RN11.1 (common), U8.14 (VCC), U9.1 (~R), U9.4 (~S), U9.10 (~S), U9.13 (~R), U9.14 (VCC), U10.2 (DSB), U10.14 (VCC), U11.2 (DSB), U11.14 (VCC), U12.9 (R3), U12.20 (VCC), U13.16 (VCC), U16.20 (VCC), U17.16 (VCC), U18.16 (VCC), U20.14 (VCC), U21.10 (~SRCLR), U21.16 (VCC), U22.10 (~SRCLR), U22.16 (VCC)
/BLK_N: J9.2, U12.19 (P=R), U13.4 (~E0)
/BSY: J2.22, U10.4 (Q1)
/CLM: J2.21, U10.3 (Q0)
/C_TX0: J2.31
/C_TX1: J2.32
/C_TX2: J2.33
/C_TX3: J2.34
/C_TX4: J2.35
/C_TX5: J2.36
/C_TX6: J2.37
/C_TX7: J2.38
/DST0: U11.3 (Q0), U13.1 (A0)
/DST1: U11.4 (Q1), U13.2 (A1)
/DST2: U11.5 (Q2), U13.3 (A2)
/DST3: U11.6 (Q3), U12.2 (P0)
/DST4: U11.10 (Q4), U12.4 (P1)
/DST5: U11.11 (Q5), U12.6 (P2)
/FILL: J1.44
/FIT_N: D17.1 (K), J8.7, U12.1 (G), U16.1 (G), U21.13 (~OE), U22.13 (~OE)
/G: J9.5, U11.13 (Q7), U12.8 (P3)
/H0: J1.20, U12.3 (R0), U16.3 (R0)
/H1: J1.21, U12.5 (R1), U16.5 (R1)
/H2: J1.24, U12.7 (R2), U16.7 (R2)
/HA_L_N: J2.29, U21.14 (SER)
/HA_RX: J1.42
/HB_L_N: J2.30, U22.14 (SER)
/HC0: J2.11
/HC1: J2.12
/HC2: J2.13
/HC3: J2.14
/HC4: J2.15
/HC5: J2.16
/HC6: J2.17
/HC7: J2.18
/HW_PD: J8.11, U20.1
/LAMP_B0: D9.1 (K), U22.7 (QH)
/LAMP_B0_A: D9.2 (A), RN11.2 (R1)
/LAMP_B1: D10.1 (K), U22.6 (QG)
/LAMP_B1_A: D10.2 (A), RN11.3 (R2)
/LAMP_B2: D11.1 (K), U22.5 (QF)
/LAMP_B2_A: D11.2 (A), RN11.4 (R3)
/LAMP_B3: D12.1 (K), U22.4 (QE)
/LAMP_B3_A: D12.2 (A), RN11.5 (R4)
/LAMP_B4: D13.1 (K), U22.3 (QD)
/LAMP_B4_A: D13.2 (A), RN11.6 (R5)
/LAMP_B5: D14.1 (K), U22.2 (QC)
/LAMP_B5_A: D14.2 (A), RN11.7 (R6)
/LAMP_B6: D15.1 (K), U22.1 (QB)
/LAMP_B6_A: D15.2 (A), RN11.8 (R7)
/LAMP_B7: D16.1 (K), U22.15 (QA)
/LAMP_B7_A: D16.2 (A), RN11.9 (R8)
/LAMP_CK: U20.13, U21.11 (SRCLK), U22.11 (SRCLK)
/LAMP_M0: D1.1 (K), U21.7 (QH)
/LAMP_M0_A: D1.2 (A), RN10.2 (R1)
/LAMP_M1: D2.1 (K), U21.6 (QG)
/LAMP_M1_A: D2.2 (A), RN10.3 (R2)
/LAMP_M2: D3.1 (K), U21.5 (QF)
/LAMP_M2_A: D3.2 (A), RN10.4 (R3)
/LAMP_M3: D4.1 (K), U21.4 (QE)
/LAMP_M3_A: D4.2 (A), RN10.5 (R4)
/LAMP_M4: D5.1 (K), U21.3 (QD)
/LAMP_M4_A: D5.2 (A), RN10.6 (R5)
/LAMP_M5: D6.1 (K), U21.2 (QC)
/LAMP_M5_A: D6.2 (A), RN10.7 (R6)
/LAMP_M6: D7.1 (K), U21.1 (QB)
/LAMP_M6_A: D7.2 (A), RN10.8 (R7)
/LAMP_M7: D8.1 (K), U21.15 (QA)
/LAMP_M7_A: D8.2 (A), RN10.9 (R8)
/LOOP_HB: J1.22
/MUTE_BLK: J1.37
/OCT_MID: J9.6, U9.5 (Q), U9.12 (D)
/RBT: J1.43
/RING_CAD_N: D19.1 (K), J1.40
/RST_N: D18.1 (K), J1.23, U10.9 (~MR), U11.9 (~MR), U17.1 (~Mr)
/RX_OCT: J1.46, J9.7, U9.9 (Q)
/SCAN0: J2.3, U8.1, U17.4 (D0)
/SCAN1: J2.4, U8.2, U17.5 (D1)
/SCAN2: J2.5, U8.13, U17.12 (D2)
/SCAN3: J2.6, U16.2 (P0)
/SCAN4: J2.7, U16.4 (P1)
/SCAN5: J2.8, U16.6 (P2)
/SCLK_R: J8.1, U10.8 (CP), U11.8 (CP)
/SDATA_R: J8.3, U10.1 (DSA)
/SEL0: U17.2 (Q0), U18.11 (S0)
/SEL1: U17.7 (Q1), U18.10 (S1)
/SEL2: U17.10 (Q2), U18.9 (S2)
/SELM: U17.13 (D3), U20.10
/SELM_N: U16.19 (P=R), U20.8, U20.9, U20.12, U21.12 (RCLK), U22.12 (RCLK)
/SELV_N: J9.4, U17.14 (~Q3), U20.2
/SRC0: J2.23, U10.5 (Q2)
/SRC1: J2.24, U10.6 (Q3)
/SRC2: J2.25, U10.10 (Q4)
/SRC3: J2.26, U10.11 (Q5)
/SRC4: J2.27, U10.12 (Q6)
/SRC5: J2.28, U10.13 (Q7), U11.1 (DSA)
/STAT_D17_A: D17.2 (A), R13.2
/STAT_D18_A: D18.2 (A), R14.2
/STAT_D19_A: D19.2 (A), R15.2
/STB0_N: J1.3
/STB1_N: J1.6
/STB2_N: J1.7
/STB3_N: J1.10
/STB4_N: J1.11, U9.3 (C), U20.5, U20.11
/STB5_N: J1.14
/STB6_N: J1.15
/STB7_N: J1.18
/TX_CLK: J1.19, U9.11 (C)
/TX_OCT: J1.45, J9.8, U8.12, U9.2 (D)
/WORD0: J2.41, RN2.2 (R1), U18.4 (I0)
/WORD1: J2.42, RN2.3 (R2), U18.3 (I1)
/WORD2: J2.43, RN2.4 (R3), U18.2 (I2)
/WORD3: J2.44, RN2.5 (R4), U18.1 (I3)
/WORD4: J2.45, RN2.6 (R5), U18.15 (I4)
/WORD5: J2.46, RN2.7 (R6), U18.14 (I5)
/WORD6: J2.47, RN2.8 (R7), U18.13 (I6)
/WORD7: J2.48, RN2.9 (R8), U18.12 (I7)
/WORD_Y: U18.5 (Z), U20.3
/WR0_N: J1.26, RN4.2 (R1.2)
/WR0_S: RN4.1 (R1.1), U13.15 (~Y0)
/WR1_N: J1.27, RN4.4 (R2.2)
/WR1_S: RN4.3 (R2.1), U13.14 (~Y1)
/WR2_N: J1.30, RN4.6 (R3.2)
/WR2_S: RN4.5 (R3.1), U13.13 (~Y2)
/WR3_N: J1.31, RN4.8 (R4.2)
/WR3_S: RN4.7 (R4.1), U13.12 (~Y3)
/WR4_N: J1.34, RN9.2 (R1.2)
/WR4_S: RN9.1 (R1.1), U13.11 (~Y4)
/WR5_N: J1.35, RN9.4 (R2.2)
/WR5_S: RN9.3 (R2.1), U13.10 (~Y5)
/WR6_N: J1.38, RN9.6 (R3.2)
/WR6_S: RN9.5 (R3.1), U13.9 (~Y6)
/WR7_N: J1.39, RN9.8 (R4.2)
/WR7_S: RN9.7 (R4.1), U13.7 (~Y7)
/WR_R: J8.5, U13.6 (E2)
/WSCLK: J9.3, U17.9 (Cp), U20.4
/WS_C_N: J8.9, U20.6
GND: C9.2, C10.2, C11.2, C12.2, C13.2, C14.2, C17.2, C18.2, C19.2, C21.2, C23.2, C24.2, C25.2, J1.4, J1.5, J1.8, J1.9, J1.12, J1.13, J1.16, J1.17, J1.25, J1.28, J1.29, J1.32, J1.33, J1.36, J1.41, J2.2, J2.19, J2.49, J8.2, J8.4, J8.6, J8.8, J8.10, J8.12, J9.1, U8.3, U8.4, U8.5, U8.7 (GND), U8.9, U8.10, U8.11, U9.7 (GND), U10.7 (GND), U11.7 (GND), U12.10 (GND), U12.11 (P4), U12.12 (R4), U12.13 (P5), U12.14 (R5), U12.15 (P6), U12.16 (R6), U12.17 (P7), U12.18 (R7), U13.5 (~E1), U13.8 (GND), U16.8 (P3), U16.9 (R3), U16.10 (GND), U16.11 (P4), U16.12 (R4), U16.13 (P5), U16.14 (R5), U16.15 (P6), U16.16 (R6), U16.17 (P7), U16.18 (R7), U17.8 (GND), U18.7 (~E), U18.8 (GND), U20.7 (GND), U21.8 (GND), U22.8 (GND)

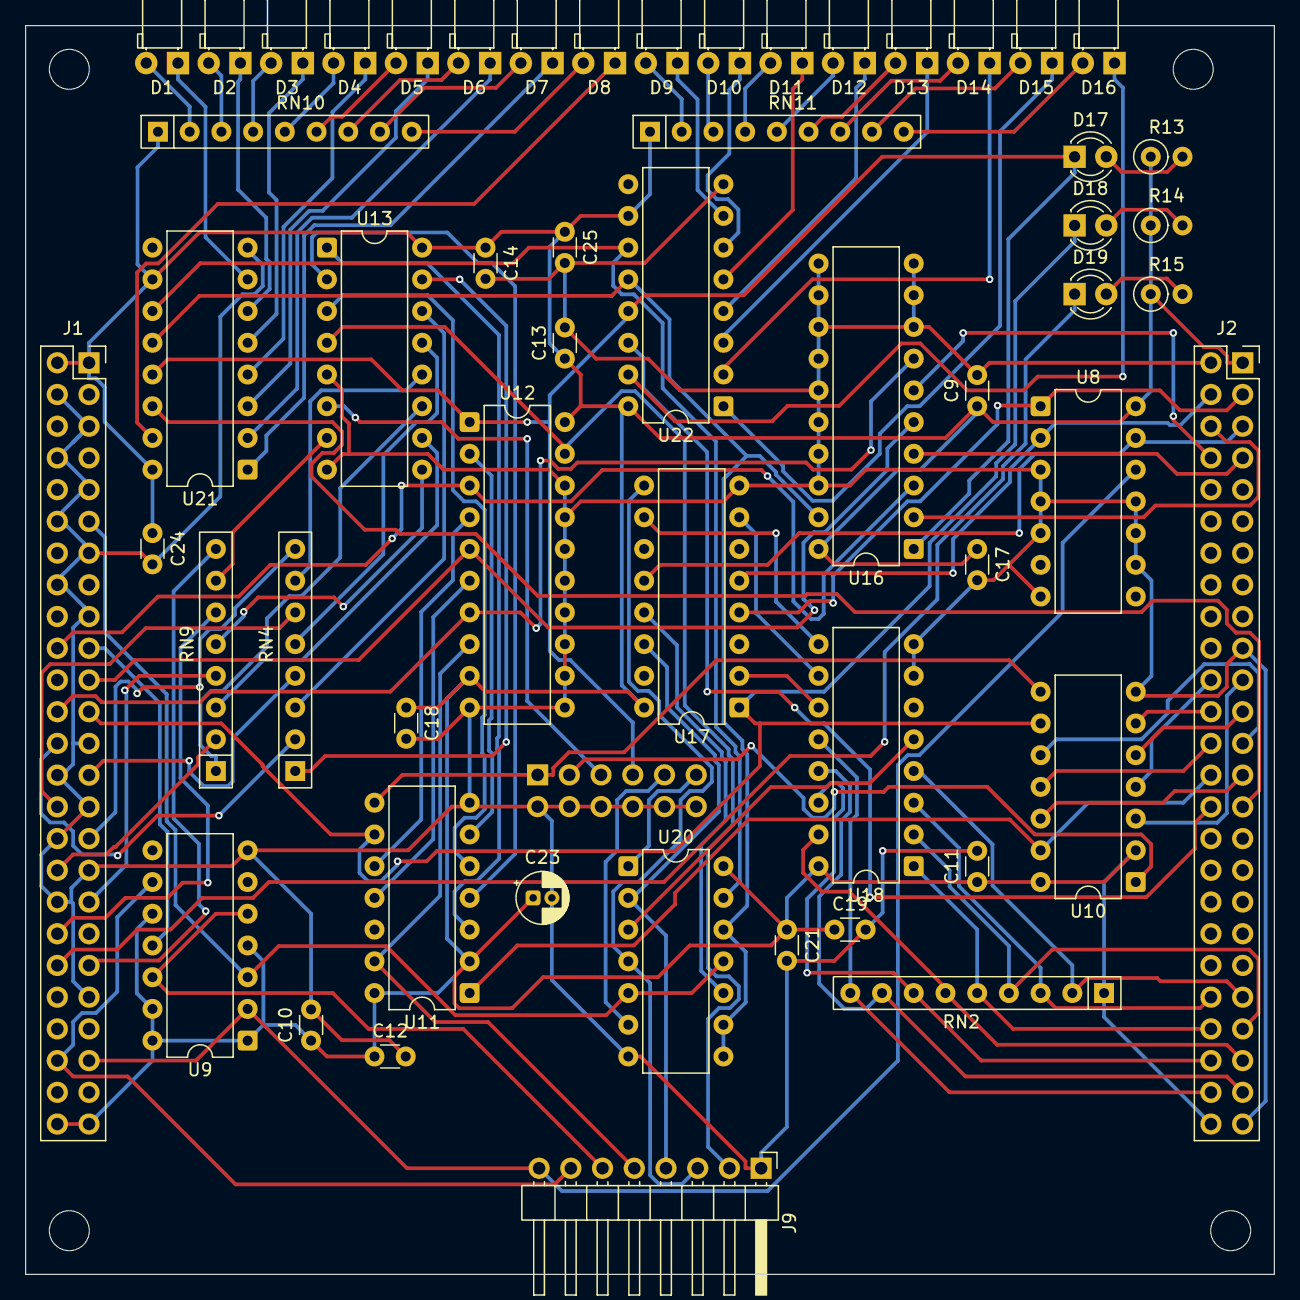
[picture p14: board blkhdr_logic_RevA.kicad_pcb from above]

Board: 2 copper layers, 100.0 x 100.0 mm, 60 parts (1 on the bottom side), 110 nets.

Other parts of the board:
H1, H2, H3, H4: M3; MountingHole_3.2mm_M3
