retrac0/retelex/pcb/hookbusy/interface_card/interface_card.kicad_pcb

## KiCad design pcb/hookbusy/interface_card/interface_card.kicad_pcb (2026-09-25)

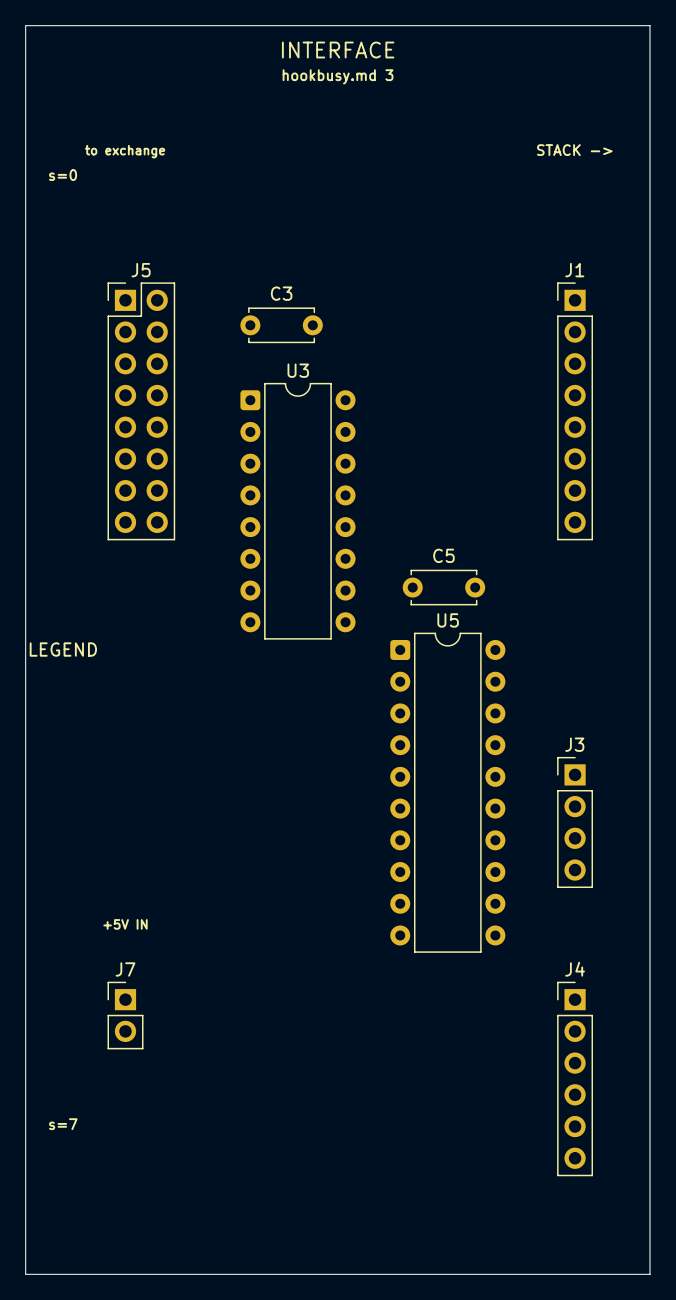
[picture p15: board interface_card.kicad_pcb from above]

Board: 2 copper layers, 50.0 x 100.0 mm, 9 parts (0 on the bottom side), 26 nets, no tracks yet.

Parts:
C3, C5: 100n; C_Disc_D5.0mm_W2.5mm_P5.00mm
J1: LE; PinHeader_1x08_P2.54mm_Vertical
J3: PWR; PinHeader_1x04_P2.54mm_Vertical
J4: control; PinHeader_1x06_P2.54mm_Vertical
J5: CABLE_A_TAP; PinHeader_2x08_P2.54mm_Vertical
J7: PWR_IN; PinHeader_1x02_P2.54mm_Vertical
U3: 74HC138; DIP-16_W7.62mm
U5: 74HC244; DIP-20_W7.62mm

Connections:
+5V: C3.1, C5.1, J3.1, J3.3, J7.1, U3.16, U5.20
CBL_HA_N: J5.7, U5.8
CBL_HB_N: J5.8, U5.11
CBL_HCLK: J5.9, U3.4
CBL_SCAN0: J5.1, U5.2
CBL_SCAN1: J5.2, U5.4
CBL_SCAN2: J5.3, U5.6
CBL_SCAN3: J5.4, U3.1
CBL_SCAN4: J5.5, U3.2
CBL_SCAN5: J5.6, U3.3
CBL_SLOTQ1: J5.10, U3.5
CBL_SLOTQ2: J5.11, U3.6
GND: C3.2, C5.2, J3.2, J3.4, J5.12, J5.13, J5.14, J5.15, J5.16, J7.2, U3.8, U5.1, U5.10, U5.13, U5.15, U5.17, U5.19
HA_N: J4.4, U5.12
HB_N: J4.5, U5.9
LE0_N: J1.1, U3.15
LE1_N: J1.2, U3.14
LE2_N: J1.3, U3.13
LE3_N: J1.4, U3.12
LE4_N: J1.5, U3.11
LE5_N: J1.6, U3.10
LE6_N: J1.7, U3.9
LE7_N: J1.8, U3.7
SCAN0: J4.1, U5.18
SCAN1: J4.2, U5.16
SCAN2: J4.3, U5.14
