retrac0/retelex/pcb/hookbusy/lamp_card/lamp_card.kicad_pcb

## KiCad design pcb/hookbusy/lamp_card/lamp_card.kicad_pcb (2026-09-25)

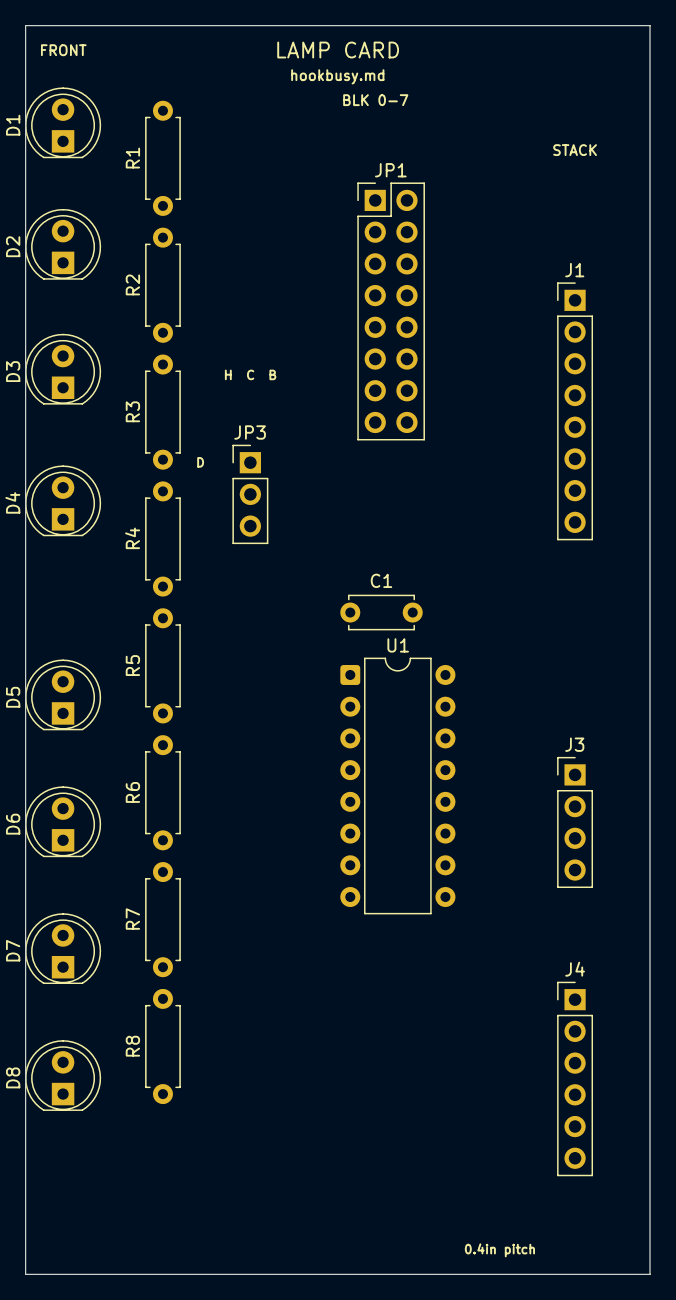
[picture p16: board lamp_card.kicad_pcb from above]

Board: 2 copper layers, 50.0 x 100.0 mm, 23 parts (0 on the bottom side), 33 nets, no tracks yet.

Parts:
C1: 100n; C_Disc_D5.0mm_W2.5mm_P5.00mm
D1: LED_s0; LED_D5.0mm
D2: LED_s1; LED_D5.0mm
D3: LED_s2; LED_D5.0mm
D4: LED_s3; LED_D5.0mm
D5: LED_s4; LED_D5.0mm
D6: LED_s5; LED_D5.0mm
D7: LED_s6; LED_D5.0mm
D8: LED_s7; LED_D5.0mm
J1: LE; PinHeader_1x08_P2.54mm_Vertical
J3: PWR; PinHeader_1x04_P2.54mm_Vertical
J4: control; PinHeader_1x06_P2.54mm_Vertical
JP1: BLK; PinHeader_2x08_P2.54mm_Vertical
JP3: MODE; PinHeader_1x03_P2.54mm_Vertical
R1, R2, R3, R4, R5, R6, R7, R8: 1k5; R_Axial_DIN0207_L6.3mm_D2.5mm_P7.62mm_Horizontal
U1: 74HC259; DIP-16_W7.62mm

Connections:
+5V: C1.1, D1.2, D2.2, D3.2, D4.2, D5.2, D6.2, D7.2, D8.2, J3.1, J3.3, U1.15, U1.16
D: JP3.2, U1.13
GND: C1.2, J3.2, J3.4, U1.8
HA_N: J4.4, JP3.1
HB_N: J4.5, JP3.3
LE0_N: J1.1, JP1.1
LE1_N: J1.2, JP1.3
LE2_N: J1.3, JP1.5
LE3_N: J1.4, JP1.7
LE4_N: J1.5, JP1.9
LE5_N: J1.6, JP1.11
LE6_N: J1.7, JP1.13
LE7_N: J1.8, JP1.15
LED0: D1.1, R1.2
LED1: D2.1, R2.2
LED2: D3.1, R3.2
LED3: D4.1, R4.2
LED4: D5.1, R5.2
LED5: D6.1, R6.2
LED6: D7.1, R7.2
LED7: D8.1, R8.2
LE_N: JP1.2, JP1.4, JP1.6, JP1.8, JP1.10, JP1.12, JP1.14, JP1.16, U1.14
Q0: R1.1, U1.4
Q1: R2.1, U1.5
Q2: R3.1, U1.6
Q3: R4.1, U1.7
Q4: R5.1, U1.9
Q5: R6.1, U1.10
Q6: R7.1, U1.11
Q7: R8.1, U1.12
SCAN0: J4.1, U1.1
SCAN1: J4.2, U1.2
SCAN2: J4.3, U1.3
