retrac0/retelex/(commit log)

2026-09-16 Simulation for discrete CVSD voice carrier over twisted pair
    Bit-level model of a 4-channel 32 kbps CVSD carrier with a 10-bit start/stop
    frame, differential Manchester line coding, and two independent one-way
    directions.
    - cvsd.py codec with integrator step proportional to the actual bit interval,
    so clock jitter and gapped clocking emerge from the model
    - link.py framing, bit-slip framer, acquisition/LOF counters, bit noiser,
    signalling RC+Schmitt integrator
    - phy.py differential Manchester and AMI, cable/noise chain, oversampling DPLL
    - phy_fast.c C hot loops (slicer, DPLL, analog PLL, monostable), verified
    bit-identical to the Python reference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
    [compare.py, run.py]
2026-09-16 Add system spec, channel card and line transmitter designs
    Turns the simulated architecture into buildable hardware documents.
    docs/spec.md frame, rates, line code, framer policy, signalling,
    failure behaviour, and the measured performance the
    design rests on
    docs/channel-card.md E&M 4-wire card with semi-analog CVSD: LM13700 OTA
    providing both step-size control and polarity steering
    docs/line-transmitter.md frame generator, biphase encoder, output stage
    tolerance.py answers the open question behind choosing semi-analog CVSD over a
    codec chip: how closely two independently built cards must match. Mea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
2026-09-16 Lock in oscillator, E&M type and slew rate
    Oscillator: 10.24 MHz, divided by 16 to the 640 kHz half-bit clock. Chosen on
    availability -- it is a standard telecom value where 1.28 / 2.56 / 5.12 MHz are
    not, and none of the ubiquitous crystal values (1.8432, 2.048, 3.579545,
    3.6864, 4.096, 4.9152) divide to 640 kHz at all. Only the oscillator and the
    divide-by-16 run fast; every other node is at or below 640 kHz.
    E&M Type V, laid out type-agnostic. Both leads assert by grounding, so the
    circuit is symmetric and one card works at both ends. Opto-isolating both leads
    means Type I differs only by a current-limit resistor and whether battery
    reaches the connector, so it is jumperable; four connec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
    [run.py]
2026-09-16 Measure the squelch requirement; correct the stated reason
    The spec claimed squelch was needed because both line codes fail as a cliff.
    That is not the mechanism. squelch.py measures what actually comes out.
    A truly dead pair is harmless: no transitions means no recovered clock, so the
    integrator just decays. The dangerous case is a dead pair with a LITTLE noise on
    it, which is what a disconnected pair picking up induction looks like -- and the
    worst case is the quietest noise:
    noise sd=0.05 +24.1 dB rms, +47.7 dB peak versus normal speech
    noise sd=0.2 +14.7 dB rms, +30.9 dB peak
    noise sd=1.0 +20.8 dB rms, +41.0 dB peak
    The mechanism is the syllabic compander. At low noise t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
2026-09-16 Switch to 3 channels; add validation suite and FXO/FXS card
    Frame is now 8 bits: [A1][C1][A2][C2][A3][C3][S][T] at 32 kHz, 256 kbps line,
    512 kbaud, 8.192 MHz master.
    Eight is not arbitrary. 2+2N is a power of two only at N = 1, 3 and 7, and only
    then does crystal-to-frame divide by 2^n. At N=3 that is /256, which collapses
    the transmitter's entire timing chain -- half-bit clock, line bit clock, frame
    counter and frame clock -- into taps on a single 74HC4040, removing the divider,
    the frame counter and the sync-clear gate. On the receiver it removes the
    mod-N decode and, less obviously, the 74HC259 enable gating: with 6 payload bits
    in an 8-deep latch the framing bits land in the two spare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
2026-09-18 Snapshot: MF8 8-bit superframe carrier, and the work behind it
    Commits everything currently untracked so the following prune is
    recoverable. Nothing here is removed yet.
    New design and its validation:
    docs/mf8-spec.md 8-bit superframe carrier: F + S + 6 x 64 kbps at a
    64 kHz frame rate, superframe carrying signalling
    AND octet alignment, so a slot is a true DS0
    mf8.py, mf8.log reference model and frame-layer battery
    mf8_line.py end to end: six talkers, real CVSD, real waveform,
    both line codes
    Supporting analysis:
    docs/mf-vs-16bit.md review the design came out of
    docs/line-codes.md nine line codes; dif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
2026-09-18 Remove the 16-bit 7-channel A+C system; MF8 stands alone
    The 8-bit superframe carrier supersedes the interleaved-signalling
    family, so that design, its cards and its tooling are removed and the
    MF8 documents are made self-contained.
    Folded into docs/mf8-spec.md before deleting their sources, so the spec
    no longer inherits anything:
    9.1 oscillator and clock chain
    9.3 output stage and line interface
    9.5 input filter
    9.6 carrier detect
    9.7 rate plug
    12 channel cards -- CVSD engine values, data card, empty slot
    Removed: spec.md, seven-channel.md, family.md, framing-review.md,
    draft-protocols.md, strapping-feasibility.md, mf-vs-16bit.md, the card
    and PHY docs, and the tools t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
    [compare.py, run.py]
2026-09-18 Add mf8_render.py: 15 s of every channel, over the link, for listening
    Six talkers, 15 s each, through the whole chain in both line codes under
    nine conditions -- clean, Gaussian sd 0.40-0.70, impulse 10 and 100/s,
    attenuation 0.25 and 0.12 -- written to out/ (not committed) as 8 kHz
    wavs. Each render is the full duration as the link DELIVERS it: muted
    wherever the framer is not locked, so outages are heard in place.
    15 s at OS = 32 is 2.0 GB of float64, so the physical layer streams in
    1 s chunks. Three things had to be right for that to be honest, and the
    first 15 s run got two of them wrong:
    * Encode the whole line once. dm_encode carries a running level and
    ami_encode a runnin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
2026-09-18 Measure the impulse falloff curve; keep the guard at 3,5; fix the render
    impulse_sweep.py: 23 impulse rates from 0.3 to 1000/s in both line
    codes, several independent 10 s runs per point, per-point standard
    errors, thresholds interpolated on the measured points. Link layer
    only, on mf8_render's verified chunked physical layer.
    link reaches diff Manchester AMI
    1 break/s 1.3 impulses/s 7.3
    10 breaks/s 13 77
    1% muted 18 95
    The curves are different shapes, not one displaced. Differential
    Manchester has no cliff: ~0.77 breaks per impulse, ~0.76 ms each, and
    outages add. AMI takes about a sixth of the breaks, then collapse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
    [impulse_sweep.csv]
2026-09-18 Move S to bit 4, guard to 0,4; add a guard counter; sweep every byte
    Two single-data-card holes were found that the battery missed: with S
    beside F, a skew of 7 reads C6 as F and the next F as the guard (0x7F,
    G.711 silence, in seat 6 held a wrong alignment forever), and a skew of 1
    reads S as F and C1 as the guard (64 bytes in seat 1 with every channel
    off-hook). Both are deterministic; no tracker can see them.
    S now sits half a frame from F, [F][C1][C2][C3][S][C4][C5][C6], so the
    only skew that maps a header bit onto a header position is 4, where the
    header reads itself and fails for every hook state. The slot rule
    becomes "no two data cards three apart". The guard moves to states 0
    an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
2026-09-18 Re-run the line battery, impulse sweep and renders on the S-at-bit-4 layout
    mf8_line.log: the clean-line and low-noise cells are unchanged to the last
    digit. The marginal cells moved because moving S changes the line bits
    under the same seeded noise: AMI at sd 0.6 now shows 4 LOF where the old
    run had 0, and the old layout with a second seed gives 4 too. The guard
    counter is not involved -- on the same received bits it trips 0 times in
    every cell and the frame counter alone gives identical counts. Spec 7.2
    re-tabulated; the "AMI never loses frame at sd 0.6" claim was one draw
    and now reads as which code fails first.
    impulse_sweep.log: differential Manchester's thresholds unchanged; AMI's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
    [impulse_sweep.csv]
2026-09-18 Add mf8-backplane.md: modules, slot interface, clock domains
    The exchange as a trunk card, six channel slots and a passive backplane,
    with every interface along the chain phone -> subscriber line -> channel
    -> backplane -> trunk TX -> pair -> trunk RX -> backplane -> channel ->
    subscriber line -> phone: inputs, outputs, clock domain and timing.
    Three clocks: the local crystal (T), the trunk-recovered clock (R) and
    each phone's upstream (P). Every bus signal belongs to one; a card's
    transmit half lives in T and its receive half in R; the domains meet only
    inside a line card, at two synchronizer crossings. Plesiochronous, not
    loop-timed: the slip that costs is measured -- one CVSD bit per 1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
2026-09-18 Add mf8-cards.md: subscriber line, FXS/FXO and data cards
    Three channel cards on the mf8-backplane.md slot interface.
    CVSD subscriber line card: the exchange end of subscriber-line.md. The
    9.4 receiver at the 64 kbps plug, the 1100 hook detector with its
    violation term, the 9.2 encoder on TX_CLK/TX_HB, 48 V on the phantom, and
    the exchange-side rule in bus signals: three 2:1 selections, FILL as the
    idle pattern, two synchronizer crossings, MUTE folded into the on-hook
    select. About 10 packages, no relay, no ringing, no high voltage.
    Analog FXS/FXO card: the 12.1 engine with a loop-start line circuit and a
    600 ohm hybrid, one board in two populations, from the earlier
    fxo-fxs-card.md. St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
2026-09-19 Adopt MIL-STD-188-113's CVSD law at 64 kbps; add cvsd_law.py; re-run the batteries
    mf8.BASE is now the DNVT's law carried to 64 kbps: 3-bit run-of-threes,
    5 ms syllabic, 1 ms integrator (were 6 and 3), and the standard's 16:1
    compression. 188-113 quotes that ratio between the steps at 30 % and 0 %
    run-of-threes; cvsd.py's companding_db is full scale, so 16:1 is 51:1,
    34.2 dB (was 30). SLEW unchanged.
    cvsd_law.py measures what the choice rests on. spec: the standard's own
    decoder patterns (Table F-1) calibrate the mapping and show the standard
    contradicts itself -- 5.5's 16:1 step ratio decodes the two patterns
    29.5 dB apart where Table F-1 wants 24 +-2; the card follows 5.5. laws:
    at 64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
2026-09-19 Add mf8-pico.md; gateway slot; re-measure the slip under the new CVSD law
    mf8-pico.md: a Raspberry Pi Pico on a small 74-series adapter as host
    gateway, monitor, trunk emulator, channel emulator, reference line
    terminal and subscriber emulator -- the reference model as an instrument
    for circuit-review.md's breadboard, and the card that puts MF8 channels
    on an Asterisk exchange as CVSD octets and A bits over USB. PIO state
    machines touch every edge, one per clock domain, so nothing is retimed
    and no slip is added; SN74LV165A capture registers are the level
    shifters, 74HCT595 outputs latch on the bus clock itself. At a 128 MHz
    system clock the PIO dividers for 64, 512 and 1024 kbps are exact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
2026-09-19 Add the subscriber line and the register, with subline.py
    subscriber-line.md: one phone on two pairs, raw 64 kbps CVSD in differential
    Manchester with no frame; hook and ring as two held bit patterns the codec
    cannot make (1100 and all zeros), detected by an RC and a comparator with a
    mandatory code-violation term so a dead pair reads on-hook; dial pulses as
    the on-hook pattern, DTMF in band; 48 V on the phantom.
    register.md: the dial pulses read into a digit store in 74HC, one register
    for every line, pulse correction and the dialling technique.
    subline.py / subline.log: the tool both documents are measured by -- CVSD
    against the held patterns, the hook and ring detectors over the line, d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
2026-09-19 Add circuit-review.md: four findings ahead of the breadboard
    Reading mf8-spec.md 9-12 and mf8-cards.md as a wiring list. The encoder's
    flip-flop does not toggle on either part the drawing names (use a 74HC112,
    J = K = EN); there is no Iabc drive in the documents, the one once sketched
    cannot hold I_min, and I_min alone must match to about +/-5 % (measured on
    the codec model) -- an op-amp and PNP with the ratio set by two resistors;
    "sample, then retrigger" is three same-edge reads and the strobe cannot be a
    gate on the transition pulse -- use both edges of the dead-time pulse, which
    moves the classifier network to 0.55 cell; and the three connections between
    the 5 V logic and the +/-12 V en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
2026-09-19 Add exch/: an exchange at MF8's level of technology (snapshot)
    A telephone exchange in 74HC that takes every MF8 channel card unchanged
    and is tied to other exchanges by MF8: the internal protocol is the slot
    interface, bits are switched and never decoded, the connection memory is a
    latch at each port on 8-slot 512 kbps highways, dialled octal digits are the
    address, features are lines with a class mark that the marker hunts, and
    nobody is in charge of a call once two latches are written. Documents for
    the protocol, the marker, the features and (as analysis) the network;
    exch.py is the model and exch.log its run.
    Snapshot of work in progress in another session: exch.py was being edited
    whe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
2026-09-19 Add the CircuitJS (Falstad) models of the CVSD engine (snapshot)
    falstad_cvsd.py writes CircuitJS circuits from subcircuit modules -- the
    64 kbps CVSD encoder and decoder of mf8-spec.md 12.1 with circuit-review.md
    2.4's Iabc drive and 4's logic connections, the clock chain, the
    differential Manchester encoder, the line, the 9.4 receiver on
    circuit-review.md 3's two-phase timing, the reconstruction filter -- with
    every value derived from mf8.params(64000), so the files follow the codec
    law. falstad/cvsd_engine.txt is the looped-back engine; falstad/sim.mjs
    records a run and `falstad_cvsd.py check` scores it against the model.
    Snapshot of work in progress in another session: the generator wa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
2026-09-19 circuit-review.md: bring sections 2 and 4 onto the MIL-STD-188-113 law
    The review was written against the earlier codec law (30 dB, tau_syl 6 ms,
    tau_int 3 ms, 120 uA); 1dd508e moved mf8.BASE to 34.2 dB (51:1), 5 ms,
    1 ms and 160 uA, and mf8-spec.md 12.1 now cites this review's Iabc drive
    with values the review did not have.
    2.1: slope resistor 31.9k; the wider ratio makes the two-resistor bias
    worse, not better -- 10 mV of 2.V_BE moves I_min 92 % on split rails and
    14 % grounded (was 56 % and 8.5 %), and the loaded syllabic node is 1.9 ms.
    2.2 and 2.3 re-measured. The harness reproduces the earlier tables, on
    the earlier law, to the digit, so it is the same measurement: designed law
    27.6/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
2026-09-19 falstad/: the whole voice path as Falstad circuits, in modules
    falstad_cvsd.py now builds the modules and three circuits — the CVSD
    engine, a differential Manchester link, and a line with noise and
    impulses through the receiver and its recovered clock — from the codec
    law and the line constants. `check` compares a Falstad run against
    cvsd.py and fast.mono_decode.
2026-09-19 MF8: x is the remote alarm, and the exchange's two channel-slot pins
    mf8-spec.md §3.5: the spare S-lane bit x is decided as the remote alarm
    on every link — held at 1 while a receiver is not locked, read as the
    alarm after 32 ms — and between exchanges it carries SS0's messages as
    well, which never hold it that long.
    mf8-backplane.md §8: of the three pins the channel slot reserves, the
    exchange uses a12 for the port's word and a13 for /ANS; a14 stays spare.
    A card only ever pulls them to ground, so it works unchanged in a shelf
    that leaves them unconnected.
2026-09-19 exch: add the fabric, the monitor and the minimum exchange
    exch-fabric.md: how the fabric is built, part by part — the bus, a
    block, a port's crosspoint and its supervision, the one timing hazard
    and its cure (strobes decoded from the slot count a quarter of a cell
    late), no re-timing flip-flop, and worst-case timing from `exch.py
    timing`.
    exch-monitor.md: the trunk monitor, the one part that reads a digit it
    was not sent. Its two rules — count only a seizure whose rise you saw,
    and let the origin abandon a call whose next break comes too soon — are
    measured at 0 false claims in 1 500 calls.
    mvp-ex.md: the minimum that makes calls, about 70 packages of exchange
    logic, what each absen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
2026-09-19 exch: what a card says about its port, and the SS0 alternative
    ex-extensions.md: test lines, and the rule that whatever sits behind a
    port says everything about it. One pin, /ANS, tells the port's gates
    whether it rings; one serial word tells the marker the rest — the
    class and its options, a trunk's direction, or the port it is nailed to.
    A plain line card says both with no part: its word pin tied to ground.
    Then nailed-up connections brought up by the scanner, ringdown, nailing
    hop by hop, hotlines to another exchange by a card that dials, and the
    traffic counters.
    ex-ss0.md: SS0, proposed and not adopted — the number as one message a
    link on the MF8 frame's spare S bit, forward only,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
2026-09-19 exch: the port map, the class in the word, four directions, the numbering
    The port map (exch-protocol.md §5). A trunk's channels sit on slots 1-3
    and 5-7, where they are on the MF8 wire, so one 3-bit number is a
    channel's C bit, its A bit's superframe state and its port. Slots 0 and
    4 are ports of their own: 00 idle, which a cleared latch listens to and
    which costs the reversed strobe wiring nothing to keep; 04 the operator;
    10 dial tone; 14 cannot-complete.
    The class leaves the pins for the card's word, and /ANS alone tells a
    port whether it rings. That frees the codes from the ringing, drops
    three commutators a block, and lets a plain line card say what it is
    with no part at all. Trunk d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
2026-09-19 exch.py: net and topo, the network call by call and shape by shape
    net: eight exchanges in milliseconds — the flood, the monitors, the
    claim, the hub resolvers, the registers, the channels and line busy —
    against smooth demand and against bursts of it, the same calls arriving
    together. It confirms exch-network.md §5's arithmetic to two decimal
    places, and finds that bursts leave every link and pool alone and fall
    entirely on the registers: three at a 48-line leaf carry them, two make
    one caller in a hundred wait 2 s for dial tone, one make it 13 s.
    topo: chains, stars, tandems with chains, trees, a split centre and
    rings, by Erlang arithmetic on any tree and then call by call. It sizes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
2026-09-19 exch: Topology.md, what shapes a network may take and how large
    The rules of shape: four neighbours, eight trunk groups and the lines
    they cost, a flood that must see a tree, sixty-four codes, and ten hops
    against the origin's guard. Then what every network pays — a flood of
    2.0 to 3.8 s by the code called, on every link, for every call that
    leaves — and what that costs each shape.
    Chains, stars, tandems with chains, trees and a split centre, each
    sized; the largest measured is 47 exchanges and 1 692 lines with a fifth
    of calls leaving, 35 and 1 260 with a third. Rings work with one link of
    each cycle strapped and fail without: unstrapped, a ring of six loses
    100 network calls in 1 000.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
2026-09-19 exch: the mainboard, and the three signals a ribbon cannot carry
    The bus of exch-fabric.md 2 as a physical thing: fifty-five signals, the
    two ribbons that carry them, and their pinouts.
    Almost all of it wants a common cable, where every tap sees the same
    conductors. Three signals a block do not: block h drives HC[h] and HA[h]
    and answers to BLK[h], and that is the whole of a block's identity.
    Working it out in logic would cost about six packages a block, 7% of the
    fabric, to buy back what the layout was giving away free. So the cable
    is common and the mainboard is position-wired, with a block's number
    three shunts in one silkscreened column.
    `exch.py mainboard` adds the clock's own fligh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
2026-09-19 exrtl: the exchange in Verilog -- fabric, mainboard, supervision
    A register-transfer model of exch/docs, built the way the 74HC design is
    built so the two can be read against each other: a '151 is mux8, a '273
    is the port's addr register, and the module boundaries are connectors.
    exch_top's edge is the 64 channel-slot pin groups and the two cables, so
    cards are instantiated beside it and never inside it.
    One clock, the clock card's own 4.096 MHz: eight master ticks to a cell,
    eight cells to a frame. SLOTQ still sits a quarter cell behind SLOT
    because the hardware has it, not because the model needs it -- RTL does
    not glitch, so this cannot reproduce exch-fabric.md 3.2's hazard.
    Capture at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
    [block.v, clock_card.v, exch_top.v, line_card.v, mainboard.v, mux8.v, mvp_site.v, phone.v]
2026-09-20 exrtl: MF8 trunks, common control, the serial bus, and Verilator
    Four pieces of work, and one testbench not yet green.
    MF8 TRUNKS AND A LINK BETWEEN TWO EXCHANGES. mf8_encoder (differential
    Manchester, the JK's two HB edges a cell), mf8_decoder (the 9.4
    classifier: times gaps, no PLL, nothing to lose), mf8_framer (F =
    11111110, the guard at states 0 and 4, 32 to lock, two +2/-1 trip-12
    counters) and mf8_trunk_card. `make trunk` runs two exchanges tied by
    one MF8 pair each way: both framers acquire in 38 frames, where
    mf8-spec.md 4.1 measures 37-86. Speech is bit-exact each way on two
    channels at once, the link cut with two calls up squelches and every
    call releases itself, and it re-lock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
2026-09-20 exrtl: the marker's scanner can stall, so key on it advancing
    `make net` is 17 of 17: a local dialled call, the pulse flood to
    exchange 23 with the claim and speech both ways, an own-code call that
    releases its trunk and goes local, and a code nobody has timing out to
    cannot-complete. fabric, mvp, two and trunk are unchanged and still
    pass. This closes the three failures 85bdd94 committed with.
    Both bugs are the serial bus, not slips, and both follow from the
    scanner being able to stall -- which it must, because a re-point takes
    sixteen bits while the visit it governs samples a microsecond in.
    The livelock. "A block turns over" was keyed on the octet mark and
    slot 7. A stalled scan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
    [marker.v]
2026-09-20 exrtl: what the serial bus demands of a marker
    The three findings from making exch-mainboard.md 2.3 work, written down
    in exrtl's README because the session that wrote 2.3 has exited and its
    docs are uncommitted. They belong in 2.3.2 eventually; they are the
    marker's properties and not this model's.
    Steering the probe costs a visit, and the cost lands on slot 0 of
    every block -- 00, 10, and the first line of every block of lines.
    A re-point can never complete before the visit it governs.
    Once the scanner can stall, anything keyed on "a visit happened" must
    be keyed on the scanner ADVANCING instead.
    2.3's SCLK hazard row is right; the probe half of it self-heals.
    Co-Authored-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
2026-09-20 exrtl: transit forwarding, and directions from the word
    `make chain` is new: three exchanges, 22 = 23 = 24, and a call that
    TRANSITS the middle one. 16 of 16, and the rest of the suite with it.
    This is exch-network.md 3.1's worked example one exchange shorter --
    A's 20 dials 1 2 4 2 1, B patches it onward, C claims, the claim comes
    back through B's patch, C's 21 rings, speech is bit-exact both ways over
    two hops, and release runs the whole way back.
    WHAT WENT IN
    Directions N/S/E/W, the glare bit and the strap, decoded from the
    word's option bits -- the marker read only the class before.
    The glare bit has one end of a link take the LAST free trunk facing
    that way and not the first,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
    [block.v, exch_top.v, marker.v, monitor.v, mvp_site.v, net_site.v, tb_chain.v, tb_fabric.v]
2026-09-20 exrtl: the seeker is a pool, and its rule has three terms
    exch-monitor.md 4 calls the monitor "a pool, not one a channel", and its
    sizing table -- two a block to four exchanges, three to twenty, four to
    thirty-six, five beyond -- is entirely about pool depth. It was one
    cell here, so 4's central parameter did not exist and its stated failure
    mode, "a monitor that is busy means a call this exchange owned is never
    claimed", could not happen or be tested.
    Now: one scanner over the block's eight slots on the octet mark, NMON
    cells each with its own pulse counter and state, a fresh seizure going
    to whichever is free, and none free meaning the seizure goes unwatched
    here for good. Default two.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
    [monitor.v, net_site.v, tb_monitor.v]
2026-09-20 exrtl: a claim is a request held until acknowledged
    Asked whether several monitors race, and one answer was a bug.
    The monitor's claim was a one-cycle pulse, unsafe in two places: inside
    a pool the loop wrote claim_port once a claiming cell and the last won;
    between pools the site muxed `mc0 ? mp0 : mp1`, so block 1's claim
    vanished whenever block 0's coincided.
    It is not exotic. EVERY pulse_rx counts on the same 1 kHz tick, so any
    two calls whose last pulse ended in the same millisecond decide
    TOGETHER. And the loss is the monitor's worst: the cell goes to DONE,
    the marker never hears, the trunk sits busy pointed at idle, and the
    caller times out to cannot-complete -- a call this exchan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
    [marker.v, monitor.v, net_site.v, tb_monitor.v]
2026-09-20 exrtl: the digits live in the register, as register.md 4 has them
    The register handed the marker a digit as a strobe and the marker kept
    the digit-position state. register.md 4 puts a four-digit '670 store
    and an index in the REGISTER, and the difference is the whole reason a
    register pool was a bigger change than it looked: with the state in the
    marker, a second register buys nothing.
    Now the register holds four digits and a count, and the marker reads
    them as LEVELS. `restart` begins the store again, and it makes both
    special prefixes cost nothing:
    the key 1 "the digit the flood consumes". The marker acts on it
    and restarts, so e b h s land in slots 0-3 -- exactl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
2026-09-20 exrtl: registers are a pool, and two callers may dial at once
    The marker held one call's state, so a second register bought nothing.
    2fff9a1 moved the digits into the register; this moves the rest. Each
    register now carries its own stage, caller, seized trunks and claim --
    exch-marker.md 4 and exch-network.md 3.2 put a call's state with its
    register, "a '574 a direction in a bank a register" -- and the marker is
    what acts on them, in turn, every cycle.
    NREG and NMON are parameters, both 2 by default.
    `make pool` is new, and it is the end-to-end test exch-monitor.md 4's
    sizing argument never had: both of A's lines dial exchange 23 IN
    LOCKSTEP, pulse for pulse. That puts two registers to w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
2026-09-20 exch: what building it in Verilog found
    exrtl/ now runs the exchange of these documents: the fabric, the
    mainboard and its serial bus, the supervision, MF8 trunks, and the
    common control, up to three exchanges in a chain making dialled calls
    over the pulse flood. Eight testbenches. This is the part that matters
    to the DESIGN rather than to the code.
    exch-rtl.md is new: ten things the documents did not say, or said in a
    way that does not survive contact with a second register or a second
    monitor. Each names the document and section it belongs to, because six
    of those documents are being revised in the working tree and this one
    could be written without disturbing them. Whoever reconciles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
2026-09-20 exch: the baseband trunk card, and the block's card side
    New exch/docs/exch-basebandcard.md, answering Joel's question about the
    under-spec'd single-line baseband trunk (four wires, C and A both ways):
    it is a tie trunk with nothing in between, ~4.5 packages, interchangeable
    with a subscriber line card at the socket.
    The larger half is the block's card side, which no document had specified.
    It is a star, not a bus: per-slot point-to-point lines plus a handful of
    common clocks and rails, i.e. the MF8 channel slot with the block standing
    in the MF8 trunk card's seat. Along the way: TX_HB is missing from cable A
    (cure: derive it from SLOT), MUTE has no driver in an exchange, /HUNT_INH
    is speci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
2026-09-20 exrtl: a hub and its resolvers, a ring and its strap, and 4 measured
    The three things exch-network.md 3 describes that exrtl could not run.
    net_site now takes NDIR directions -- one, two, or the three and four of
    a hub -- on blocks 0, 1, 3 and 4, and the testbenches build networks out
    of whole exchanges: five round a hub, four in a ring.
    A HUB (3.2). A transit on a chain forwards into its one other
    direction; a hub forwards into three, and the incoming trunk can listen
    to only ONE of them. So it goes on listening to idle with BUSY set --
    backward A stays 0, nothing has claimed -- while every leg listens to
    IT and the caller's pulses go down all three at once. Latches cannot be
    read back,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
    [marker.v, monitor.v, net_site.v, tb_chain.v, tb_erlang.v, tb_hub.v, tb_monitor.v, tb_net.v]
2026-09-20 exrtl: a full exchange under load, and the marker's one port bus
    Everything else in this suite drives a scenario someone thought of. This
    fits every block -- 48 lines, the two tones, six trunk channels, the whole
    64-port exchange -- and lets forty-eight callers loose on it with no
    scenario at all. `make stress` is one exchange; `make stress-pair` is two
    on a trunk 100 ppm apart, a quarter of the calls crossing it;
    `make stress-overload` is the same forty-eight thrashing a TWO-register
    exchange, where almost nothing completes and the only question is whether
    anything jams.
    net_site takes a LINE_PORTS mask now and its line side is four vectors
    instead of four pins a port, so an exchange is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
    [marker.v, net_site.v, tb_chain.v, tb_hub.v, tb_net.v, tb_pool.v, tb_ring.v, tb_stress.v]
2026-09-20 exch: a port answers to a number, and a bridge that is a group
    The marker has three hunts and each was written for one job: a class for 0
    and 9, a run of adjacent ports marked `o` for a hunt group and a bridge, a
    direction for trunks. A second operator's position, a sales desk, a pool of
    data ports, a bridge's legs and a bank of call-in lines are one request --
    the first free port of these -- and only the trunk hunt is really another.
    ONE RULE FOR ALL OF THEM BUT THE TRUNKS. A card may say it answers to a
    number. A dialled number that cannot be completed where it was dialled is
    offered to the first free port, in fixed order from 00, that says it answers
    to that number; none, and cannot-c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
2026-09-20 docs: a stock telephone on the digital line, and where the conversion sits
    A dial telephone is two wires and a bell; the exchange's port is 64 kbps of
    CVSD and one signalling bit each way. Something converts. THE QUESTION IS
    WHERE IT SITS, and there are three places, not two: in the exchange, on an
    FXS card with an analog pair going out (mf8-cards.md 3); at the subscriber,
    behind the digital line, in an adapter (this document); or at a shared site,
    one MF8 link and analog loops fanning out at the far end (exch-terminal.md).
    Two of the three are already specified. Only the adapter is new, and the
    exchange's port cannot tell them apart: its word says plain line and /ANS is
    open in all three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
2026-09-20 great removing
    [impulse_sweep.csv]
2026-09-20 tone: the in-exchange bench compares against the fabric, not a guess
    tb_tonex went in with a one-frame pipeline I had invented. The fabric
    presents the source's bit in the same frame at the frame edge, where every
    card samples C_RX -- except FILL, which alternates every frame, so the
    port's capture is a full inversion of the live signal. tb_mvp already
    compares FILL against fill_d for exactly this reason.
    With the delay removed the tone stages pass and the cannot-complete stage
    failed 500/500 -- the complement -- because its gate was in the OFF half and
    the output was FILL. So: align to the gate's phase before measuring, and
    test the gated-off case separately against fill_d. That case i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
    [tb_console.v, tb_tonex.v]
2026-09-20 console: connecting two lines, dialling a port, supervising both ends
    A NOTE, NOT A CHANGE. The files below were swept into b81859d (a tone-bench
    commit) by another session between `git add` and `git commit` here, so this
    records what that content is. Nothing in the tree changes.
    ex-console.md gains four sections and keeps 1-5 where other documents cite them:
    1.1 every conductor the console touches, and which function uses it
    6 connecting two lines. WRITE + BOTH is two crossed words in ONE tenure;
    a pair of on-hook phones rings NOTHING and is held by nothing, so 6.3
    adds the RING SOURCE -- a blank card, A_TX tied high, /ANS low, word pin
    open. Ring both end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
2026-09-21 Document MF8 shelf PSU as noisy/quiet 100×100 end boards.
    Captures the 15–18 V input, separate −48 V talk-battery and 20 Hz ring paths, and how they sit at the end of the spacer-stack.
2026-09-21 Retire conference class 111 and the secondary word path.
    Bridge legs are ordinary lines via answers-to or the o-run; a14 stays spare without a fifth '151 or PB2.
2026-09-21 Give restricted dialling options and align shared option bit frames.
    Restricted uses z/w/b/L (0-only, reserved warm, busy-inbound, local-only) with a local floor; overflow, warm, and busy share frames across classes.
2026-09-21 Extract conference into its own doc with the block/party-bus architecture.
    Move the bit-switched meet-me bridge out of exch-features and define the unit as an ordinary mainboard block with a private party bus for two×4 or one×8 leg modules.
2026-09-21 Commit MF8 to a 100×100 stack with Trunk-D/A and A-bit ring cadence.
    Adds the trunk pass pinout, sets ring at ~80 Vrms driven by far-end A, and defers C geometry and the gateway slot.
2026-09-21 Document the operator phone separately; transfer is console-only for now.
    Phone flash and register SRC attach stay deferred; features, marker, and
    register cross-refs point at operator.md for the position story.
2026-09-21 Specify a dual-tone voice-band trunk over a dry two-wire POTS pair.
    Fills network.md §1.1's missing single-channel voice-band carrier: in-band A on jumpered W/E tone pairs with notches out of the speech path.
2026-09-21 Bring exch.py flood and monitor up to the 1 e b h s pulse flood.
    Rewrite the timing arithmetic and two-digit monitor against the current
    spec, refresh exch.log, and update the measured tables in the docs.
2026-09-21 Prefer priority lines for the next free register under overload.
    Move warm to restricted-only, free line option P, and gate register
    attach with PWAIT so the scanner still walks fixed order.
    [marker.v, net_site.v, tb_priority.v]
2026-09-21 Align the calls model with tones at 01–03 and a portless register pool.
    Counter straps and topology line counts follow block 0 as services only, and failing Verilog benches now exit nonzero.
    [tb_chain.v, tb_erlang.v, tb_fabric.v, tb_monitor.v, tb_mvp.v, tb_net.v, tb_pool.v]
2026-09-21 Settle the card word and hunt by answers-to.
    Probe the dialled port, then the first free member whose word answers to
    that number; digit 0 calls pilot 04. Retire the adjacent o-run and the
    class-operator hunt for 0, and measure the rule in make groups / word.
2026-09-21 Add a hook/pulse generator so a keypad can seize and dial without a handset.
    Widen the pulse path to five bits so D counts as 16, and prove a net_site originate — local and flood — from the card.
2026-09-21 Add a mini-marker jig for local two-digit bring-up.
    The full marker is too much to debug against; this one register, no card word, and no 1-prefix, then it is thrown away when the real marker is fitted.
    [mini_marker.v, mini_site.v, tb_mini.v]
2026-09-21 Propose splitting MF8 from the exchange highway for eight channels on a 16-bit frame.
    Fusion of the highway with the line forces six payload seats; a 16-bit family frame at 1024 kbps keeps F and S, presents eight cards on collect T, and uses the slack for parity, remote alarm, and condition bits.
2026-09-21 Drive the pulse generator from hex buttons as pins, not a scanned pad.
    Each SMD key is its own net, so the card drops the row scan and encodes 1–16 with two '148s.
2026-09-22 Revert MF8 trunks to the 8-bit six-channel frame in the spec and RTL.
    [mf8_decoder.v, mf8_encoder.v, mf8_framer.v, mf8_trunk_card.v]
2026-09-22 Add ngspice CVSD encoder (type A) with alternate topologies to compare.
    Breadboard-faithful LM311/TL072/LM13700 baseline plus variants for discrete steer and LM358 op-amps, scored against the §12.1 law.
2026-09-22 Define the hook/busy interface card and four stack buses.
    Split the through-stack interconnect into HA, LEB, PWR and control, buffer control on the interface card, and spell out its cable taps, pin maps and netlist.
2026-09-22 Add ngspice CVSD decoder (type A) with recon filter and enc loopback.
    Same §12.1 engine as the encoder without the LM311; SPEC.md and a scored enc→dec test.
2026-09-22 Add KiCad placement for hook/busy lamp and interface cards.
    50×100 mm outlines with a single eight-LED hole column on the lamp
    card; pad nets assigned, not routed. Docs point at pcb/hookbusy/.
    [interface_card.kicad_pcb, interface_card.kicad_sch, lamp_card.kicad_pcb, lamp_card.kicad_sch]
2026-09-22 Pull the pulse flood out of the marker onto a network unit.
    Common control is replaceable units on shared ribbons: a solo exchange
    treats 1 as a highway, and a mini-marker plus unit is a basic flood.
    [con_site.v, marker.v, mini_marker.v, net_site.v, net_unit.v, pulse_reg.v]
2026-09-22 Add local eight-channel highway trunk and block ribbon packaging.
    Document the short-range copper trunk on the T+C adapter face (far-mastered
    RX clocks), and record the shared-board / internal ribbon / port-with-card
    physical form that face assumes.
2026-09-22 Rename the exchange 8 kHz visit mark to CLK_8K.
    Keep socket TX_OCT / a3 as the pin name so “octet” is not read as an 8-bit word width.
2026-09-22 Add SU-1 mk1 CVSD subscriber unit: Autovon pad, two-board PCB stub, and RTL.
    Packages the native CVSD phone end with pulse dialing, mute/ring logic, and make su1 coverage beside the existing pulse-gen tester.
2026-09-22 Replace the Wien/OTA analog tone card with a simple one-slot design.
    Document pots, pure/mod jumper, and a 16-step TX_CLK cadence mask so the analog build stays bench-settable without matching ROM warble SNR.
2026-09-22 Add SDU-1 mk1 subscriber data unit as an insert-1 riser on SU-D.
    32 kb/s synchronous NT reuses the voice base and S header; SU-A is not fitted, and the exchange still sees a CVSD line card.
2026-09-22 Specify dual-mode SU with a VOICE/DATA panel switch.
    Both engines share one S riser; the switch steers BIT_ENC/BIT_DEC only, and a mismatch is noise with no exchange mode bit.
2026-09-22 Claim answers-to secondary fields: dual membership, fail-closed A, and B L/U/K.
    Document that A and B are mutually exclusive tags (not a remote e b h s), stake field A as zeros-only, allow answers-to + tag 01 for a second local number, and implement field B hunt-condition flags in the marker, sim, and groups bench.
    [marker.v, tb_groups.v]
2026-09-22 Lock one name per connector and signal across the docs and RTL.
    Add common/terms.md and sweep synonyms (socket/header/ribbon, LINE_HB/LOOP_HB, card word//ANS, jumper not strap) so the same object is not renamed on every page.
2026-09-23 Model the buried 24 AWG pair and measure MF2 over a 5 km span.
    Add phy.pair_24awg, a zero-phase FFT filter for the sqrt(f) skin-effect law from
    frame-rate.md 3 (12 dB at 256 kHz over 1.7 km, scaled by length), and let
    mf8_line.rx_ami take cable_km plus impulse amp/tau/ring so MF2 and MF8 share one
    AMI path instead of forking it. New mf2_line.py span target sweeps 1.7 / 3 / 5 km
    quiet and under 40/s urban impulse (sim/mf2_span.log): 1.7 km is clean, and at
    5 km dispersion closes the AMI eye even with ideal AGC. mf2_tek.py streams
    tek.wav through channel 1 in bit-time chunks so 30 s runs stay in RAM.
2026-09-23 Record the MF8 rate-plug and 10-bit/16-state framing runs.
    Committed output for the two existing scripts that had none: mf8_baud.py, which
    lays the 512 / 640 / 1024 kbps rate plugs side by side (timing window left after
    +-10% IC tolerance, and the received fundamental against the fixed cable pole),
    and mf8_10_16.py, which shows the 16-bit superframe word surviving every payload
    lane and relocking within ~25 frames after an induced slip of any size.
2026-09-23 Split mini_marker into a register and a core, both structural MSI.
    mini_marker becomes wiring: pulse_reg + ctl_write + a new mini_core holding the
    scanner, probe, write queue and call sequencer. pulse_reg and pulse_rx are
    rebuilt out of the named parts -- HC4040 on TICK for the HIT/ID/CLR windows,
    HC175 hook synchroniser, HC163 plus a fifth FF for the saturating pulse count,
    HC670 files for the digits -- so the design reads as the board in register.md §4
    instead of as behavioral counters. pulse_rx holds RST and inhibits counting for
    four TICKs after arm, so a line already off-hook when the register seizes cannot
    flush a phantom make edge through the synchroniser. mini-net, mini-leaf and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
2026-09-23 Wire the HC MSI sources into the build and recost mini_marker at 26 packages.
    RTL gains an HC_MSI list so every bench elaborates the named parts; synth-hc-mini
    now reads only mini_marker.v against hc_bb.v shells. Costed that way the
    bring-up marker is 26 packages, inside the ~25-30 hand-BOM ballpark (register
    ≈ 12 + core ≈ 12 + serialiser 2); the old table's hundreds were expanded
    counters and the call FSM billed as SSI. The port release detectors are still
    the honest gap -- an RC and a Schmitt gate in hardware, two 15-bit counters here.
2026-09-23 Snapshot concurrent session work across docs, RTL and sim.
    Committed on request as a working-tree snapshot. Almost none of this
    originates in the session that committed it: 51 tracked files across
    exchange/, verilog/ and sim/, plus MF2 and STU-1 notes and the
    inprogress.md / inprog.v / tb_inprog.v work-in-progress files that
    another session had open at the time.
    Recorded as one commit so it can be untangled or reset as a unit.
    `make lint` fails on the mini_marker top module, which is a
    pre-existing Makefile gap -- that line omits $(HC_MSI) where the
    nano_marker line includes it -- and not a consequence of these changes.
    [hc_bb.v, inprog.v, marker.v, mf8_trunk_card.v]
2026-09-23 Keep the option word at sixteen bits by spending dead pairings.
    The previous layout reordered the fields and moved the kind code into
    the secondary. A better answer needs no reordering at all: extensions.md
    2.2 already declares six of its sixteen type-by-tag pairings out of
    service, each carrying six payload bits where a nine-bit port needs
    three. Spending two of them buys the target with every anchor left
    where it was -- tt at bit-times 0-1, the family at 2-3, the tag at 8-9 --
    so every prefix decode survives untouched.
    One rule inverts: for a port form an FF secondary is now OOS. It has to,
    because a target-bearing card needs two '165 at nine bits whatever the
    layout, and without it a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
2026-09-23 Spec a fabric that grows: more highways, eight slots, A in a sacrificed cell.
    Reconciles this session's decisions with three findings that came out of
    costing them.
    The slot stays three bits and the extra address goes to the highway.
    Sixteen slots doubles the block header to 96 signals, ends the rule that
    one highway is one MF8 group, and breaks A: the A cycle becomes 250 us
    against a 125 us visit, and because both counters divide one crystal the
    phase is fixed, so the same eight slots of sixteen are invisible for
    ever. At eight slots one sacrificed slot is exactly right -- a 109 us
    cycle inside the visit -- which is the shape already decided.
    The port selects among up to 32 highways, fou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
2026-09-23 Redefine the block and the port for a folded-A fabric.
    Rewrites fabric-rev2 around the two definitions the design actually
    needs, and corrects the previous version's framing.
    A does not leave the highway. It is time-interleaved into one
    sacrificed slot a block, following clock_card.v's existing frame_in_oct,
    so every port still captures its correspondent's A off the highway and a
    trunk still forwards port_a_rx unchanged -- the fabric path that holds a
    call up is untouched. What moves is the MARKER's copy of M, to a third
    probe commutator addressed by SCAN like BUSY and the word already are,
    because a probe serves one reader at one port and a highway serves 64 at
    once, and only the second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
2026-09-23 Separate the scan into levels and words, and restore the size ceiling.
    The levels floor is one CELL, not one frame: block.v:110 already
    commutates all eight of a block's A per cell on SLOT, so a scanner whose
    low bits track SLOT matches every cell -- 1.953 us a port, 8x faster with
    the present block re-point and 72x with SCAN widened.
    But the ceiling does not move, and the previous commit was wrong to
    retract it. The flood hop is a hunt, a hunt reads the card word at every
    port, and words cannot be read faster at any scan rate: line_card.v:54
    reloads every card on the same frame_stb && tx_oct, so the whole exchange
    is in one bit-time at one instant and the bus yields one port-word per
    125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
2026-09-23 Drop the M probe: the marker can count frames itself.
    Decision: the scan is not widened. Nine milliseconds is the budget, and
    the levels pass meets it without touching cable B.
    That deletes the third probe commutator this document proposed an hour
    ago. Its job was never speed; it was to keep the marker's M read working
    once A is folded into a sacrificed cell. But marker.v:31 declares
    frame_stb and uses it at no line, and oct_stb is beside it, so a 3-bit
    counter between them gives frame_in_oct locally and the capture becomes
    slotq == A_SLOT && frame == scan[2:0]. Half a package on one card,
    against one '151 a block -- eight packages at 64 ports, thirty-two at
    256 -- plus a conductor and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
2026-09-23 Six signals a slot, not seven: fix the line the secondary word left behind.
    common-cards.md contradicted itself. Section 1.2 states the normative
    count -- "The per-slot count is six. C_TX, A_TX, C_RX, A_RX, the card
    word, /ANS -- 6 a slot, 48 a block. Pin a14 is spare" -- while the
    portability bullet at :196 still said seven.
    Seven was correct in the era when a14 carried the secondary word, and the
    commit that retired that path changed the count back everywhere except
    this bullet. Naming them settles it: six per-slot SIGNALS on seven
    per-slot PINS, a14 carrying none. The arithmetic agrees, since 6 x 8 =
    48 is the block header's appearances and 48 + 16 power fills the 64-way
    exactly.
    C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
2026-09-24 Back to 64 addresses: strip both specs to the folded 8x8 fabric.
    The port address is six bits again -- two-digit h s, eight highways of
    eight slots, slot 4 the A cell -- so most of what these two documents
    carried was solving problems that no longer exist.
    fabric-rev2 is now one change and its consequences: A time-interleaved
    into slot 4 on the C highway, following clock_card.v's frame_in_oct.
    Eight highway conductors instead of sixteen, cable A 31 signals to 23.
    The port LOSES a package -- the A highway-select goes and only a quarter
    '02 comes back -- which is the first change in this design that has made
    a port cheaper. The block loses a '244 and gains half a '157. Seven
    seats a block,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
2026-09-24 Settle fabric.md 3.1's total: the stated 15.25 is right, the list is not.
    Section 2's warning said the base was unsound. It is not -- the total is
    sound and the printed list is what needs editing.
    Fifteen and a quarter is the figure four places carry and the only one
    that reproduces fabric.md 5: a fitted block is 8 x 8.25 + 15.25 = 81.25,
    printed at :314 as about 82, and eight of those is 656, printed at :315
    as about 655. On 18.25 they would be 84.25 and 674, which reproduce
    neither. mainboard.md:186 reaches the same number from the block's side.
    Where the three packages went is now identified: two are the 2 x '32
    backward-A row, which its own note marks trunk-only, so on the list's
    ba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
2026-09-25 Retire verilog/ to old/verilog/ and add newimpl/: the fold on three wires, a debugger card and a CVSD line card.
    newimpl/ is the exchange rebuilt around scanner-addressed open-collector
    conductors: /HA carries M, /HB carries BUSY -- one bit-time a port, a 1 ms
    pass, pass_stb IS tick_1k -- and /HW carries the card option word, marker-
    addressed at 64 kHz. PB is gone. SCAN is six bits and exactly the divider
    stages between TX_CLK and TICK.
    Fixed on the way: the partial-dial timer (pulse_reg gated it on ndig == 0,
    so one digit and silence held the only register for ever); pulse_rx's
    `counting`, which never fell; NODIG to the documented 10 s; a port's number
    now follows its mainboard shunt, n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
    [bitpath.v, block.v, clock_card.v, common_card.v, con_site.v, console.v, ctl_write.v, cvsd_line_card.v]
2026-09-25 Bring the network unit up beside the mini marker in a third top: net_unit, a second cable-B master, the baseband tie card, and dialled floods across two and three exchanges.
    Joel's decisions of 2026-09-25 (newimpl/PORT.md section 0): top_net fits the
    unit beside the same mini marker; the unit is a second cable-B master ranked
    above the marker on /UREQ; the monitors live on the unit; a trunk card says
    what it is in its own word, read off /HW, and no jumper anywhere repeats it;
    8 or 9 as the second digit is cannot-complete; the 2 s claim wait runs from b.
    New: rtl/net_unit.v, ctl_queue.v, word_rx.v, baseband_card.v, top_net.v;
    tb/tb_word, tb_tie, tb_net (15 scenarios), tb_chain (4), site_net;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
2026-09-25 One bus on a 2x25 header, five lines merged into SLOT2 and SCAN, the mini and nano markers in one document, and Icarus out of the test sequence.
    - exchange/mainboard.md 3.4, 3.5: the bus as 31 signals in six groups on one
    2x25 header, how it is cabled (direct mate, bridge or ribbon on one
    footprint), ringing kept off it; and what left the bus: LINE_HB, and
    TX_CLK, TX_OCT, RX_OCT, FILL and TICK, which each block now makes from
    SLOT2 and SCAN (rtl/frame_decode.v). FILL is SCAN0 and TICK is SCAN5; the
    marker and the unit take the 1 ms edge off SCAN.
    - The debugger (new exchange/debugger.md) loses FILL_SCAN0 and takes its pass
    off its own scanner mirror: eleven lamps. The spec's chec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
2026-09-25 Name a card on /WS in its port's own bit-time: the pointing word leaves cable B, the unit's sweep drops to 9 ms on a stride of 9, the classifier reads ahead of it, and net gains two calls at once and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
2026-09-25 The local eight-channel trunk is RTL on a block header, dialled across and slipping only one bit at a time: local_trunk.v with HCLK on the commons' spare, tb_ltu patching sixteen channels through 100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
    tb_ltu's slip-on-A section (a bare pair of units, A slipping in all sixteen
    directions) is telco-b6's. Its tb_lfull and tb_lchain are not in this commit.
    15 benches, 394 checks, lint clean, run on this exact tree.
    [local_trunk.v, site_net.v, tb_lnet.v, tb_ltu.v, top_net.v]
2026-09-26 Leave a glared channel to the origin: the unit's classifier skips every port the unit has seized itself, so two callers who take the last free channel together are joined (tb_lfull 5 green, F35 red w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
    [net_unit.v, tb_lfull.v]
2026-09-26 Hold the register until a connected call can release itself, and let no line hold it for ever: the no-digit timer runs through a digit in progress, and the mini marker watches the caller after a conn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
    A line that pulses without ever making for ID was part way into a digit for
    ever, and the no-digit timer paused for it, so a bad dial or a hand on the hook
    switch held the exchange's only register until it hung up. The timer now
    restarts only at a completed digit.
    A caller who hung up from the last digit to 14 ms after the connect write left
    the called port BUSY with no edge ever to release it: unreachable, then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
2026-09-26 Size the subscriber line transformer by measurement: L/R ≥ 2.5 cells (≥ 4 mH at 64 kbps), Murata 78615/9C, and subline.py xfmr to show it.
2026-09-26 Nail one way: a tied nail writes its own port, listening to its dest, and never the dest, so a source may be nailed and nothing waits for the dest to be free; a private line, a ringdown or a data cir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
2026-09-26 Rewrite the spec to describe what newimpl builds, each topic said once: exchange/ is twelve documents of the design as built (numbering, fabric with the /HA /HB /HW /WS planes it never had, bus, bloc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
2026-09-26 Retire the RevA and RevB port card PCBs as obsolete (Joel, 2026-09-26).
    pcb/portcard_RevA (the first generated schematic and placed board) and
    pcb/portcard_RevB (RevA plus ten port-state LEDs, D5-D14, and RN4/RN5)
    were deleted from the working tree. Neither was ever tracked, so this
    commit carries no file changes: it records the removal. RevB's
    schematic and board survive in pcb/portcard_RevC, identical but for the
    project name and the title block's revision letter.
2026-09-26 portcard RevC re-layout
    [cr.kicad_sch, det.kicad_sch, portcard_RevC.kicad_pcb, portcard_RevC.kicad_sch]
2026-09-26 Block stack on two 2x25, the header as blkhdr_bus_RevA and blkhdr_logic_RevA (Joel, 2026-09-26): J1 on the left carries the 19 clock-class lines in a checkerboard, each beside only GND, +5V or a stat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
    [blkhdr_bus_RevA.kicad_pcb, blkhdr_bus_RevA.kicad_sch, blkhdr_logic_RevA.kicad_pcb, blkhdr_logic_RevA.kicad_sch, rst.kicad_sch]
2026-09-26 The markers and the network unit in 74HC, as a plan of record: newimpl/REFACTOR.md names what keeps the RTL from being drawn as boards (a model write queue, copies of latches, comparators where a boa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
2026-09-27 The port card is pcb/portcard_RevC, on the two-2x25 stack (Joel, 2026-09-26): pcb/portcard, the generated copy, is gone (and the untracked pcb/hdrbus and pcb/hdrlogic with it), every tool points at p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
    [blkhdr_bus_RevA.kicad_pcb, blkhdr_logic_RevA.kicad_pcb, portcard.kicad_pcb, portcard.kicad_sch, portcard_RevC.kicad_pcb, portcard_RevC.kicad_sch]
2026-09-27 Only a named check makes a fault red (refactor S0): faults.py gives each fault one verdict -- RED from a failed check, GREEN, TIMEOUT, BROKEN or NOT-APPLIED -- and exits non-zero unless every verdict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
    [tb_net.v]
2026-09-27 Header B routed, its lamps grouped by register (Joel, 2026-09-26): hook D1-D8 on the left beside U21, BUSY D9-D16 on the right beside U22, slot 0 first in each, the row still at an even 5.0 mm and to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
    [blkhdr_logic_RevA.kicad_pcb, blkhdr_logic_RevA.kicad_sch]
2026-09-27 Header A routed on the moved stack but for five connections (TX_OCT and TX_CLK_S at U5, B_SCAN4, B_HC2 and B_HC3 at U3), no copper errors, schematic parity 0, one dangling via (a warning); an interim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
    [blkhdr_bus_RevA.kicad_pcb]
2026-09-27 Header A routed but for three connections, all long runs across the board: B_HC4 from the HC ROUTE jumper and B_SCAN4 from the bus to U3 at the back right, and HC6 from U4 to J2. No copper errors, sc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
    [blkhdr_bus_RevA.kicad_pcb]
2026-09-27 portcard_RevC routed on the two-2x25 stack but for eleven connections: five of U1's control-word inputs (SRC1-4, BSY) from J2 on the far side, five strobes (/STB1-3, /STB5, /STB7) from J1 to U3, and 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
    [portcard_RevC.kicad_pcb]
2026-09-27 Pulse-flood load and race study: the report, the traffic-load harness, every audit, load-study and verification bench, the tested fix copies and their logs, in newimpl/flood-study.
    The one register an exchange sets capacity (9-16 % of incoming network calls refused at design load) and two-way overload collapses to zero goodput; no wrong number or leak in over 4,500 random-traffic attempts, while directed and fault scenarios confirm twenty defect clusters (silent wrong numbers C03, C05, C07; stuck state C01, C08, C17), most with a tested fix of a gate to about two packages. Moved from the gitignored newimpl/build/flood; snapshot/ is the RTL the study ran on (645f9ef plus that morning's workin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
    [agg.py, an.py, an_c3.py, an_model.py, attrib.py, baseband_card.v, block.v, calls.py]
2026-09-27 The pulse-flood study's improvements (newimpl/flood-study/REPORT.md §6, point by point in its new §6.8). The origin connects at the claim. A claim is given a claim register, a second register card in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
    [baseband_card.v, local_trunk.v, marker.v, mini_marker.v, net_unit.v, pulse_reg.v, pulse_rx.v]
2026-09-27 A resolver takes a leg's claim on four samples of M, the same rule as the origin. One sample was a glitch, and it dropped every other leg. tb_fl_fwd 6: 2 ms on the east leg is no claim, 8 ms is; F62 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
    [net_unit.v, tb_fl_fwd.v]
